VikingMotorsports/Battery-Management-System-Capstone-2026/docs/Final_Project_Report/Section_7.tex

Our test plan consists of a top-down test and the bottom-up subsystem tests. These tests will test Overvoltage, Undervoltage, and Overcurrent and the system will set the signal for the Shutdown Circuit and report each specific fault to the ECU with which specific cell(s) had the fault. The full Test plan is in the Appendices.
