VikingMotorsports/Battery-Management-System-Capstone-2026/docs/Final_Project_Report/glossary.tex

\makeglossaries
\newacronym{vms}{VMS}{Viking Motorsports}
\newacronym{bms}{BMS}{Battery Management System}
\newacronym{ecu}{ECU}{Energy Control Unit}
\newacronym{can}{CAN}{Control Area Network}
\newacronym{can-fd}{CAN-FD}{\gls{can} Fast Data}
\newacronym{bmu}{BMU}{Battery Management Unit}
\newacronym{i2c}{I$^2$C}{Inter-Integrated Circuit}
\newacronym{led}{LED}{Light Emitting Diode}
\newacronym{lv}{LV}{Low Voltage}
\newacronym{hv}{HV}{High Voltage}
\newacronym{usb}{USB}{Universal Serial Bus}
\newacronym{mvp}{MVP}{Minimal Viable Product}
\newacronym{pcb}{PCB}{Printed Circuit Board}
