VikingMotorsports/Battery-Management-System-Capstone-2026/docs/Final_Project_Report/Section_4.tex

\subsection{Objectives}

The main objective of our project is to have a functional prototype or \gls{mvp} and creating extensive documentation featuring design decision with our reasoning, a user's guide, and a developer's manual to assemble the full battery back. While there was some expectation to have our prototype go through one design iteration with \gls{pcb}, our team wasn't able to order the boards early enough and such we had to go with a prototype using the evualtion boards.

\subsection{Deliverables}

While intialy using the Atlassian suite of tools of Jira and Confluence, we moved to google drive and github repository so that we can transfer ownership to \gls{vms} to deliver on the following

\begin{itemize}
	\item Project proposal
	\item Weekly Progress Reports
	\item Final report
	\item ECE Capstone Poster Session poster
	\item Detailed design documentation, explaining what your design does, how your design works, and why you made the decisions you did
	\item Electrical CAD: Schematics and board layouts, including output files (Gerbers, PDFs, etc)
	\item Mechanical CAD: enclosures, mechanisms, including output files (STLs, PDFs, etc)
	\item Bill of materials and pricing
	\item Developer's manual for future teams improveing on the existing design
	\item Short user manuals documenting how to use your creation
	\item A working prototype with a prototype battery pack and functionality with the \gls{ecu} prototype.
\end{itemize}
