VikingMotorsports/Battery-Management-System-Capstone-2026/docs/Final_Project_Report/Section_2.tex

\gls{vms} is our sponsor. They are a medium-sized student group that participates in the Formula SAE Electric event.

Electric vehicles rely entirely on large battery packs as their primary energy source. These battery packs are made up of many individual cells, typically lithium-ion, that must operate within some strict electrical and thermal limits and requirements in order for them to remain safe, efficient, and long-lasting. Due to the fact that lithium-ion battery chemistry is sensitive to properties such as overcharging, over-discharging, overheating/temperature, and cell imbalance, electric vehicles often require a dedicated subsystem called the \gls{bms}, to monitor and protect the battery.

These systems exist because lithium-ion battery packs can be extremely dangerous if not carefully monitored and diagnosed. The individual cells can be damaged due to things such as overcharging, over-discharging, and overheating. So, electric vehicles incorporate a battery management system to act as a protective mechanism using a combination of sensing, diagnostics, and protective circuit logic within the system. The system ensures that the battery operates only within safe electrical and thermal limits, which can in turn improve safety, extend battery life, and optimize performance.

The battery management system continuously measures key parameters such as cell voltages, current flow, pack and cell temperatures, and the estimated state of charge. It then processes the data to compute additional metrics, such as pack health, state of energy, imbalance levels, and thermal stability. In addition to monitoring, the \gls{bms} controls balancing circuitry using techniques such as active or passive cell balancing, to keep individual cells at consistent charge levels. Additionally, the \gls{bms} manages protective actions such as overvoltage, undervoltage, and overcurrent cutoffs. Also, the \gls{bms} communicates diagnostic information, warnings, and operational status to the vehicle’s electronic control unit.

Within the larger electric vehicle system, the \gls{bms} serves as the central system responsible for determining whether the high-voltage battery pack is in a safe condition to deliver power to the vehicle. For instance, the electronic control unit depends on the \gls{bms} for accurate state of charge information, temperature status, and diagnostic reports. The motor, motor controller, charger, and thermal management system all rely on \gls{bms} outputs to function properly. Therefore, the \gls{bms} is not an isolated system but rather a core subsystem and safety component that interfaces with a lot of other components in the vehicle.

In practice, a battery management system is an electronic system that manages a rechargeable battery pack. Its operation follows a continuous loop of measure, protect, balance, and inform. First, it measures the fundamental state of the battery by using a network of sensors and integrated circuits to read the voltage of every individual cell, the total current flowing in or out of the pack, and its temperature at key locations. Second, it uses this data to protect the battery from damage by comparing the readings against safe limits. For instance, if it detects a dangerous condition like overvoltage, undervoltage, overcurrent, or extreme temperatures, it will command a safe shutdown by disconnecting the pack. Third, to maximize the pack’s capacity and longevity, it balances the cells, using techniques such as active or passive cell balancing to bleed off excess charge from higher voltage cells, ensuring all cells reach a uniform state of charge. Finally, it informs the larger system by processing the raw measurements into useful information such as state of charge and health, and it communicates this data, along with any warnings, to other devices.

According to the project description provided by Viking Motorsports, the electrical team has completed early conceptual research for the Formula SAE Electric platform. This foundational work includes preliminary investigation into CAN bus communication for vehicle subsystem networking, initial evaluation of cell monitoring integrated circuits and measurement topologies for per-cell voltage sensing, and high-level planning of the system-level safety architecture required to meet Formula SAE Electric fail-safe shutdown and interlock rules. These efforts established an initial understanding of the technical challenges and constraints associated with a high-voltage accumulator system but did not result in an implemented or tested \gls{bms} design.

At the start of this capstone project, no functional \gls{bms} hardware or firmware prototype exists, and there is no previous generation of a Viking Motorsports \gls{bms} to revise or extend. As a result, this project represents a ground-up design and development effort rather than an incremental revision. Our team is responsible for transforming the sponsor’s early conceptual research into a testable \gls{bms} prototype that performs real-time measurement, protection, balancing, and diagnostic functions that are suitable for future vehicle integration.

If nothing has been done on this project yet, are there comparable products or existing alternatives? Be creative here, what are similar technologies or direct competitors? Include them if they’re relevant or help describe your project.

See commercial off the shelf products and open source projects sections of the project proposal.

\subsection{Research}

\begin{figure}[H]
	
\end{figure}

\subsubsection{Commercial Off-the-Shelf Products}
Here are some options available to us for this project:

\begin{enumerate}
	\item \textbf{Orion \gls{bms} 2:} The Orion \gls{bms} 2 is a widely adopted \textbf{Centralized} solution in the FSAE and EV conversion sectors. While it integrates all measurement and control units into a single enclosure, offering mature reliability and EMI immunity, its architecture requires routing extensive sensing harnesses from all points of the battery pack to a central controller. This results in complex wiring and increased system weight. This serves as a critical counter-reference for our project: while centralized designs offer EMI advantages, their disadvantages in harness management within a high-voltage (300V+) and weight-critical racing environment validate our decision to pursue a Distributed Architecture.
	
	\item \textbf{Stafl Systems \gls{bms}1000M:} Stafl Systems utilizes a \textbf{Master-Slave Distributed Topology}. The system consists of a master controller (\gls{bms}1000M) and multiple satellite monitoring modules (\gls{bms}1101S), utilizing differential signaling (e.g., IsoSPI) for communication. This architecture significantly reduces the length of analog sensing wires, effectively lowering wiring complexity within the high-voltage pack. As a direct industry benchmark, Stafl demonstrates the engineering feasibility of distributed architectures for segmented packs. However, its Closed-Source nature limits secondary development for specific research algorithms, restricting its role to a hardware architecture reference.
	
	\item \textbf{EMUS G1 \gls{bms}:} EMUS G1 demonstrates a highly \textbf{Modular} distributed strategy, supporting the connection of multiple independent battery modules via CAN bus. This product employs robust galvanic isolation strategies and communication protocols ideal for physically separated battery enclosures (e.g., side-pod layouts). Given the potential requirement to split our 400V pack into multiple physical modules, EMUS provides a critical technical reference for High-Voltage Galvanic Isolation and data synchronization in our safety loop design.
\end{enumerate}

\subsubsection{Open Source Projects}
Here are some projects we can borrow from:

\begin{enumerate}
	\item \href{https://docs.fox\gls{bms}.org/}{fox\gls{bms} 2:} fox\gls{bms} 2 is a comprehensive, professionally developed open-source \gls{bms} platform from the Fraunhofer research institute, explicitly designed as a research and development platform for high-performance, high-availability battery systems. Its architecture is a master-slave distributed topology, where a central \gls{bms}-Master (ARM Cortex-R5) communicates via an interface board with daisy-chained Slave boards that handle cell monitoring (voltage/temperature) and passive balancing. The primary benefit is its exceptional depth. For instance, it offers a complete, well-documented hardware and software stack, including a built-in interlock line for safety shutdowns, CAN bus communication for system integration, and a flexible design that supports from a few cells up to several hundred kWh. The permissive licenses allow full use and modification. The notable drawback is its scale and complexity. For instance, as a generic research platform, it is not optimized for the strict space, weight, and FSAE-rule constraints of a race car. Its default use case is stationary storage, requiring significant adaptation for a mobile, high-vibration environment such as a race car. Nonetheless, it still serves as a great resource for robust system architecture, safety implementations such as interlock monitoring, and professional-grade, modular firmware structure.
	
	\item \href{https://libre.solar/\gls{bms}-c1/manual/}{Libre Solar \gls{bms}:} The Libre Solar \gls{bms} is a compact, fully integrated open-source \gls{bms} designed for stationary and small-scale mobile DC energy systems (12V-48V, up to 16 cells). Its architecture is highly centralized, combining the \gls{bms} Analog Front-End (Texas Instruments BQ76952), microcontroller (ESP32-C3), power MOSFETs, and communication interfaces (CAN, UART, I2C, USB, Bluetooth) on a single PCB. The primary benefit is its production-ready, all-in-one design that demonstrates efficient integration of core \gls{bms} functions such as cell monitoring, protection, passive balancing, and contactor control, within a minimal footprint. Its firmware, built on the Zephyr RTOS, provides a professional reference for implementing safety logic, the ThingSet protocol for configuration, and state-of-charge estimation. The notable drawback is its scale. For instance, it is designed for ~60V systems with currents up to 100A, its cell count and power handling are far below the requirements of a 400V+ FSAE powertrain. Its centralized architecture is also less ideal for the long, distributed battery pack typical in a race car frame. Nonetheless, it still serves as an excellent reference for PCB-level integration, component selection, and a clean, modular firmware structure that can inform the design of sub-modules within our larger, distributed system.
	
	\item \href{https://hackaday.io/project/181453-green-\gls{bms}}{Green \gls{bms}:} Green \gls{bms} is a hobbyist-developed, smart \gls{bms} designed for small-scale lithium battery packs such as for electric scooters or solar storage. Its architecture is a modular distributed system, using simple Cell Modules based on ATtiny microcontrollers to measure individual cell voltage/temperature, which report via I2C to a central Control Unit (Arduino Mega). The system includes a separate "Limiter" unit for contactor control and an Android app for monitoring. The primary benefit is its exceptional transparency and simplicity, it demonstrates the absolute core functions of a \gls{bms} (monitoring, protection, balancing) with minimal complexity, using widely understood components (Arduino, ATtiny). This makes it an excellent educational tool for understanding the fundamental data flow and logic of a \gls{bms} before engaging with more complex, integrated circuits. The significant drawbacks are its lack of automotive robustness, missing critical safety features (high-voltage isolation, CAN bus, fail-safe hardware interlocks), and limited scalability (I2C communication is unsuitable for long daisy-chains in a large pack). Nonetheless, it still serves as a valuable conceptual reference for system partitioning and basic 
\end{enumerate}

\subsubsection{Papers}
Here is some extra papers we read during our research:

\begin{enumerate}
	\item \href{https://web.archive.org/web/20200508032842id_/https://eprint.ncl.ac.uk/file_store/production/261931/F4ADEC30-2EDD-4881-A81A-AC0BFDE3D9EB.pdf}{Evaluation and Comparison of Battery Cell Balancing Methods:} This paper provides a structured, quantitative framework for selecting a cell balancing topology, directly addressing a key design decision. It categorizes and compares the three main balancing methods, dissipative (passive), capacitive energy transfer (active), and runtime balancing (active with converters), against critical metrics such as balancing speed, efficiency, complexity, and cost. This comparison is very valuable for our requirement to “support both active and passive cell balancing.” It provides an objective basis to decide whether to implement only passive (simpler, cheaper) or also include an active method (faster, more efficient) in our prototype.
	
	\item \href{https://ieeexplore.ieee.org/stamp/stamp.jsp?arnumber=8834858}{Review of Battery Cell Balancing Methodologies for Optimizing Battery Pack Performance in Electric Vehicles:} This paper provides a critical system-level perspective on cell balancing for batteries in electric vehicles, advocating for hybrid balancing methods that combine passive and active balancing techniques to leverage their respective advantages. This directly aligns with our requirement to “support both active and passive cell balancing,” suggesting an approach where both techniques work together in a complimentary manner (passive for continuous maintenance, active for rapid pre-charge equalization). Additionally, it highlights environmental factors, specifically operating temperature, thermal uniformity, and mechanical vibration, as crucial but under-researched variables that affect long-term balancing performance and cell degradation.
	
	\item \href{https://ieeexplore.ieee.org/stamp/stamp.jsp?arnumber=8320763}{State-of-the-Art and Energy Management System of Lithium-Ion Batteries in Electric Vehicle Applications: Issues and Recommendations:} This paper provides a holistic overview of Li-ion battery technology and the complete scope of a Battery Management System (\gls{bms}). It systematically covers core \gls{bms} functions critical to our project, such as cell condition monitoring, state estimation (SOC/SOH), charge/discharge control, protection circuitry, cell equalization, and thermal management. It is particularly valuable for understanding the interdependencies between different \gls{bms} subsystems and for identifying key challenges, such as managing temperature gradients and diagnosing faults, which are actively relevant to the harsh, high-vibration environment of a Formula SAE vehicle.
\end{enumerate}

%  Add extra research HERE
