VikingMotorsports/Battery-Management-System-Capstone-2026/docs/VB-Devices In Consideration-120626-191535.pdf

Devices In Consideration

What it comes with:

Boards

2x EVAL-ADBMS6830BMSW 16-Channel Battery Cell Monitor (can be purchased separately)

1x EVAL-ADBMS2950-BASIC Battery Pack Monitor (can be purchased separately)

1x EVAL-ADBMS6822 Dual isoSPI Adapter (can be purchased separately)

1x EVAL-SDP-CK1Z (SDP-K1) Controller Board (can be purchased separately)

2x DC2472A Battery Cell Emulator (can be purchased separately)

1x MAX32625PICO Programming Adapter with 10-pin SWD cable (can be purchased separately)

Cables and Other Accessories

2x Cell Connector Block (18-cell connector)

3x DuraClik isoSPI Twisted Pair Cables

3x USB Type A to Micro-B Cable

3x Alligator Clip / Test Lead

What it does:

Accurate voltage and current measurement

Highly scalable and ease of integration

Robust isoSPI capability implementable in daisy chain high count

Inclusive passive balancing with individual pulse-width modulation

Isolated power supply between microcontroller and battery monitoring devices

High voltage and current supply measurement

Fast overcurrent (OC) measurement

Redundancy measurement

Modular BMS Solution

Ready to use Broadmarket BMS GUI for Evaluation

Isolation:

Analog Devices (more common in UART-style isolation)

AD-CELLPACKBM-SL (https://www.analog.com/en/resources/evaluation-hardware-and-software/evaluation-boards-kits/ad-cellpackbm-sl.html)
