VikingMotorsports/Battery-Management-System-Capstone-2026/Hardware/CMU BOM.xlsx

CMU BOM
Ref | Qty | IC / Function | Manufacturer Part Number | DigiKey Part Number | Package | Notes | Links
C1-C18, C20-C28, C30-C37 | 35 | 0.47uF capacitor | CS0805KKX7R9BB474 | 13-CS0805KKX7R9BB474CT-ND | 0805 SMD | 0.47uF, 50V, X7R, ±10%. | https://www.digikey.com/en/products/detail/yageo/CS0805KKX7R9BB474/6097940
C19, C29, C38-C40, C47 | 6 | 100pF capacitor | CC0805KRNPO9BN101 | 311-4295-1-ND | 0805 SMD | 100pF, 50V, C0G/NP0. | https://www.digikey.com/en/products/detail/yageo/CC0805KRNPO9BN101/5884169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
C41, C46, C48 | 3 | 1uF capacitor | C0805C105K5RACTU | 399-C0805C105K5RACTUCT-ND | 0805 SMD | 1uF, 50V, X7R, ±10%. | https://www.digikey.com/en/products/detail/kemet/C0805C105K5RACTU/3317615
C42, C43, C51-C58 | 10 | 0.1uF / 100nF capacitor | C0805X104K050T | 4587-C0805X104K050TCT-ND | 0805 SMD | 0.1uF, 50V, X7R, ±10%. | https://www.digikey.com/en/products/detail/holy-stone-enterprise-co-ltd/C0805X104K050T/16895237
C44 | 1 | 0.22uF capacitor | 885382207008 | 732-13196-1-ND | 0805 SMD | 0.22uF, 50V, X7R, ±10%. | https://www.digikey.com/en/products/detail/w%C3%BCrth-elektronik/885382207008/9816351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
C45 | 1 | 10nF capacitor | C0805C103K5RECAUTO | 399-17885-1-ND | 0805 SMD | 10nF, 50V, X7R, ±10%. | https://www.digikey.com/en/products/detail/kemet/C0805C103K5RECAUTO/8640479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
C49 | 1 | 4.7uF capacitor | C0805X475K025T | 4587-C0805X475K025TCT-ND | 0805 SMD | 4.7uF, 25V, X7R, ±10%. | https://www.digikey.com/en/products/detail/holy-stone-enterprise-co-ltd/C0805X475K025T/16895241
C50 | 1 | 2.2uF capacitor | 885012207079 | 732-7673-1-ND | 0805 SMD | 2.2uF, 25V, X7R, ±10%. | https://www.digikey.com/en/products/detail/w%C3%BCrth-elektronik/885012207079/5453528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
D1 | 1 | Status LED | LTST-C170KGKT | 160-1414-1-ND | 0805 SMD | Green LED. | https://www.digikey.com/en/products/detail/liteon/LTST-C170KGKT/386777?s=N4IgTCBcDaIIwDYAMBaOAWDaUDkAiIAugL5A
J1 | 1 | TEST header | 61300211121 | 732-5315-ND | 1x02, 2.54mm | Vertical 2-pin header. | https://www.digikey.com/en/products/detail/w%C3%BCrth-elektronik/61300211121/4846823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
J2, J5 | 2 | LOW SIDE / HIGH SIDE connector | 705510038 | WM14059-ND | 4-position, 2.54mm, right angle | Molex right-angle header. | https://www.digikey.com/en/products/detail/molex/0705510038/3468768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
J3 | 1 | 12S header | 61300211121 | 732-5315-ND | 1x02, 2.54mm | Vertical 2-pin header. | https://www.digikey.com/en/products/detail/w%C3%BCrth-elektronik/61300211121/4846823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
J4 | 1 | Board connector | 705550056 | 0705550056-ND | 22-position, 2.54mm, right angle | Molex right-angle header. Confirm exact function. | https://www.digikey.com/en/products/detail/molex/0705550056/3302485?s=N4IgTCBcDaIAwHY4FZVxQNgLQDkAiIAugL5A
J6-J13 | 8 | NTC headers | 61300211121 | 732-5315-ND | 1x02, 2.54mm | Vertical 2-pin headers for NTC sensors. | https://www.digikey.com/en/products/detail/w%C3%BCrth-elektronik/61300211121/4846823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
R1-R9, R23-R30 | 17 | 10Ω resistor | RC1210FR-0710RL | 13-RC1210FR-0710RLCT-ND | 1210 SMD | 10Ω, ±1%, 1/2W, thick film resistor. | https://www.digikey.com/en/products/detail/yageo/RC1210FR-0710RL/5919199
R10, R11, R21, R22, R48, R49, R53, R54 | 8 | 0Ω jumper resistor | RC0805JR-070RL | 311-0.0ARCT-ND | 0805 SMD | 0Ω jumper, 1/8W, thick film resistor. | https://www.digikey.com/en/products/detail/yageo/RC0805JR-070RL/728216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
R12-R20, R33-R40 | 17 | 100Ω resistor | RC0805FR-07100RL | 311-100CRCT-ND | 0805 SMD | 100Ω, ±1%, 1/8W, thick film resistor. | https://www.digikey.com/en/products/detail/yageo/RC0805FR-07100RL/727543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
R31, R32, R45, R46 | 4 | 51Ω resistor | RC0805FR-0751RL | 311-51.0CRCT-ND | 0805 SMD | 51Ω, ±1%, 1/8W, thick film resistor. | https://www.digikey.com/en/products/detail/yageo/RC0805FR-0751RL/728012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
R41-R44 | 4 | 499Ω resistor | RC0805FR-07499RL | 311-499CRCT-ND | 0805 SMD | 499Ω, ±1%, 1/8W, thick film resistor. | https://www.digikey.com/en/products/detail/yageo/RC0805FR-07499RL/727986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
R47 | 1 | 30Ω resistor | RMC1/2K30R0FTE | 2315-RMC1/2K30R0FTETR-ND | 2010 SMD | 30Ω, ±1%, high-power resistor. Verify power rating. | https://www.digikey.com/en/products/detail/kamaya-inc/RMC1-2K30R0FTE/17822375
R50 | 1 | 100Ω resistor | RMCF2010FT100R | RMCF2010FT100RCT-ND | 2010 SMD | 100Ω, ±1%, 3/4W, thick film resistor. | https://www.digikey.com/en/products/detail/stackpole-electronics-inc/RMCF2010FT100R/1758424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
R51 | 1 | 200Ω resistor | RMCF2010FT200R | RMCF2010FT200RCT-ND | 2010 SMD | 200Ω, ±1%, 3/4W, thick film resistor. | https://www.digikey.com/en/products/detail/stackpole-electronics-inc/RMCF2010FT200R/1716050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
R52 | 1 | 4.7kΩ resistor | ERJ-S1DF4701U | ERJ-S1DF4701U-ND | 2010 SMD | 4.7kΩ, ±1%, 3/4W, thick film resistor. | https://www.digikey.com/en/products/detail/panasonic-industry/ERJ-S1DF4701U/1019049
R55-R62 | 8 | 10kΩ resistor | RC0805FR-0710KL | 311-10.0KCRCT-ND | 0805 SMD | 10kΩ, ±1%, 1/8W, thick film resistor. | https://www.digikey.com/en/products/detail/yageo/RC0805FR-0710KL/727535
T1, T2 | 2 | Isolation transformer | CEP99102 | Not found on DigiKey | CEP99102 | Sumida BMS pulse transformer. Use Mouser | https://www.mouser.com/ProductDetail/Sumida/CEP99-102
U1, U2 | 2 | ESD protection diode | PESD5V0L2BT,215 | 1727-3834-1-ND | SOT-23 | Signal ESD protection. | https://www.digikey.com/en/products/detail/nexperia-usa-inc/PESD5V0L2BT-215/1157454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
U3 | 1 | NPN transistor / protection device | ZXTN4004KQTC | 31-ZXTN4004KQTCCT-ND | TO-252 / DPAK |  | https://www.digikey.com/en/products/detail/diodes-incorporated/ZXTN4004KQTC/5306217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
U4 | 1 | Battery monitor IC | BQ79616PAPRQ1 | 296-BQ79616PAPRQ1CT-ND | 64-HTQFP | Main CMU battery monitor IC. | https://www.digikey.com/en/products/detail/texas-instruments/BQ79616PAPRQ1/13627120
