VikingMotorsports/Battery-Management-System-Capstone-2026/Hardware/BMU BOM.xlsx

BMU BOM
Item | Reference | Qty | Value / Part Number | Footprint / Package | Description | Manufacturer / MPN | Supplier | Notes | Link
1 | C1, C2 | 2 | 10uF | C_0805_2012Metric | Capacitor, SMD 0805 | TBD | Lab Stock / Digi-Key / Mouser | Common capacitor
2 | C3, C4, C5, C6, C7, C8 | 6 | 100pF | C_0805_2012Metric | Capacitor, SMD 0805 | TBD | Lab Stock / Digi-Key / Mouser | Common capacitor
3 | C9, C12, C13, C15, C16, C17 | 6 | 0.1uF / 100nF | C_0805_2012Metric | Capacitor, SMD 0805 | TBD | Lab Stock / Digi-Key / Mouser | Common decoupling capacitor
4 | C10, C11 | 2 | 0.22uF | C_0805_2012Metric | Capacitor, SMD 0805 | TBD | Lab Stock / Digi-Key / Mouser | Common capacitor
5 | C14 | 1 | 1uF | C_0805_2012Metric | Capacitor, SMD 0805 | TBD | Lab Stock / Digi-Key / Mouser | Common capacitor
6 | CR1 | 1 | MMSZ5245B-7-F | SOD123_DIO | Zener diode | MMSZ5245B-7-F | Digi-Key / Mouser | Protection diode
7 | CR2 | 1 | ESDCAN03-2BWY | SOT323-3L_STM | CAN ESD protection diode | ESDCAN03-2BWY | Digi-Key / Mouser | CAN protection
8 | D1, D2 | 2 | GRN | LED_0805_2012Metric_Pad1.15x1.40mm_HandSolder | Green LED, SMD 0805 | TBD | Digi-Key / Mouser | Status LED
9 | D3 | 1 | LED | LED_0805_2012Metric_Pad1.15x1.40mm_HandSolder | LED, SMD 0805 | TBD | Digi-Key / Mouser | Status LED
10 | F1 | 1 | Fuse | Fuse_1206_3216Metric | Fuse, SMD 1206 | TBD | Digi-Key / Mouser | Input protection fuse
11 | IC1 | 1 | STM32C092RCT6 | QFP50P1200X1200X160-64N | STM32 microcontroller | STM32C092RCT6 | Digi-Key / Mouser | Main MCU
12 | J1, J2 | 2 | 705510038 | 705510038 | High-side / low-side connector | 705510038 | Digi-Key / Mouser | External COM connectors
13 | J3 | 1 | POWER | PinHeader_1x04_P2.54mm_Vertical | Power pin header | TBD | Digi-Key / Mouser | 12V input / GND
14 | J4 | 1 | GPIO | PinHeader_1x05_P2.54mm_Vertical | GPIO pin header | TBD | Digi-Key / Mouser | GPIO spare / shutdown
15 | J5, J7, J8 | 3 | pin header / 5V / 3V3 | PinHeader_1x02_P2.54mm_Vertical | 2-pin header | TBD | Digi-Key / Mouser | Fault LED / 5V / 3V3 headers
16 | J6 | 1 | 69138200003 | 69138200003 | CAN connector | 69138200003 | Digi-Key / Mouser | To ECU CAN interface
17 | J9 | 1 | GND | PinHeader_1x04_P2.54mm_Vertical | GND pin header | TBD | Digi-Key / Mouser | Ground test / access header
18 | J10 | 1 | SHUNT | PinHeader_1x10_P2.54mm_Vertical | Shunt connector header | TBD | Digi-Key / Mouser | 3V3 / I2C / ALERT / GND
19 | J11 | 1 | Conn_ST_STDC14 | PinHeader_2x07_P1.27mm | STDC14 SWD debug connector | TBD | Digi-Key / Mouser | MCU programming/debug
20 | Q1 | 1 | DMP3099L | SOT-23 | P-channel MOSFET | DMP3099L | Digi-Key / Mouser | Power path / protection
21 | R1, R22, R23 | 3 | 100kΩ | R_0805_2012Metric | Resistor, SMD 0805 | TBD | Lab Stock / Digi-Key / Mouser | Common resistor
22 | R2, R3, R27, R28 | 4 | 1kΩ | R_0805_2012Metric | Resistor, SMD 0805 | TBD | Lab Stock / Digi-Key / Mouser | Common resistor
23 | R4, R5, R6, R7, R8, R9, R10, R11 | 8 | 0Ω | R_0805_2012Metric | 0-ohm resistor / jumper | TBD | Lab Stock / Digi-Key / Mouser | Configuration jumper
24 | R12, R13, R14, R15 | 4 | 51Ω | R_0805_2012Metric | Resistor, SMD 0805 | TBD | Lab Stock / Digi-Key / Mouser | Common resistor
25 | R16, R17, R18, R19 | 4 | 499Ω | R_0805_2012Metric | Resistor, SMD 0805 | TBD | Lab Stock / Digi-Key / Mouser | Common resistor
26 | R20 | 1 | 10Ω | R_0805_2012Metric | Resistor, SMD 0805 | TBD | Lab Stock / Digi-Key / Mouser | Common resistor
27 | R21, R24, R25 | 3 | 10kΩ | R_0805_2012Metric | Resistor, SMD 0805 | TBD | Lab Stock / Digi-Key / Mouser | Common resistor
28 | R26 | 1 | 120Ω | R_0805_2012Metric | CAN termination resistor | TBD | Lab Stock / Digi-Key / Mouser | CAN termination
29 | SW1 | 1 | Power Switch | SW_DIP_SPSTx01_Slide_9.78x4.72mm_W7.62mm_P2.54mm | Slide power switch | TBD | Digi-Key / Mouser | Power switch
30 | SW2 | 1 | SW_Push | SW_PUSH_6mm_H4.3mm | Push button switch | TBD | Digi-Key / Mouser | Reset / user button
31 | T1, T2 | 2 | CEP99-102 | CEP99102 | Transformer / isolation component | CEP99-102 | Digi-Key / Mouser | Verify exact function from schematic
32 | U1 | 1 | OKI-78SR-5_1.5-W36-C | Converter_DCDC_Murata_OKI-78SR_Vertical | DC-DC converter module | OKI-78SR-5/1.5-W36-C | Digi-Key / Mouser | 12V to 5V converter
33 | U2 | 1 | TLV75533PDBV | SOT-23-5 | 3.3V linear regulator | TLV75533PDBV | Digi-Key / Mouser | 5V to 3.3V regulator
34 | U3, U4 | 2 | PESD5V0L2BT | SOT23_NEX | ESD protection diode | PESD5V0L2BT | Digi-Key / Mouser | Signal protection
35 | U5 | 1 | BQ79600PWRQ1 | TSSOP16_PW_TEX | Battery communication bridge IC | BQ79600PWRQ1 | Digi-Key / Mouser | BQ communication bridge
36 | U6 | 1 | MCP2562FDT-H_SN | SOIC127P600X175-8N | CAN transceiver | MCP2562FDT-H/SN | Digi-Key / Mouser | CAN interface
