VikingMotorsports/Battery-Management-System-Capstone-2026/Hardware/VMS-BMS libraries/3DModels/100SP1T1B4M2QE.step

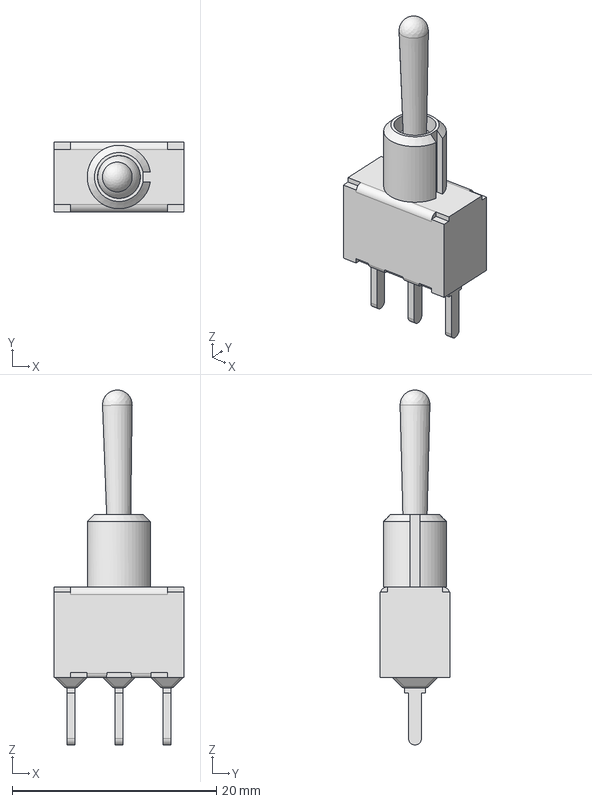
[picture p17: CAD file, 2026-05-30]
Hardware/VMS-BMS libraries/3DModels/100SP1T1B4M2QE.step
12.7 x 6.86 x 34.8 mm
