VikingMotorsports/Battery-Management-System-Capstone-2026/Hardware/VMS-BMS libraries/3DModels/OKI-78SR-5_1.5-W36-C.step

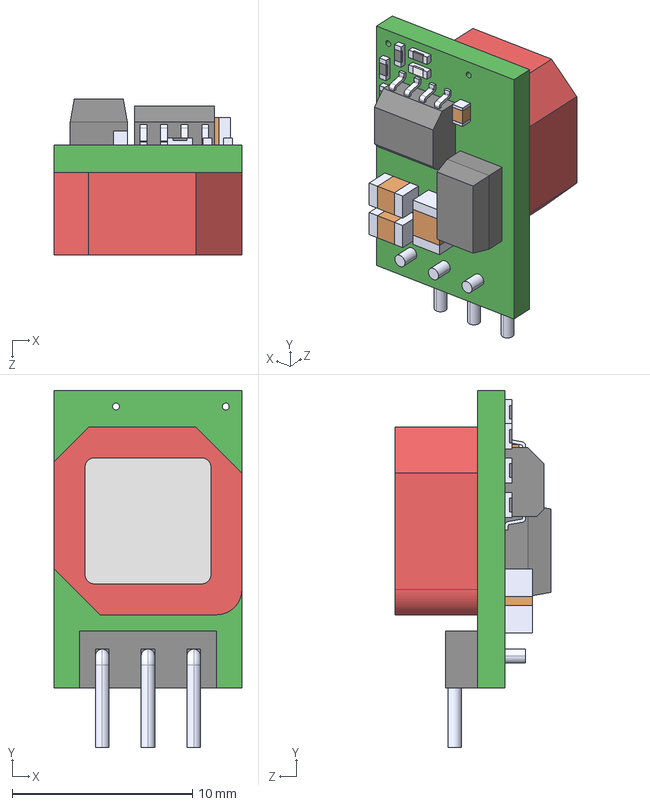
[picture p18: CAD file, 2026-05-09]
Hardware/VMS-BMS libraries/3DModels/OKI-78SR-5_1.5-W36-C.step
10.4 x 19.8 x 8.64 mm
