VikingMotorsports/Battery-Management-System-Capstone-2026/Hardware/VMS-BMS libraries/3DModels/MCP2562FDT-H_SN.step

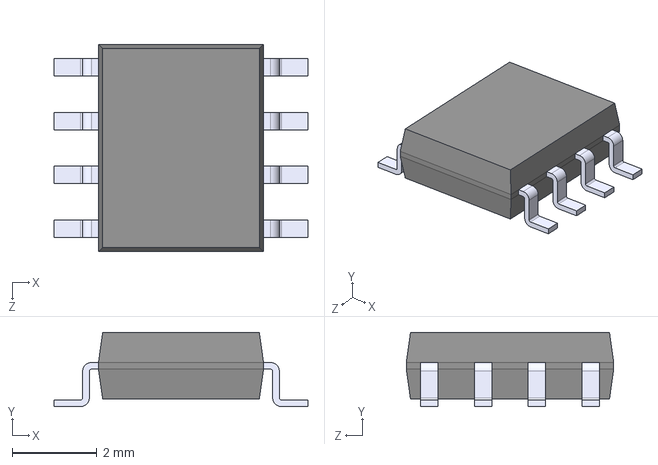
[picture p19: CAD file, 2026-05-09]
Hardware/VMS-BMS libraries/3DModels/MCP2562FDT-H_SN.step
6.00 x 1.75 x 4.90 mm
