VikingMotorsports/Battery-Management-System-Capstone-2026/Hardware/VMS-BMS libraries/3DModels/691382000003.step

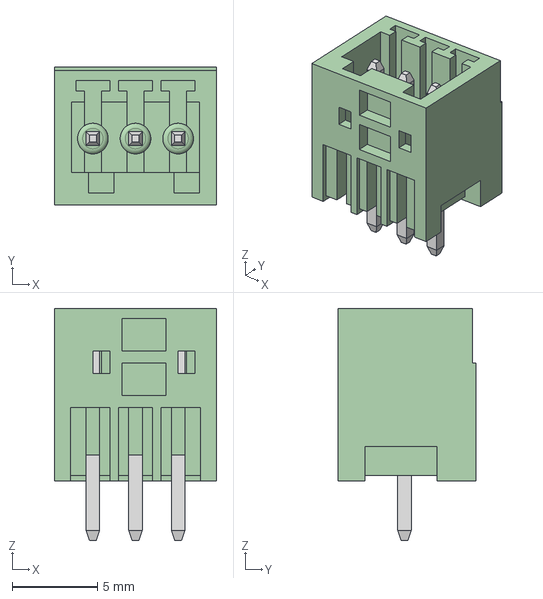
[picture p20: CAD file, 2026-05-09]
Hardware/VMS-BMS libraries/3DModels/691382000003.step
9.50 x 8.10 x 13.6 mm
6913820000xx_PIN x 3
