VikingMotorsports/Battery-Management-System-Capstone-2026/docs/VB-Meeting Notes-120626-190509.pdf

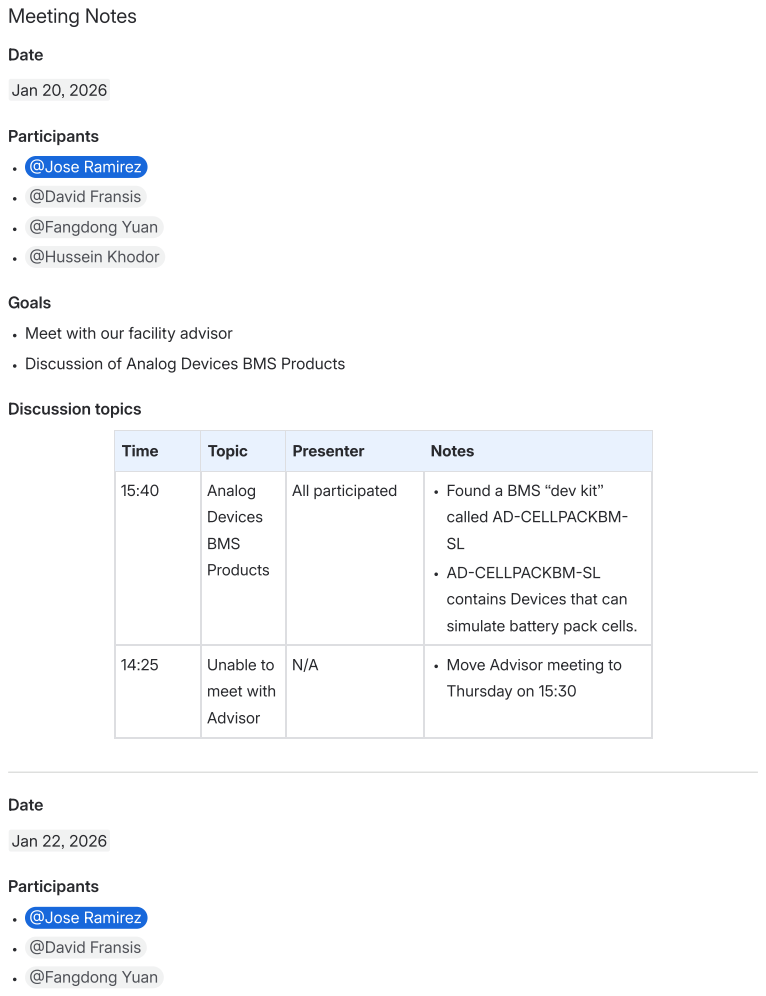
[picture p21: page 1]
Meeting Notes; Date; Jan 20, 2026; Participants; @Jose Ramirez; @David Fransis; @Fangdong Yuan; @Hussein Khodor; Goals; Discussion topics; Jan 22, 2026

Meet with our facility advisor

Discussion of Analog Devices BMS Products

Time | Topic | Presenter | Notes

15:40 | Analog Devices BMS Products | All participated | Found a BMS “dev kit” called AD-CELLPACKBM-SL AD-CELLPACKBM-SL contains Devices that can simulate battery pack cells.

14:25 | Unable to meet with Advisor | N/A | Move Advisor meeting to Thursday on 15:30

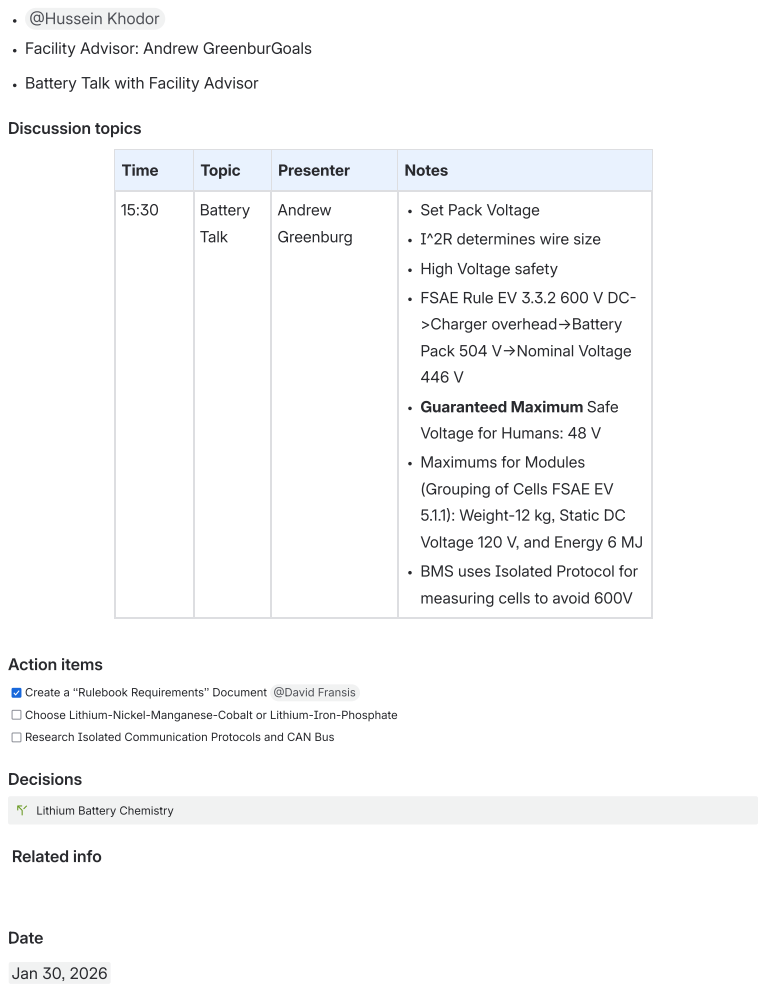
[picture p22: page 2]
@Hussein Khodor; Discussion topics; Action items; Decisions; Related info; Date; Jan 30, 2026; Battery; Talk; Andrew; Greenburg; Time; Topic; Presenter; Notes

Facility Advisor: Andrew GreenburGoals

Battery Talk with Facility Advisor

Set Pack Voltage

I^2R determines wire size

High Voltage safety

FSAE Rule EV 3.3.2 600 V DC-

>Charger overhead->Battery

Pack 504 V->Nominal Voltage

Guaranteed Maximum Safe

Voltage for Humans: 48 V

Maximums for Modules

(Grouping of Cells FSAE EV

5.1.1): Weight-12 kg, Static DC

Voltage 120 V, and Energy 6 MJ

BMS uses Isolated Protocol for

measuring cells to avoid 600V

Create a “Rulebook Requirements” Document @David Fransis

Choose Lithium-Nickel-Manganese-Cobalt or Lithium-Iron-Phosphate

Research Isolated Communication Protocols and CAN Bus

Lithium Battery Chemistry

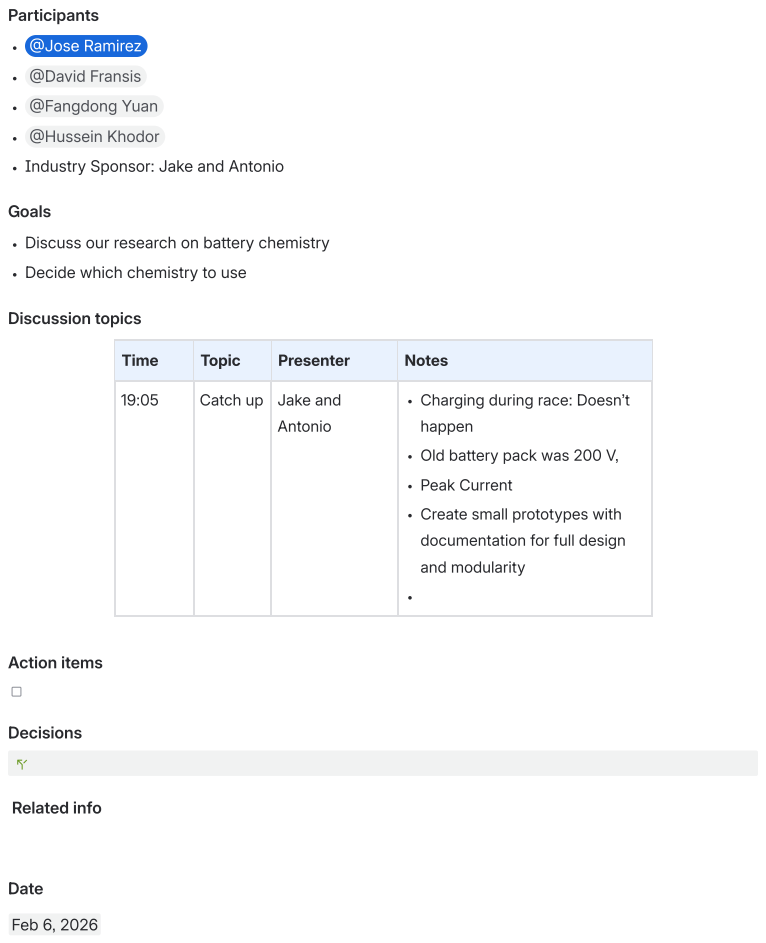
[picture p23: page 3]
Participants; @Jose Ramirez; @David Fransis; @Fangdong Yuan; @Hussein Khodor; Goals; Discussion topics; Action items; Decisions; Related info; Date; Feb 6, 2026

Industry Sponsor: Jake and Antonio

Discuss our research on battery chemistry

Decide which chemistry to use

Time | Topic | Presenter | Notes

19:05 | Catch up | Jake and Antonio | Charging during race: Doesn’t happen Old battery pack was 200 V, Peak Current Create small prototypes with documentation for full design and modularity

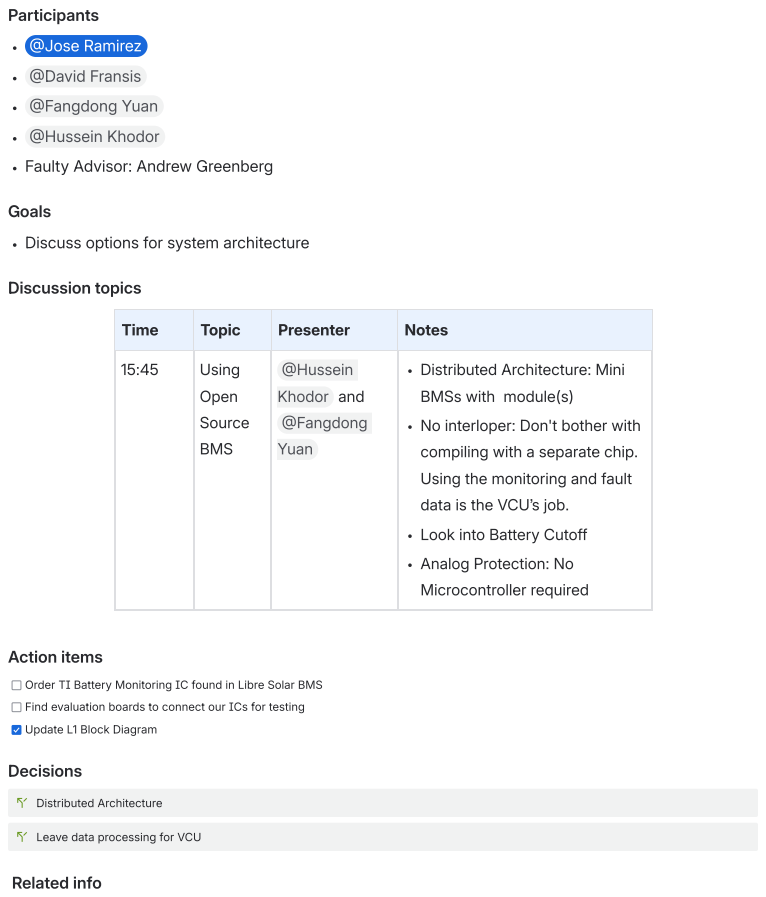
[picture p24: page 4]
Participants; @Jose Ramirez; @David Fransis; @Fangdong Yuan; @Hussein Khodor; Goals; Discussion topics; Action items; Decisions; Related info; Distributed Architecture

Faulty Advisor: Andrew Greenberg

Discuss options for system architecture

Time | Topic | Presenter | Notes

15:45 | Using Open Source BMS | @Hussein Khodor and @Fangdong Yuan | Distributed Architecture: Mini BMSs with module(s) No interloper: Don't bother with compiling with a separate chip. Using the monitoring and fault data is the VCU’s job. Look into Battery Cutoff Analog Protection: No Microcontroller required

Order TI Battery Monitoring IC found in Libre Solar BMS

Find evaluation boards to connect our ICs for testing

Update L1 Block Diagram

Leave data processing for VCU

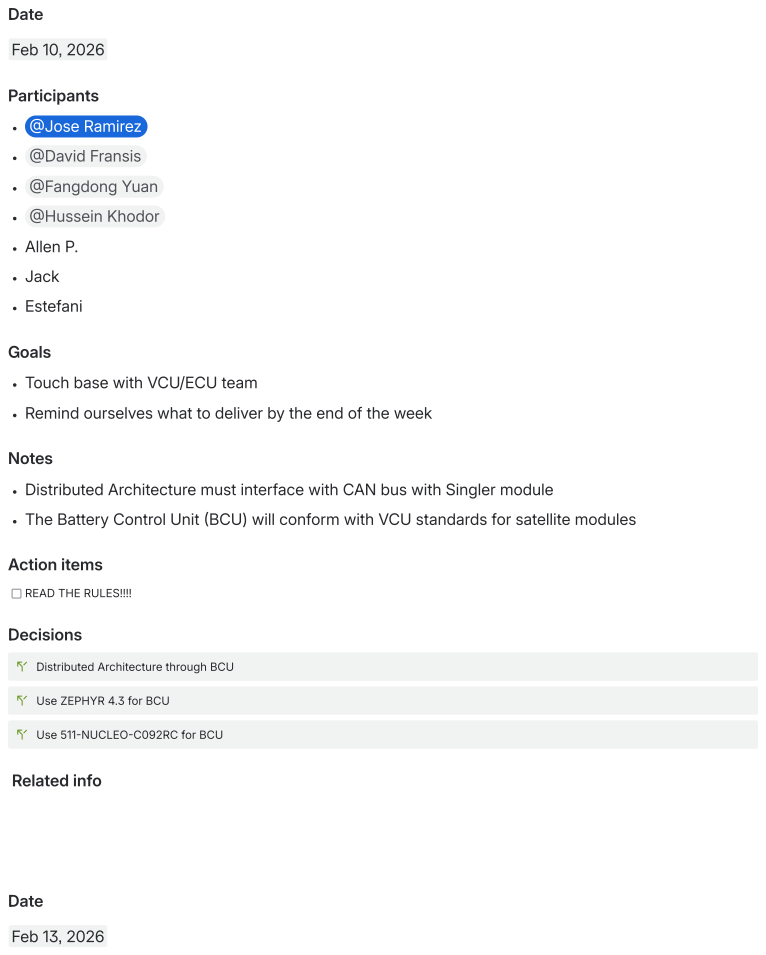
[picture p25: page 5]
Date; Feb 10, 2026; Participants; @Jose Ramirez; @David Fransis; @Fangdong Yuan; @Hussein Khodor; Allen P.; Jack; Estefani; Goals; Notes; Action items; Decisions; Related info; Feb 13, 2026

Touch base with VCU/ECU team

Remind ourselves what to deliver by the end of the week

Distributed Architecture must interface with CAN bus with Singler module

The Battery Control Unit (BCU) will conform with VCU standards for satellite modules

READ THE RULES!!!!

Distributed Architecture through BCU

Use ZEPHYR 4.3 for BCU

Use 511-NUCLEO-C092RC for BCU

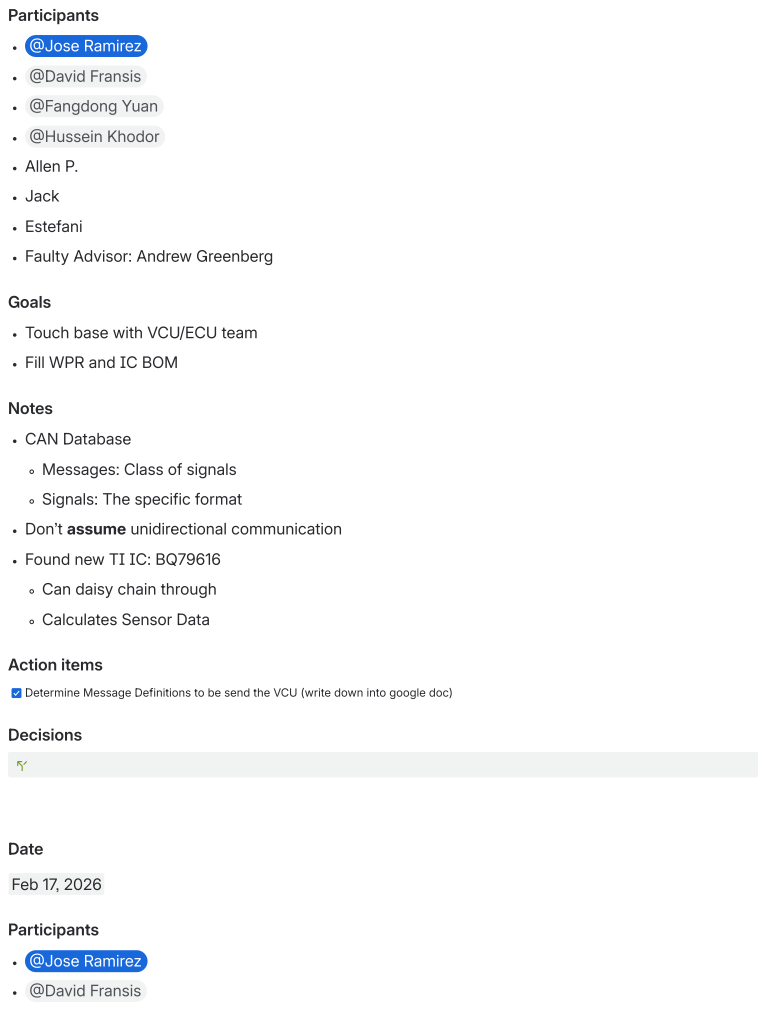
[picture p26: page 6]
Participants; @Jose Ramirez; @David Fransis; @Fangdong Yuan; @Hussein Khodor; Allen P.; Jack; Estefani; Goals; Notes; CAN Database; Action items; Decisions; Date; Feb 17, 2026

Faulty Advisor: Andrew Greenberg

Touch base with VCU/ECU team

Fill WPR and IC BOM

Messages: Class of signals

Signals: The specific format

Don’t assume unidirectional communication

Found new TI IC: BQ79616

Can daisy chain through

Calculates Sensor Data

Determine Message Definitions to be send the VCU (write down into google doc)

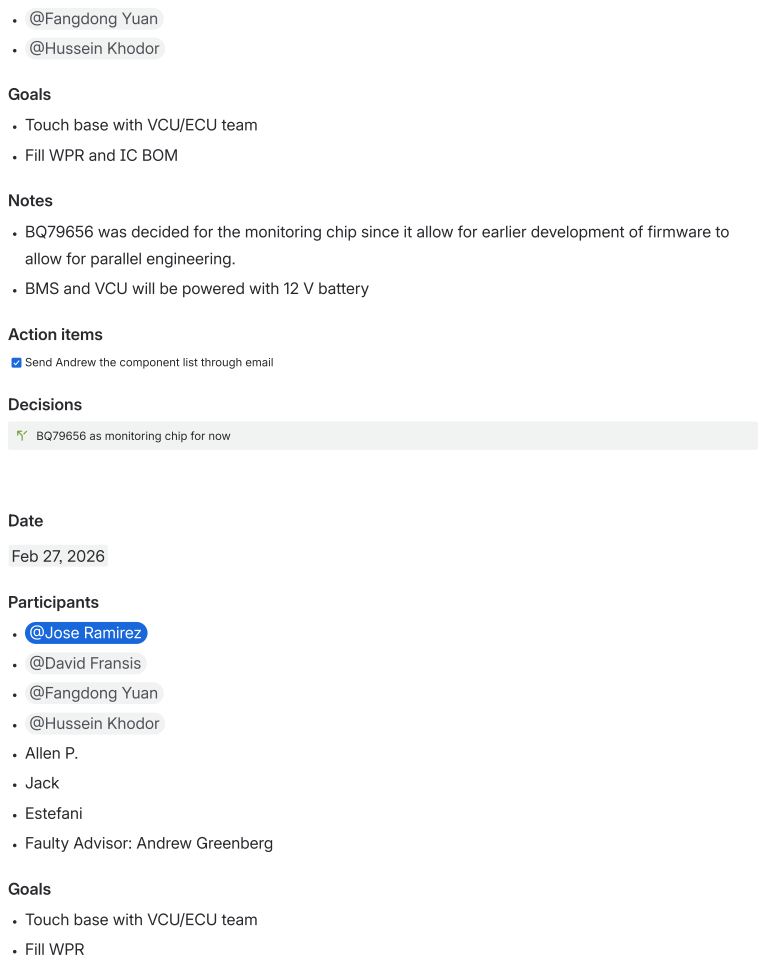
[picture p27: page 7]
@Fangdong Yuan; @Hussein Khodor; Goals; Notes; Action items; Decisions; Date; Feb 27, 2026; Participants; @Jose Ramirez; @David Fransis; Allen P.; Jack; Estefani; Fill WPR

Touch base with VCU/ECU team

Fill WPR and IC BOM

BQ79656 was decided for the monitoring chip since it allow for earlier development of firmware to

allow for parallel engineering.

BMS and VCU will be powered with 12 V battery

Send Andrew the component list through email

BQ79656 as monitoring chip for now

Faulty Advisor: Andrew Greenberg

Notes

Action items

Decisions

Date

Mar 4, 2026

Participants

@Jose Ramirez

@David Fransis

@Fangdong Yuan

@Hussein Khodor

Goals

Plan TED Talk for Friday

Documentation for System Hardware

Notes

We’ll present with google slides

Each bullet point on assignment description will be a slide or half a slide

@Hussein Khodor will start off, @David Fransis will cover what we have delivered, @Fangdong

Yuan will talk about System Architecture overview, @Jose Ramirez Will talk about what' good and

what’s not

Action items

Date

Mar 6, 2026

Determine Message Definitions to be send the VCU (write down into google doc)

Create google slide for the presentation

Use Hierarchical Sheets to KiCAD Schematic

Participants

@Jose Ramirez

@David Fransis

@Fangdong Yuan

@Hussein Khodor

Jack

Louis

Faulty Advisor: Andrew Greenberg

Goals

Touch base with VCU/ECU team

Talk about how the BMS should connect to daisy chain CAN-FD Bus

CAN Protocol

Talk about Component order with Andrew

Ask Andrew about the design

Fill WPR

Notes

When Battery is unstable, BMS sends Fault Message to VCU and activates Shutdown circuit

VCU will provide:

Arbitration Identifier

Transmission specification with App file: contains constants Frequency of CAN Messaging

CAN Development Document

Daisy Chain Harness CAN Bus (CANH, CANL, GND)

Use email to contact Andrew with Important messages

Parts ordered during meeting

Include Isolation Module into prototype by end of term

Action items

Read more of the Zephyr Manuals

@Fangdong Yuan Label all the lines in the block diagram

Date

Mar 10, 2026

Participants

@Jose Ramirez

@David Fransis

@Fangdong Yuan

@Hussein Khodor

Industry Sponsor: VMS - Jake

Faulty Advisor: Andrew Greenberg

Goals

Inform Industry sponsor about components

Ask how exactly we would send them order forms

Add small tweaks to the Block Diagram

Update on the KiCAD Schematic

Notes

Communication isolation module already on Monitoring chip so communication can bypass the Digital

Isolation Unit

David has looking into ISO and AIR ICs

Firmware development can be done through either VS IDE or text & terminal

Faculty Advisor and Industry Sponsor representative didn’t show up

Monitoring IC will have a separate PCB that will connect to the main BMS

Allows for easier scalability

We’re designing system architecture, not the evaluation boards or the ICs

UART Communication can through DMA in Zephyr

Action items

Decisions

@David Fransis List ISO and AIR Components

Below all the listings include lists of criteria for each component type

Date

Mar 20, 2026

Participants

@Jose Ramirez

@David Fransis

@Fangdong Yuan

@Hussein Khodor

Faulty Advisor: Andrew Greenberg

Goals

Format plan for firmware development with VCU team

Check up on System Architecture Development

Inquire about IC components

Notes

Satellite development, not much firmware

Firmware goal: Deliver a CAN message of a voltage reading

Order of ICs confused grant and was lost; Must reorder

Deciding having Current Sensor integrated to chip or as separate board for more modular battery

pack

Kevin Connections - op-amp across high voltage resistor

Action items

Decisions

@Fangdong Yuan Begin Development on Cell Monitoring and Current Sensor Designs

Write up of a current Shunt

What it is

Tradeoffs

Final decision for current sender

Current Sensor Separated from monitoring IC

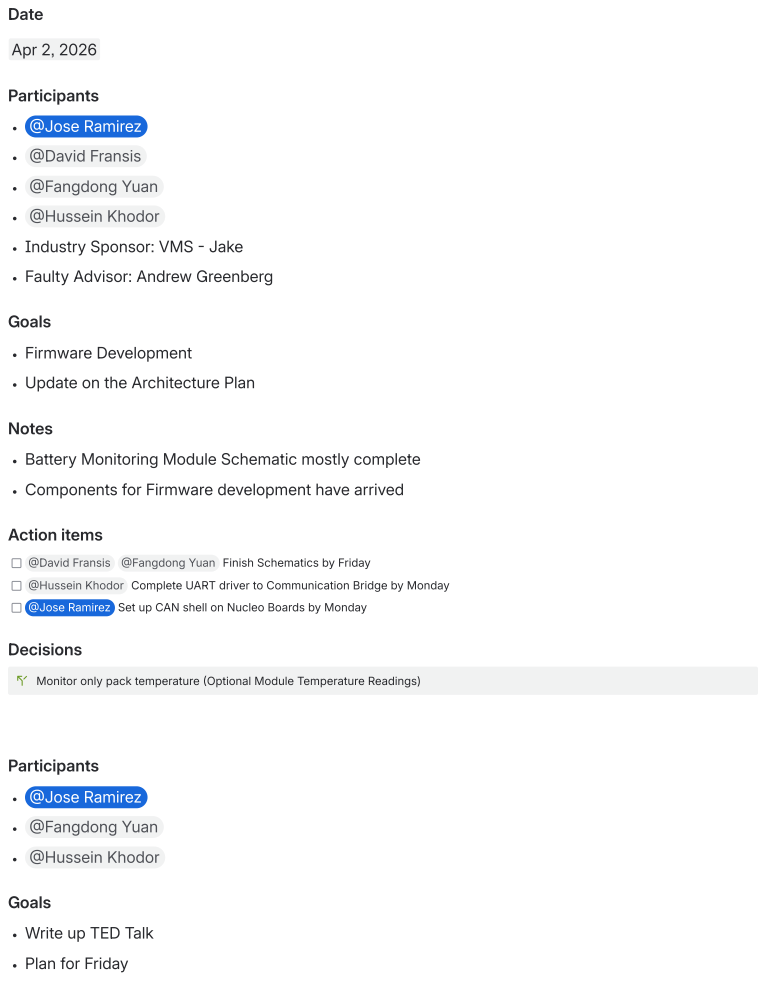
[picture p28: page 12]
Date; Apr 2, 2026; Participants; @Jose Ramirez; @David Fransis; @Fangdong Yuan; @Hussein Khodor; Goals; Firmware Development; Notes; Action items; Decisions

Industry Sponsor: VMS - Jake

Faulty Advisor: Andrew Greenberg

Update on the Architecture Plan

Battery Monitoring Module Schematic mostly complete

Components for Firmware development have arrived

@David Fransis @Fangdong Yuan Finish Schematics by Friday

@Hussein Khodor Complete UART driver to Communication Bridge by Monday

@Jose Ramirez Set up CAN shell on Nucleo Boards by Monday

Monitor only pack temperature (Optional Module Temperature Readings)

Write up TED Talk

Plan for Friday

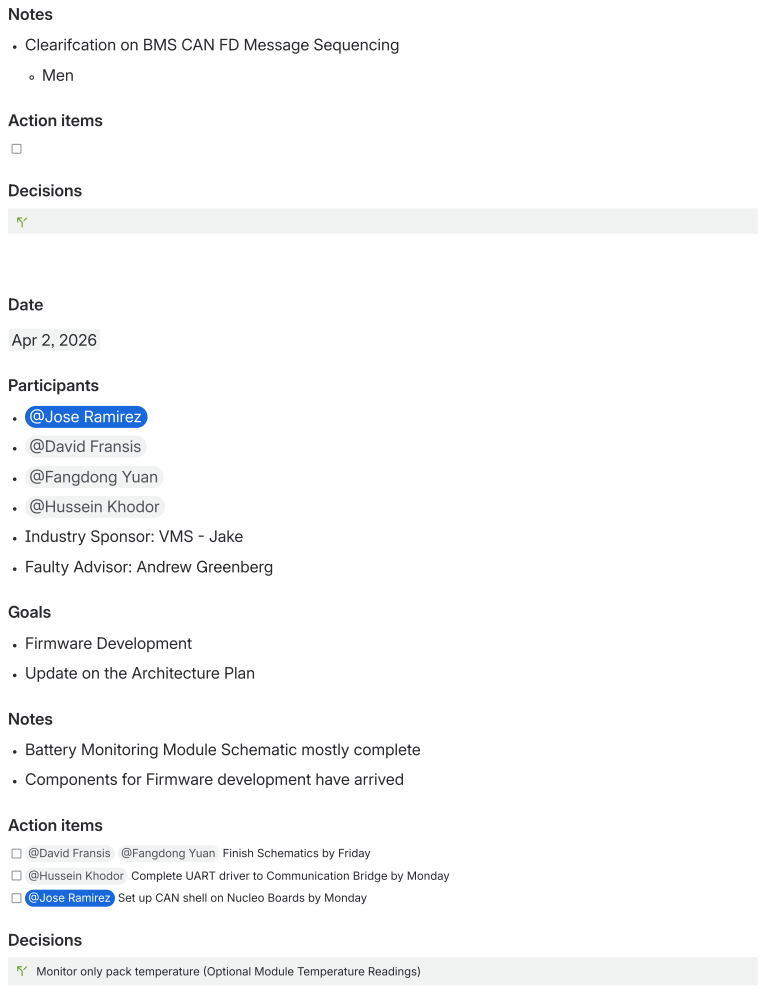
[picture p29: page 13]
Notes; Men; Action items; Decisions; Date; Apr 2, 2026; Participants; @Jose Ramirez; @David Fransis; @Fangdong Yuan; @Hussein Khodor; Goals; Firmware Development

Clearifcation on BMS CAN FD Message Sequencing

Industry Sponsor: VMS - Jake

Faulty Advisor: Andrew Greenberg

Update on the Architecture Plan

Battery Monitoring Module Schematic mostly complete

Components for Firmware development have arrived

@David Fransis @Fangdong Yuan Finish Schematics by Friday

@Hussein Khodor Complete UART driver to Communication Bridge by Monday

@Jose Ramirez Set up CAN shell on Nucleo Boards by Monday

Monitor only pack temperature (Optional Module Temperature Readings)

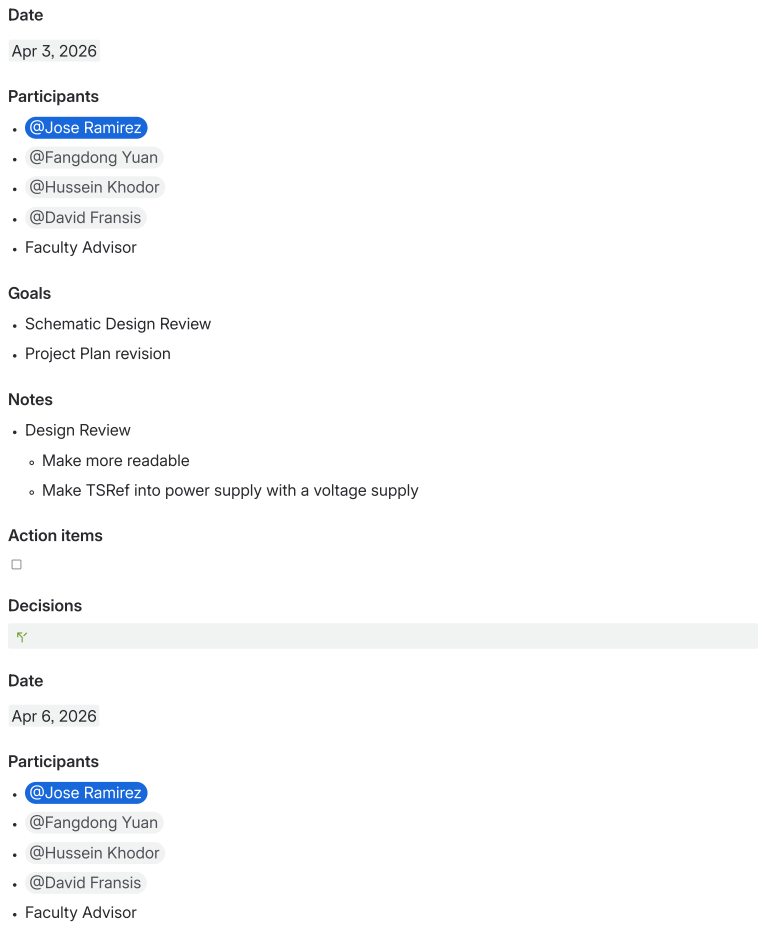
[picture p30: page 14]
Date; Apr 3, 2026; Participants; @Jose Ramirez; @Fangdong Yuan; @Hussein Khodor; @David Fransis; Faculty Advisor; Goals; Notes; Design Review; Action items; Decisions; Apr 6, 2026

Schematic Design Review

Project Plan revision

Make more readable

Make TSRef into power supply with a voltage supply

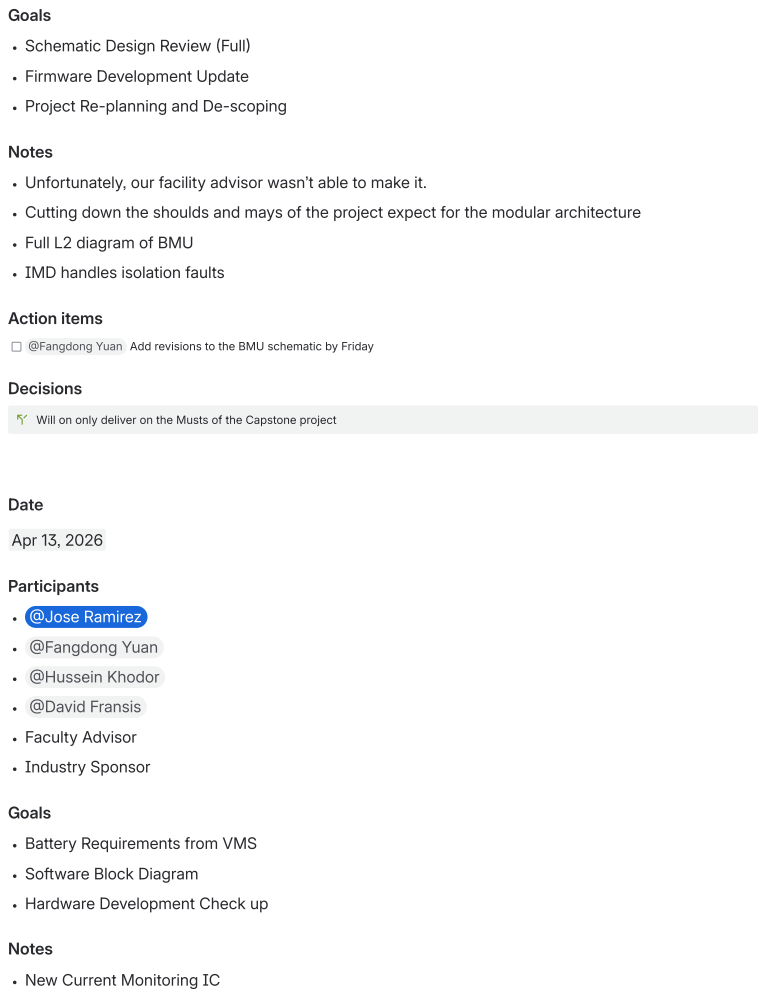
[picture p31: page 15]
Goals; Notes; Action items; Decisions; Date; Apr 13, 2026; Participants; @Jose Ramirez; @Fangdong Yuan; @Hussein Khodor; @David Fransis; Faculty Advisor; Industry Sponsor

Schematic Design Review (Full)

Firmware Development Update

Project Re-planning and De-scoping

Unfortunately, our facility advisor wasn’t able to make it.

Cutting down the shoulds and mays of the project expect for the modular architecture

Full L2 diagram of BMU

IMD handles isolation faults

@Fangdong Yuan Add revisions to the BMU schematic by Friday

Will on only deliver on the Musts of the Capstone project

Battery Requirements from VMS

Software Block Diagram

Hardware Development Check up

New Current Monitoring IC

Can create simple over-current protection

Uses TI I2C FAST_MODE

Battery Requirements

Motor Specs

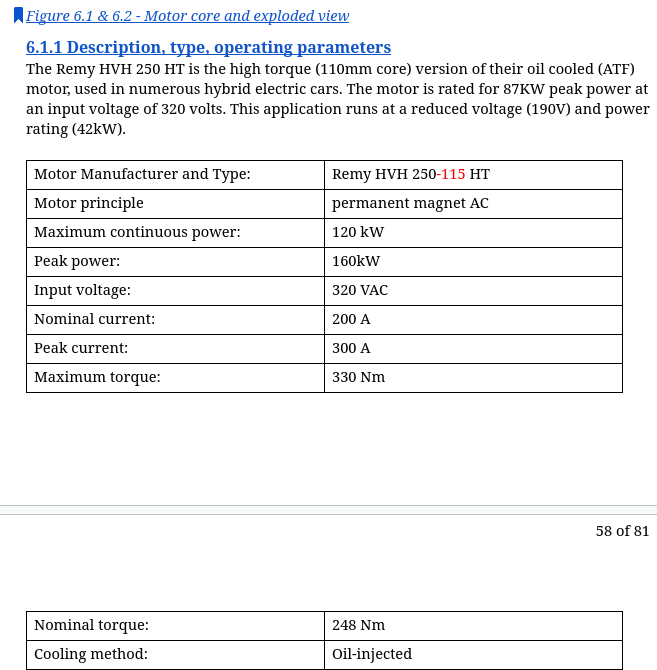
[picture p32: figure]

Old pack: ~300V NMC Li Ion

Motor Controller Specs

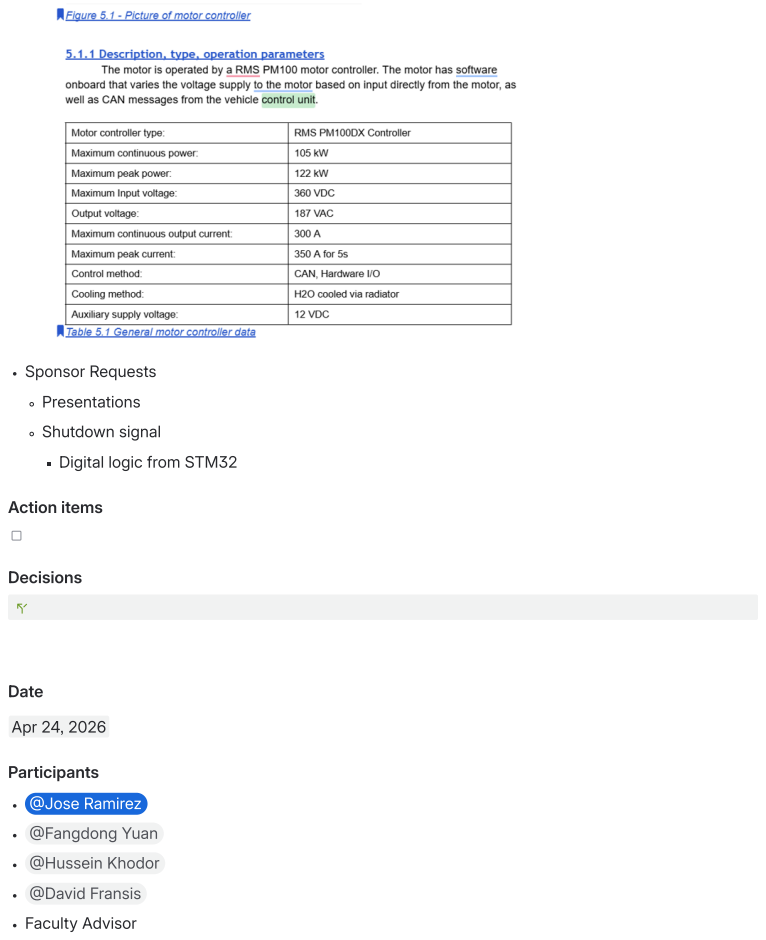
[picture p33: page 17]
Sponsor Requests; Presentations; Shutdown signal; Action items; Decisions; Date; Apr 24, 2026; Participants; @Jose Ramirez; @Fangdong Yuan; @Hussein Khodor; @David Fransis; Faculty Advisor

Digital logic from STM32

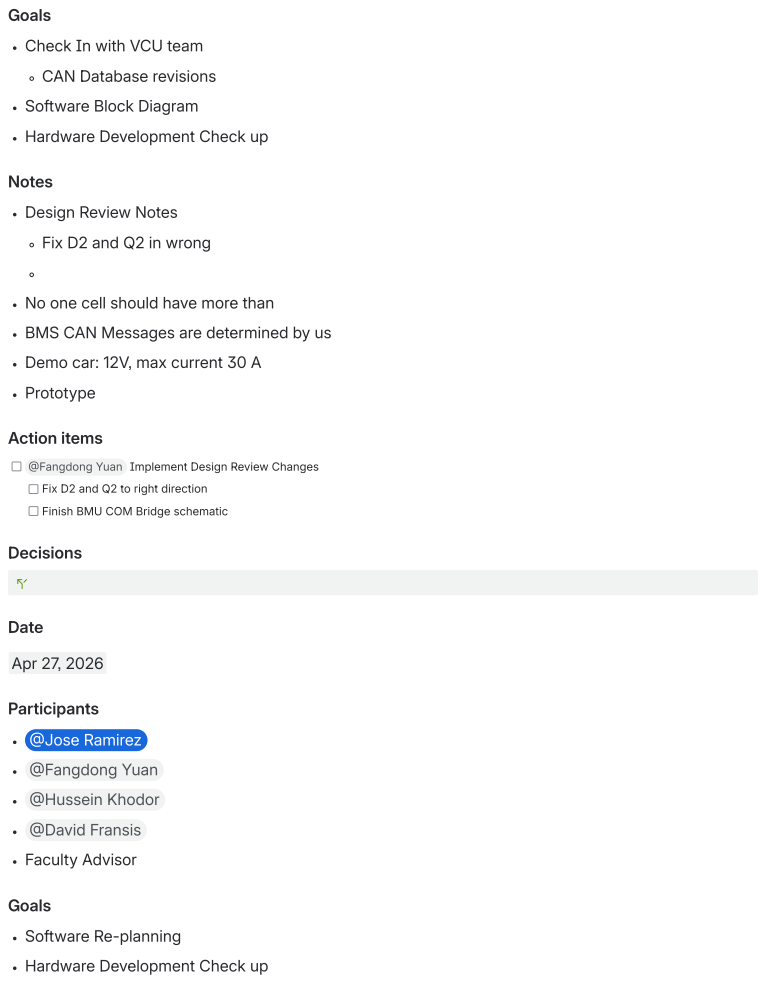
[picture p34: page 18]
Goals; Notes; Prototype; Action items; Decisions; Date; Apr 27, 2026; Participants; @Jose Ramirez; @Fangdong Yuan; @Hussein Khodor; @David Fransis; Faculty Advisor

Check In with VCU team

CAN Database revisions

Software Block Diagram

Hardware Development Check up

Design Review Notes

Fix D2 and Q2 in wrong

No one cell should have more than

BMS CAN Messages are determined by us

Demo car: 12V, max current 30 A

@Fangdong Yuan Implement Design Review Changes

Fix D2 and Q2 to right direction

Finish BMU COM Bridge schematic

Software Re-planning

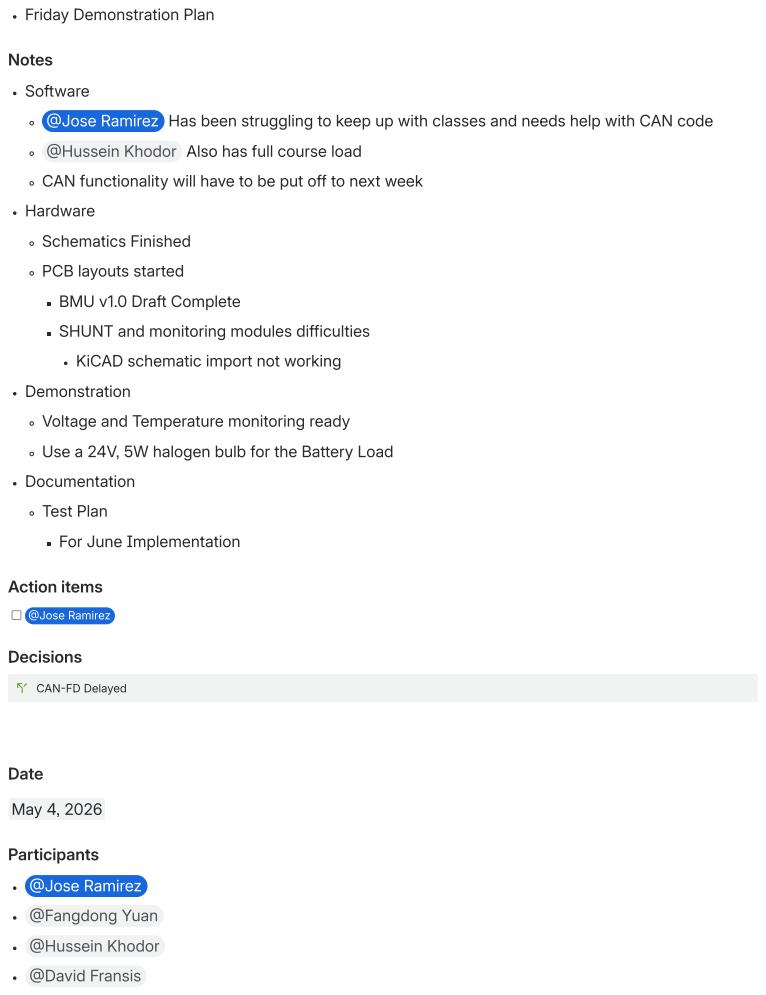
[picture p35: page 19]
Notes; Software; Hardware; Schematics Finished; Demonstration; Documentation; Test Plan; Action items; Decisions; Date; May 4, 2026; Participants; @Jose Ramirez; @Fangdong Yuan; @Hussein Khodor; @David Fransis

Friday Demonstration Plan

@Jose Ramirez Has been struggling to keep up with classes and needs help with CAN code

@Hussein Khodor Also has full course load

CAN functionality will have to be put off to next week

PCB layouts started

BMU v1.0 Draft Complete

SHUNT and monitoring modules difficulties

KiCAD schematic import not working

Voltage and Temperature monitoring ready

Use a 24V, 5W halogen bulb for the Battery Load

For June Implementation

CAN-FD Delayed

Faculty Advisor

Goals

Software Re-planning

Hardware Development Check up

Discuss what should be included in user’s and developer’s manuals

Notes

Software

Fault Configuration and Reading Complete

Cell Balancing and SHUNT module code

CAN test message will be done by Friday

CAN packaging and Transmitting for main project will be done

Hardware

“Voltage sense Overcurrent Protection device(s) blown or tripped” is below the threshold the HV

fuse is blown

Demonstration

Separate Batteries for different voltage system

Documentation

User’s Manual

How to reset the BMS after a fault was detected

Look for which fault

Developer’s Manual

Assembling and scaling the battery pack

Minor adjustments to software constants for pack scaling

Action items

Decisions
