VikingMotorsports/Battery-Management-System-Capstone-2026/Hardware/Battery Management Unit (BMU)/Battery Management Unit (BMU).kicad_pcb

## KiCad design Hardware/Battery Management Unit (BMU)/Battery Management Unit (BMU).kicad_pcb (2026-06-02)

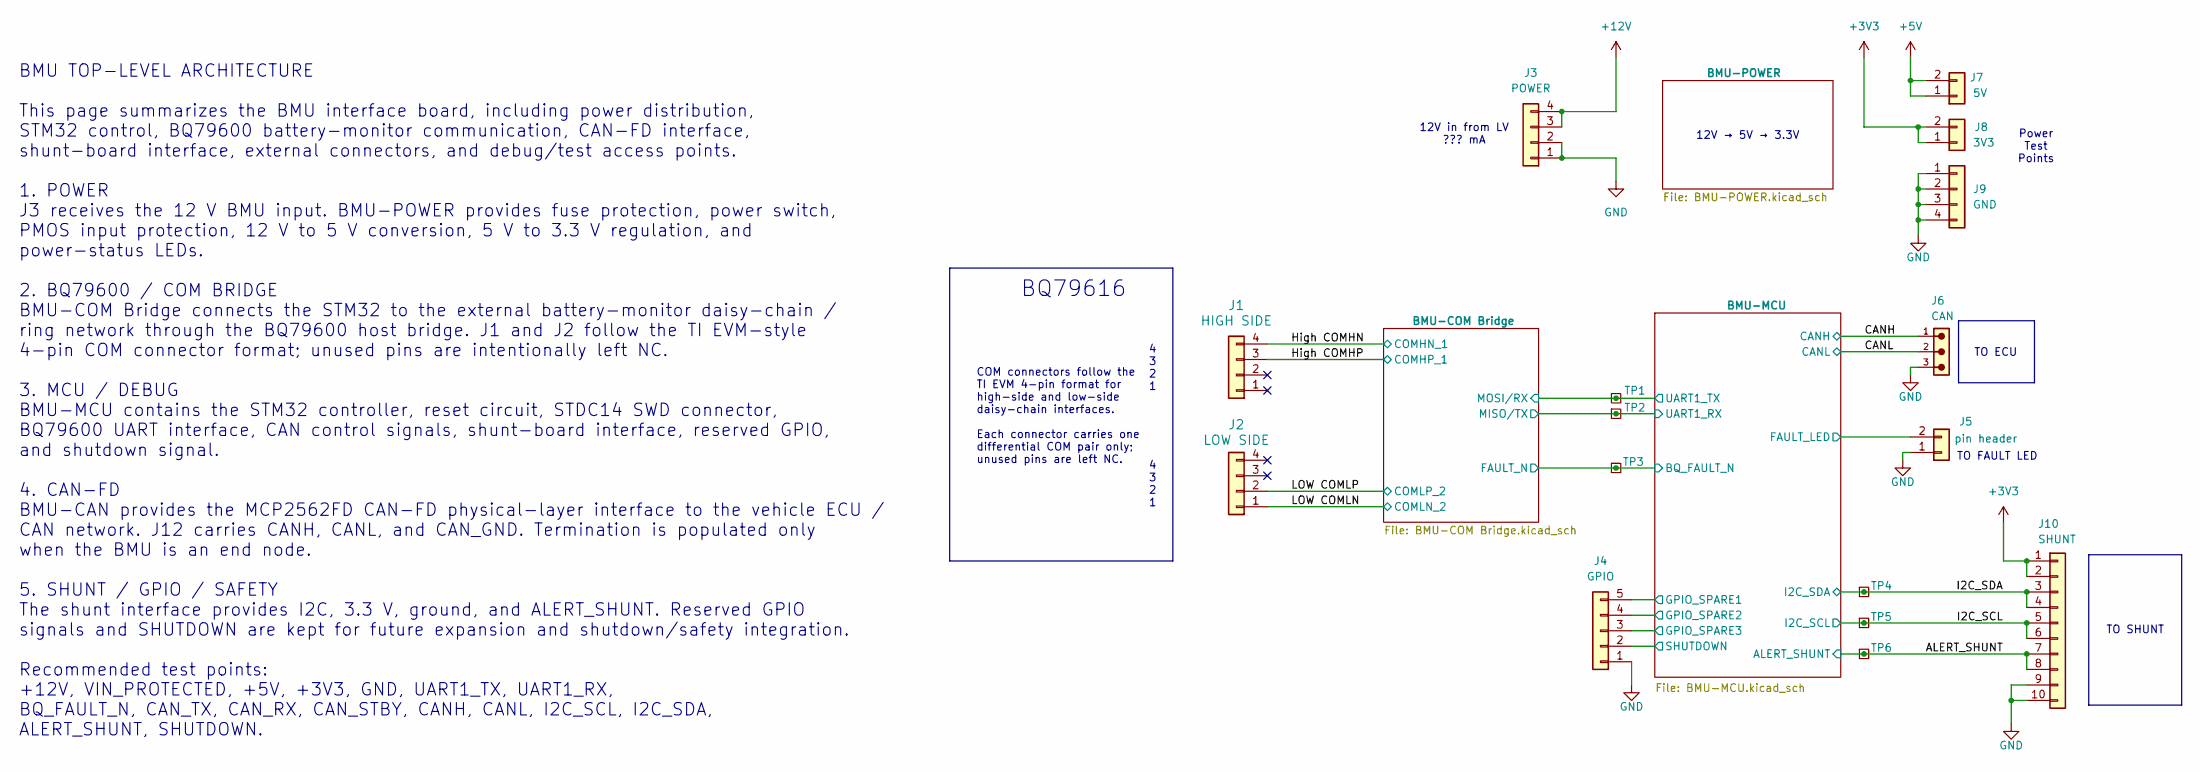
[picture p36: schematic Battery Management Unit (BMU).kicad_sch]

Parts:
J1: HIGH SIDE; 705510038; MPN 705510038
J2: LOW SIDE; 705510038; MPN 705510038
J3: POWER; PinHeader_1x04_P2.54mm_Vertical; MPN PRPC004SAAN-RC
J4: GPIO; PinHeader_1x05_P2.54mm_Vertical; MPN PRPC005SAAN-RC
J5: pin header; PinHeader_1x02_P2.54mm_Vertical; MPN PRPC002SAAN-RC
J6: CAN; 691382000003; MPN 691382000003
J7: 5V; PinHeader_1x02_P2.54mm_Vertical; MPN PRPC002SAAN-RC
J8: 3V3; PinHeader_1x02_P2.54mm_Vertical; MPN PRPC002SAAN-RC
J9: GND; PinHeader_1x04_P2.54mm_Vertical; MPN PRPC004SAAN-RC
J10: SHUNT; PinHeader_1x10_P2.54mm_Vertical; MPN PRPC010SAAN-RC
TP1, TP2, TP3, TP4, TP5, TP6: TestPoint_Small; TestPoint_THTPad_D1.5mm_Drill0.7mm

Connections:
+3V3: J8.1, J8.2, J10.1, J10.2; also elsewhere on the board
+5V: J7.1, J7.2; also elsewhere on the board
+12V: J3.3, J3.4; also elsewhere on the board
/ALERT_SHUNT: J10.7, J10.8, TP6.1 (1_1); also elsewhere on the board
/BMU-COM Bridge/FAULT_N: TP3.1 (1_1); also elsewhere on the board
/BMU-COM Bridge/MISO/TX: TP2.1 (1_1); also elsewhere on the board
/BMU-COM Bridge/MOSI/RX: TP1.1 (1_1); also elsewhere on the board
/BMU-MCU/FAULT_LED: J5.2; also elsewhere on the board
/BMU-MCU/GPIO_SPARE1: J4.5; also elsewhere on the board
/BMU-MCU/GPIO_SPARE2: J4.4; also elsewhere on the board
/BMU-MCU/GPIO_SPARE3: J4.3; also elsewhere on the board
/BMU-MCU/SHUTDOWN: J4.2; also elsewhere on the board
/CANH: J6.1; also elsewhere on the board
/CANL: J6.2; also elsewhere on the board
/High COMHN: J1.4; also elsewhere on the board
/High COMHP: J1.3; also elsewhere on the board
/I2C_SCL: J10.5, J10.6, TP5.1 (1_1); also elsewhere on the board
/I2C_SDA: J10.3, J10.4, TP4.1 (1_1); also elsewhere on the board
/LOW COMLN: J2.1; also elsewhere on the board
/LOW COMLP: J2.2; also elsewhere on the board
GND: J3.1, J3.2, J4.1, J5.1, J6.3, J9.1, J9.2, J9.3, J9.4, J10.9, J10.10; also elsewhere on the board

Notes on the sheet:
4 3 2 1
12V in from LV ??? mA
TO FAULT LED
COM connectors follow the TI EVM 4-pin format for high-side and low-side daisy-chain interfaces. Each connector carries one differential COM pair only; unused pins are left NC.
Power Test Points
TO ECU
BMU TOP-LEVEL ARCHITECTURE This page summarizes the BMU interface board, including power distribution, STM32 control, BQ79600 battery-monitor communication, CAN-FD interface, shunt-board interface, external connectors, and debug/test access points. 1. POWER J3 receives the 12 V BMU input. BMU-POWER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
TO SHUNT
12V → 5V → 3.3V
BQ79616

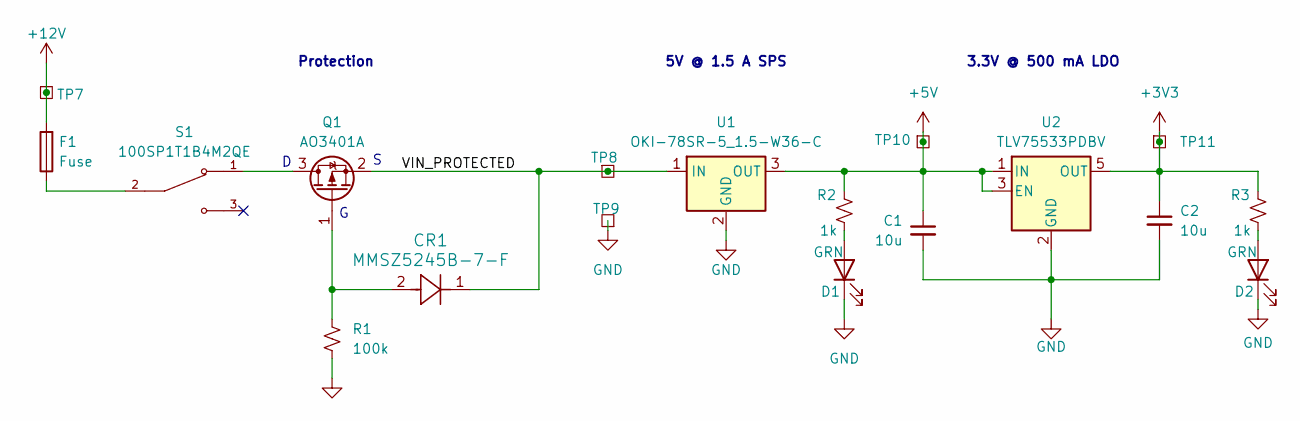
[picture p37: schematic BMU-POWER.kicad_sch, BATTERY MANAGEMENT UNIT (BMU)]

Parts:
C1, C2: 10u; C_0805_2012Metric; MPN CC0805KKX5R8BB106
CR1: MMSZ5245B-7-F; SOD123_DIO; MPN MMSZ5245B-7-F
D1, D2: GRN; LED_0805_2012Metric_Pad1.15x1.40mm_HandSolder; MPN LTST-C170GKT
F1: Fuse; Fuse_1206_3216Metric; MPN 0466001.NR
Q1: AO3401A; SOT-23; MPN AO3401A
R1: 100k; R_0805_2012Metric; MPN RC0805FR-07100KL
R2, R3: 1k; R_0805_2012Metric; MPN RC0805FR-071KL
S1: 100SP1T1B4M2QE; SW_100SP1T1B4M2QE; PARTREV E
TP7, TP8, TP9, TP10, TP11: TestPoint_Small; TestPoint_THTPad_D1.5mm_Drill0.7mm
U1: OKI-78SR-5_1.5-W36-C; Converter_DCDC_Murata_OKI-78SR_Vertical; MPN OKI-78SR-5/1.5-W36-C
U2: TLV75533PDBV; SOT-23-5; MPN TLV75533PDBVR

Connections:
+3V3: C2.1, R3.2, TP11.1 (1_1), U2.5 (OUT); also elsewhere on the board
+5V: C1.1, R2.2, TP10.1 (1_1), U1.3 (OUT), U2.1 (IN), U2.3 (EN); also elsewhere on the board
+12V: F1.2, TP7.1 (1_1); also elsewhere on the board
/BMU-POWER/VIN_PROTECTED: CR1.1, Q1.2 (S), TP8.1 (1_1), U1.1 (IN)
GND: C1.2, C2.2, D1.1 (K), D2.1 (K), R1.2, TP9.1 (1_1), U1.2 (GND), U2.2 (GND); also elsewhere on the board
unnamed: D1.2 (A), R2.1
unnamed: D2.2 (A), R3.1
unnamed: F1.1, S1.2
unnamed: Q1.3 (D), S1.1
unnamed: CR1.2, Q1.1 (G), R1.1

Notes on the sheet:
3.3V @ 500 mA LDO
5V @ 1.5 A SPS
Protection

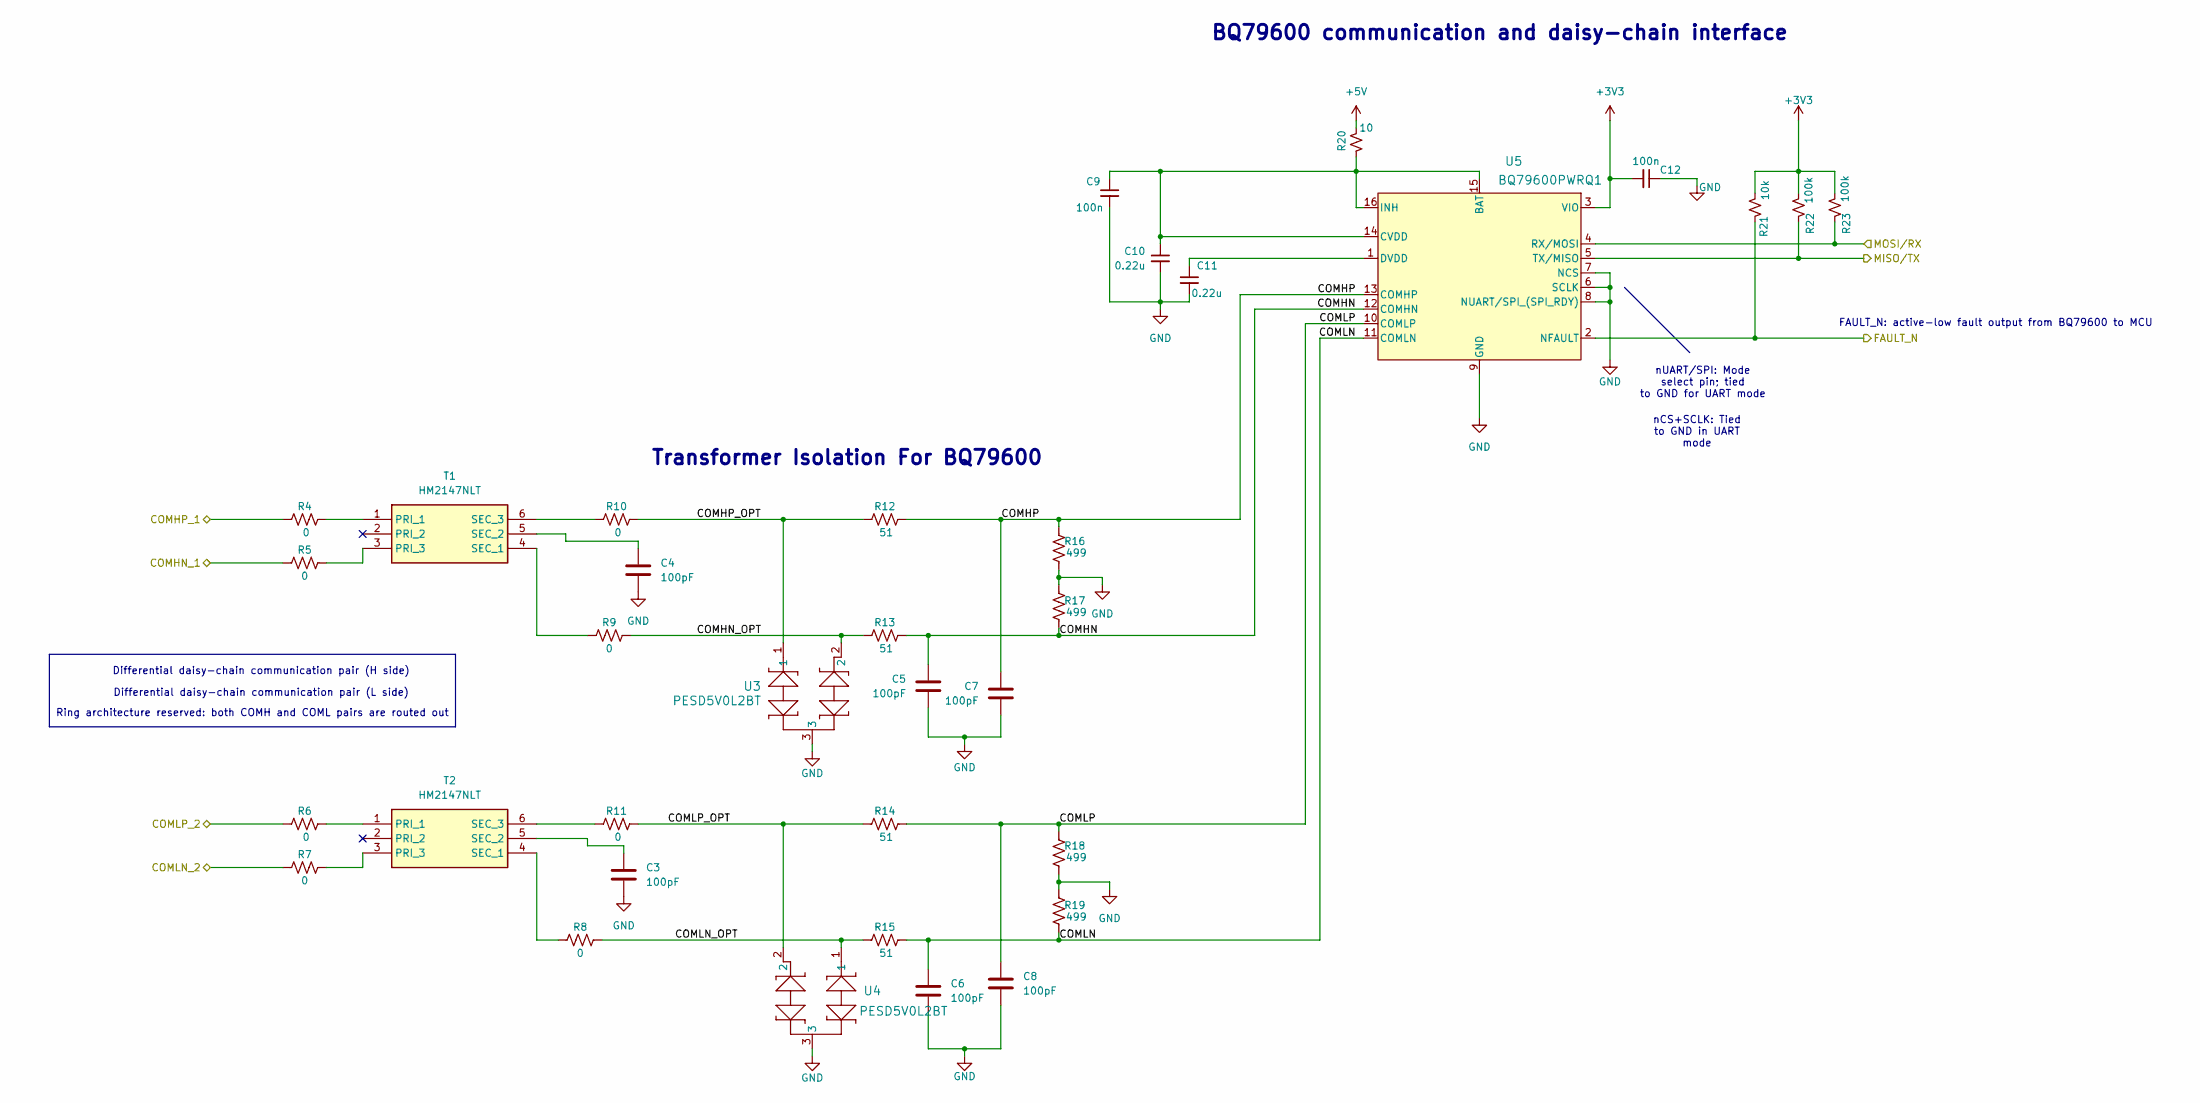
[picture p38: schematic BMU-COM Bridge.kicad_sch, BATTERY MANAGEMENT UNIT (BMU)]

Parts:
C3, C4, C5, C6, C7, C8: 100pF; C_0805_2012Metric; MPN CC0805KRNPO9BN101
C9, C12: 100n; C_0805_2012Metric; MPN CC0805KRX7R9BB104
C10, C11: 0.22u; C_0805_2012Metric; MPN CC0805KKX7R9BB224
R4, R5, R6, R7, R8, R9, R10, R11: 0; R_0805_2012Metric; MPN RC0805JR-070RL
R12, R13, R14, R15: 51; R_0805_2012Metric; MPN RC0805FR-0751RL
R16, R17, R18, R19: 499; R_0805_2012Metric; MPN RC0805FR-07499RL
R20: 10; R_0805_2012Metric; MPN RC0805FR-0710RL
R21: 10k; R_0805_2012Metric; MPN RC0805FR-0710KL
R22, R23: 100k; R_0805_2012Metric; MPN RC0805FR-07100KL
T1, T2: HM2147NLT; Manufacturer_Part_Number HM2147NLT; Mouser Part Number 673-HM2147NLT
U3, U4: PESD5V0L2BT; SOT23_NEX; MPN PESD5V0L2BT,215
U5: BQ79600PWRQ1; TSSOP16_PW_TEX; MPN BQ79600PWRQ1

Connections:
+3V3: C12.2, R21.1, R22.1, R23.1, U5.3 (VIO); also elsewhere on the board
+5V: R20.1; also elsewhere on the board
/BMU-COM Bridge/COMHN: C5.1, R13.2, R17.2, U5.12 (COMHN)
/BMU-COM Bridge/COMHN_OPT: R9.2, R13.1, U3.2
/BMU-COM Bridge/COMHP: C7.1, R12.2, R16.1, U5.13 (COMHP)
/BMU-COM Bridge/COMHP_OPT: R10.2, R12.1, U3.1
/BMU-COM Bridge/COMLN: C6.1, R15.2, R19.2, U5.11 (COMLN)
/BMU-COM Bridge/COMLN_OPT: R8.2, R15.1, U4.1
/BMU-COM Bridge/COMLP: C8.1, R14.2, R18.1, U5.10 (COMLP)
/BMU-COM Bridge/COMLP_OPT: R11.2, R14.1, U4.2
/BMU-COM Bridge/FAULT_N: R21.2, U5.2 (NFAULT); also elsewhere on the board
/BMU-COM Bridge/MISO/TX: R22.2, U5.5 (TX/MISO); also elsewhere on the board
/BMU-COM Bridge/MOSI/RX: R23.2, U5.4 (RX/MOSI); also elsewhere on the board
/High COMHN: R5.1; also elsewhere on the board
/High COMHP: R4.1; also elsewhere on the board
/LOW COMLN: R7.1; also elsewhere on the board
/LOW COMLP: R6.1; also elsewhere on the board
GND: C3.2, C4.2, C5.2, C6.2, C7.2, C8.2, C9.2, C10.2, C11.2, C12.1, R16.2, R17.1, R18.2, R19.1, U3.3, U4.3, U5.6 (SCLK), U5.7 (NCS), U5.8 (NUART/SPI_(SPI_RDY)), U5.9 (GND); also elsewhere on the board
unnamed: R4.2, T1.1 (PRI_1)
unnamed: R5.2, T1.3 (PRI_3)
unnamed: R9.1, T1.4 (SEC_1)
unnamed: C4.1, T1.5 (SEC_2)
unnamed: R10.1, T1.6 (SEC_3)
unnamed: R6.2, T2.1 (PRI_1)
unnamed: R7.2, T2.3 (PRI_3)
unnamed: R8.1, T2.4 (SEC_1)
unnamed: C3.1, T2.5 (SEC_2)
unnamed: R11.1, T2.6 (SEC_3)
unnamed: C9.1, C10.1, R20.2, U5.14 (CVDD), U5.15 (BAT), U5.16 (INH)
unnamed: C11.1, U5.1 (DVDD)

Notes on the sheet:
Differential daisy-chain communication pair (H side)
Transformer Isolation For BQ79600
Differential daisy-chain communication pair (L side)
BQ79600 communication and daisy-chain interface
Ring architecture reserved: both COMH and COML pairs are routed out
nUART/SPI: Mode select pin; tied to GND for UART mode
FAULT_N: active-low fault output from BQ79600 to MCU
nCS+SCLK: Tied to GND in UART mode

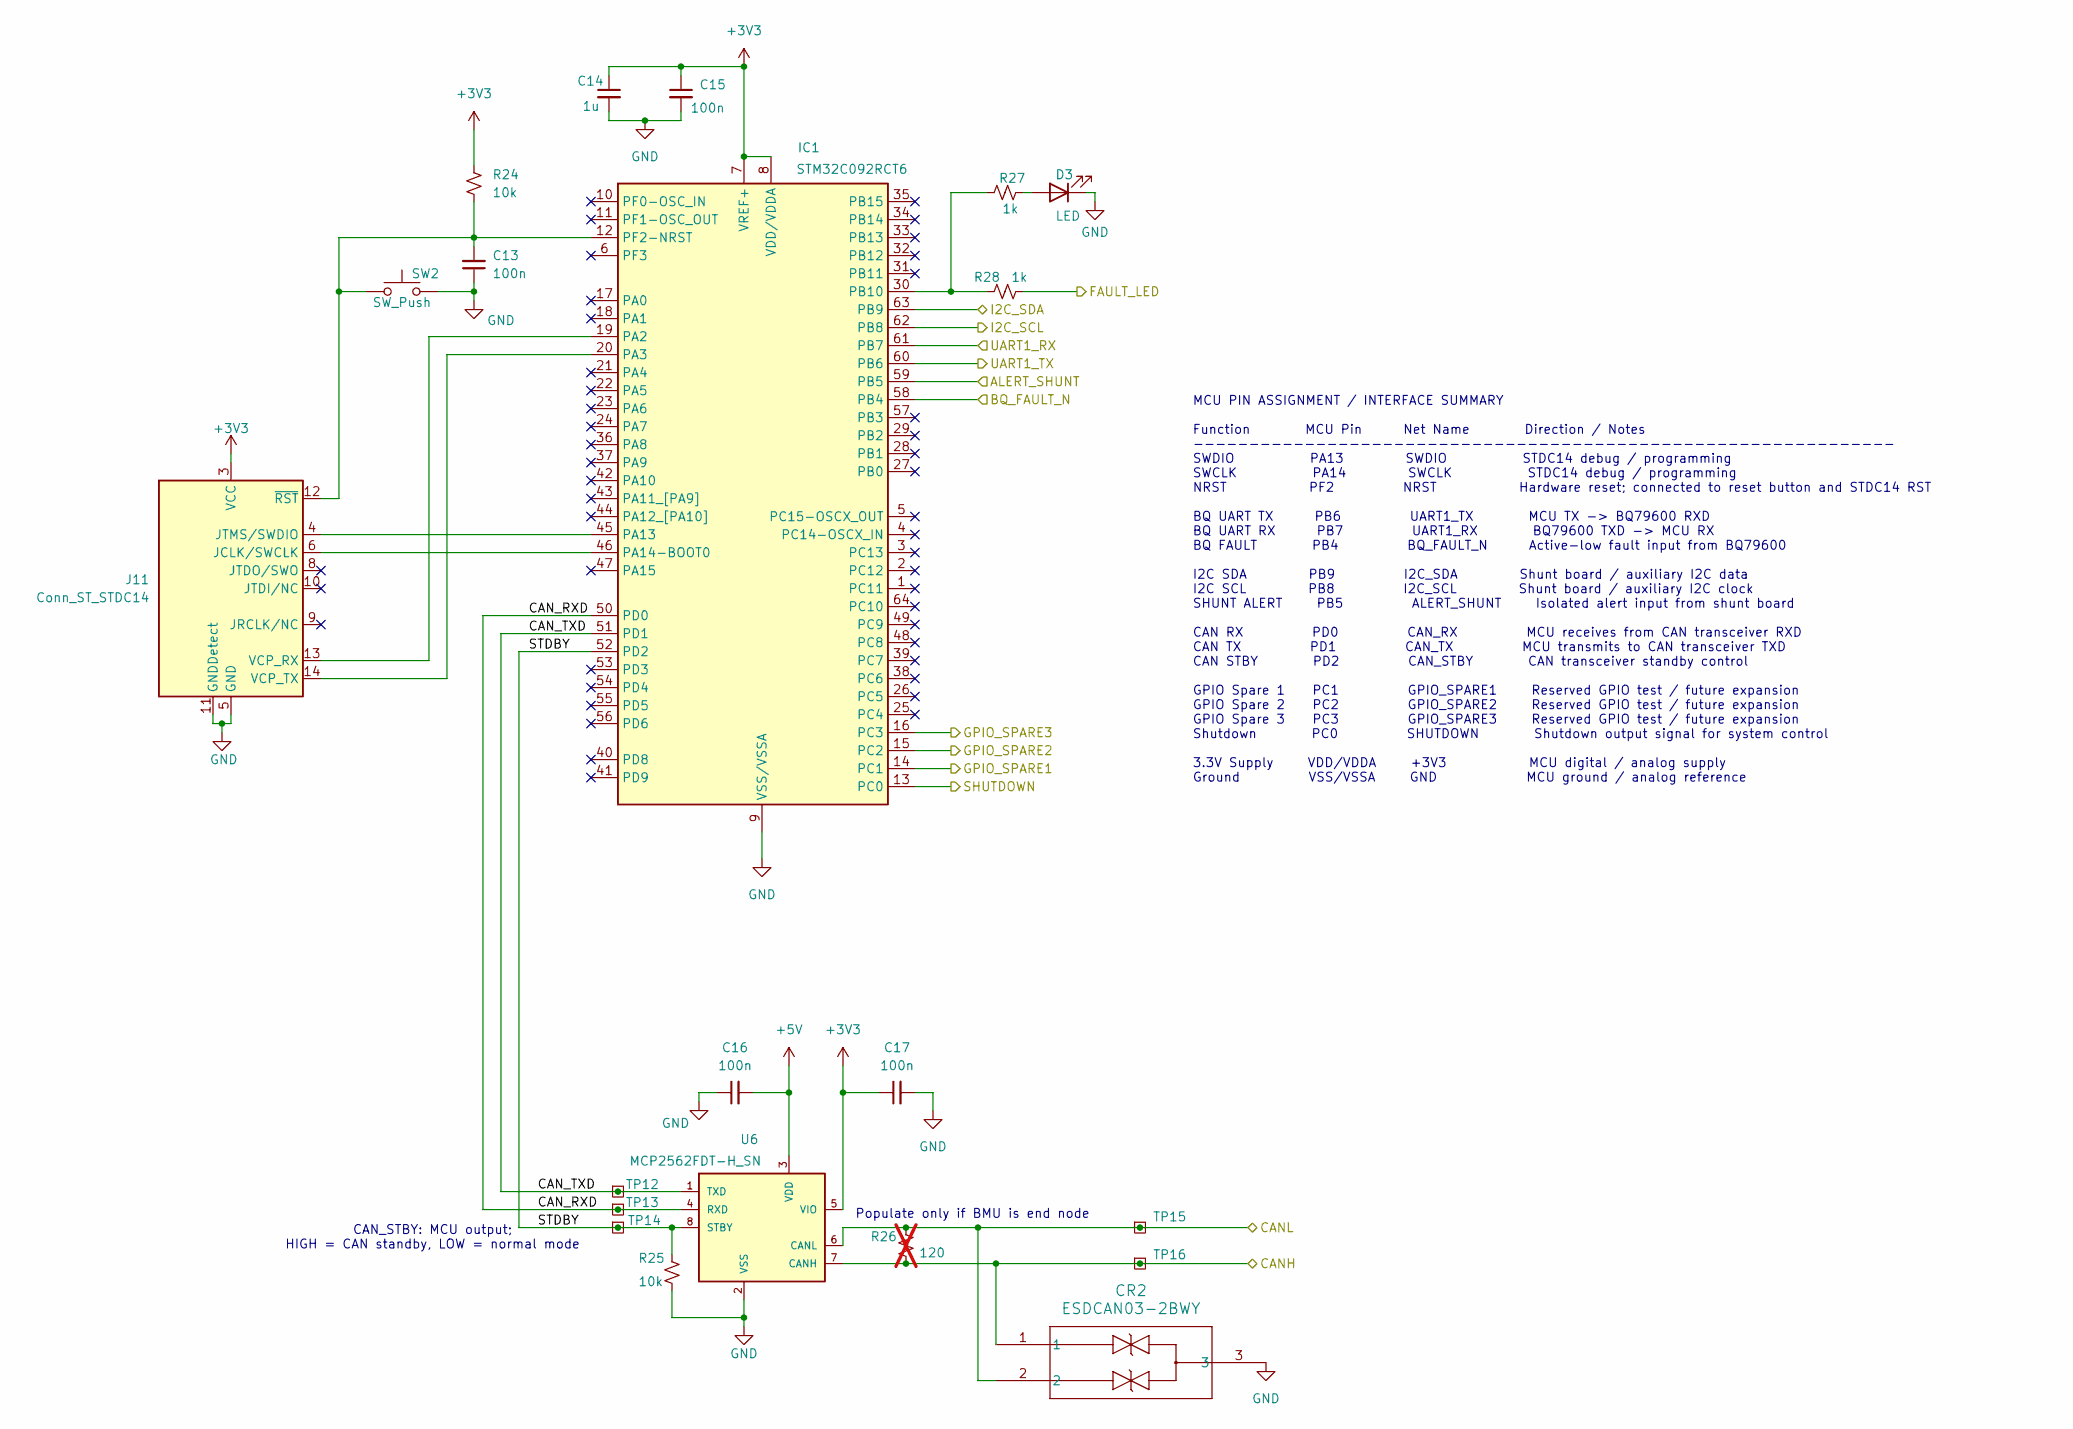
[picture p39: schematic BMU-MCU.kicad_sch, BATTERY MANAGEMENT UNIT (BMU)]

Parts:
C13, C15, C16, C17: 100n; C_0805_2012Metric; MPN CC0805KRX7R9BB104
C14: 1u; C_0805_2012Metric; MPN CC0805KKX7R7BB105
CR2: ESDCAN03-2BWY; SOT323-3L_STM; MPN ESDCAN03-2BWY
D3: LED; LED_0805_2012Metric_Pad1.15x1.40mm_HandSolder; MPN LTST-C170KRKT
IC1: STM32C092RCT6; QFP50P1200X1200X160-64N; Manufacturer_Part_Number STM32C092RCT6; Mouser Part Number 511-STM32C092RCT6
J11: Conn_ST_STDC14; PinHeader_2x07_P1.27mm_Vertical; MPN FTSH-107-01-F-DV-K
R24, R25: 10k; R_0805_2012Metric; MPN RC0805FR-0710KL
R26: 120; R_0805_2012Metric; MPN RC0805FR-07120RL; not fitted
R27, R28: 1k; R_0805_2012Metric; MPN RC0805FR-071KL
SW2: SW_Push; SW_PUSH_6mm_H4.3mm; MPN B3F-1000
TP12, TP13, TP14, TP15, TP16: TestPoint_Small; TestPoint_THTPad_D1.5mm_Drill0.7mm
U6: MCP2562FDT-H_SN; SOIC127P600X175-8N; MPN MCP2562FDT-H/SN

Connections:
+3V3: C14.1, C15.1, C17.1, IC1.7 (VREF+), IC1.8 (VDD/VDDA), J11.3 (VCC), R24.1, U6.5 (VIO); also elsewhere on the board
+5V: C16.2, U6.3 (VDD); also elsewhere on the board
/ALERT_SHUNT: IC1.59 (PB5); also elsewhere on the board
/BMU-COM Bridge/FAULT_N: IC1.58 (PB4); also elsewhere on the board
/BMU-COM Bridge/MISO/TX: IC1.61 (PB7); also elsewhere on the board
/BMU-COM Bridge/MOSI/RX: IC1.60 (PB6); also elsewhere on the board
/BMU-MCU/CAN_RXD: IC1.50 (PD0), TP13.1 (1_1), U6.4 (RXD)
/BMU-MCU/CAN_TXD: IC1.51 (PD1), TP12.1 (1_1), U6.1 (TXD)
/BMU-MCU/FAULT_LED: R28.2; also elsewhere on the board
/BMU-MCU/GPIO_SPARE1: IC1.14 (PC1); also elsewhere on the board
/BMU-MCU/GPIO_SPARE2: IC1.15 (PC2); also elsewhere on the board
/BMU-MCU/GPIO_SPARE3: IC1.16 (PC3); also elsewhere on the board
/BMU-MCU/SHUTDOWN: IC1.13 (PC0); also elsewhere on the board
/BMU-MCU/STDBY: IC1.52 (PD2), R25.1, TP14.1 (1_1), U6.8 (STBY)
/CANH: CR2.1, R26.2, TP16.1 (1_1), U6.7 (CANH); also elsewhere on the board
/CANL: CR2.2, R26.1, TP15.1 (1_1), U6.6 (CANL); also elsewhere on the board
/I2C_SCL: IC1.62 (PB8); also elsewhere on the board
/I2C_SDA: IC1.63 (PB9); also elsewhere on the board
GND: C13.1, C14.2, C15.2, C16.1, C17.2, CR2.3, D3.1 (K), IC1.9 (VSS/VSSA), J11.5 (GND), J11.7 (GND), J11.11 (GNDDetect), R25.2, SW2.2, U6.2 (VSS); also elsewhere on the board
unnamed: D3.2 (A), R27.2
unnamed: IC1.19 (PA2), J11.13 (VCP_RX)
unnamed: IC1.20 (PA3), J11.14 (VCP_TX)
unnamed: IC1.45 (PA13), J11.4 (JTMS/SWDIO)
unnamed: IC1.46 (PA14-BOOT0), J11.6 (JCLK/SWCLK)
unnamed: IC1.30 (PB10), R27.1, R28.1
unnamed: C13.2, IC1.12 (PF2-NRST), J11.12 (~RST), R24.2, SW2.1

Notes on the sheet:
MCU PIN ASSIGNMENT / INTERFACE SUMMARY Function MCU Pin Net Name Direction / Notes --------------------------------------------------------------- SWDIO PA13 SWDIO STDC14 debug / programming SWCLK PA14 SWCLK STDC14 debug / programming NRST PF2 NRST Hardware reset; connected to reset button and STDC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
CAN_STBY: MCU output; HIGH = CAN standby, LOW = normal mode
Populate only if BMU is end node

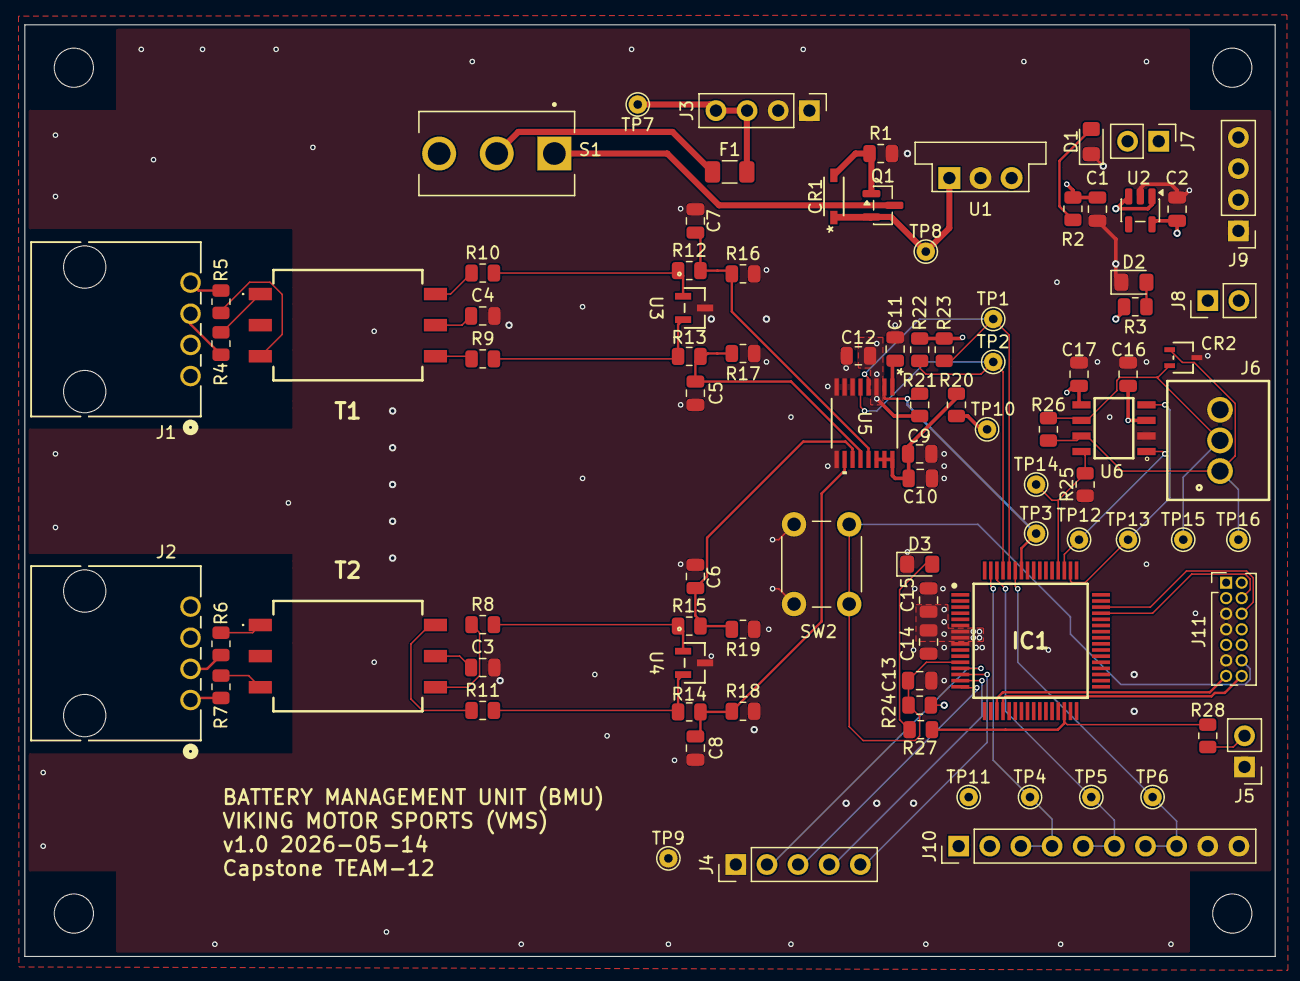
[picture p40: board Battery Management Unit (BMU).kicad_pcb from above]

Board: 4 copper layers, 102.0 x 76.0 mm, 90 parts (0 on the bottom side), 57 nets.
