VikingMotorsports/Battery-Management-System-Capstone-2026/Hardware/Cell Monitoring Unit (CMU)/Cell Monitoring Unit (CMU).kicad_pcb

## KiCad design Hardware/Cell Monitoring Unit (CMU)/Cell Monitoring Unit (CMU).kicad_pcb (2026-06-02)

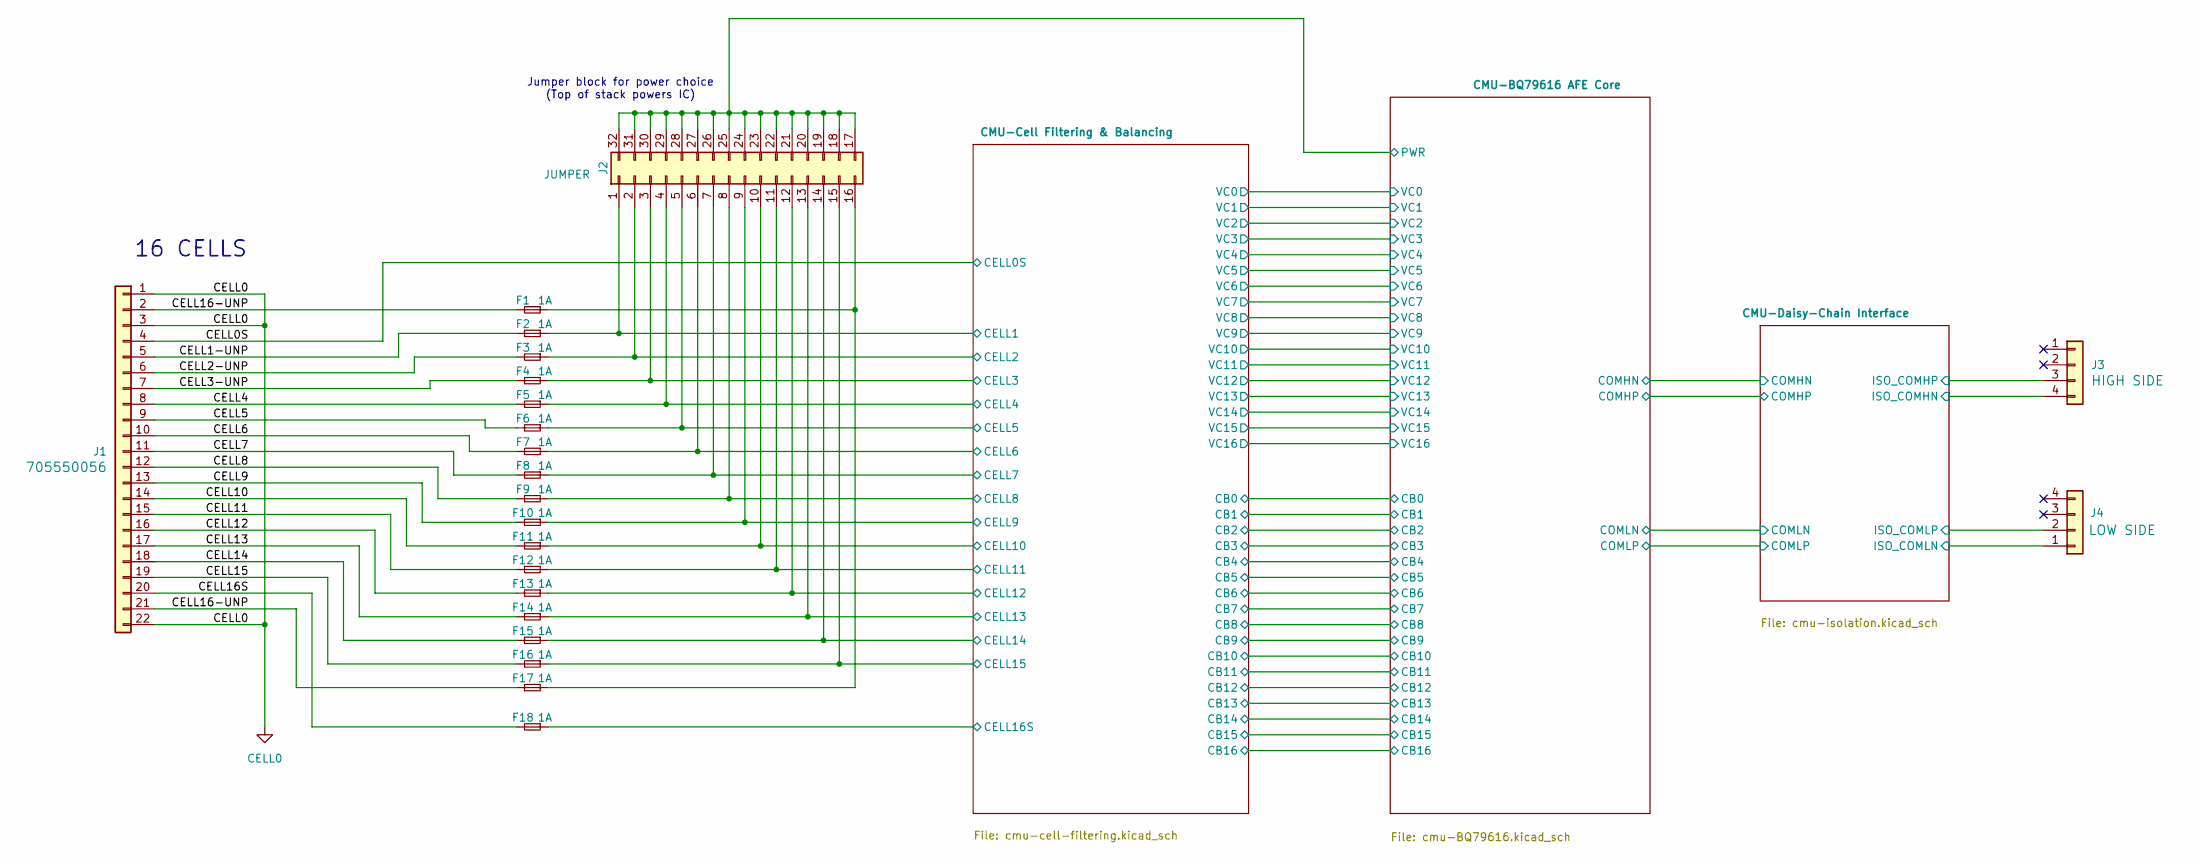
[picture p41: schematic Cell Monitoring Unit (CMU).kicad_sch, Cell Monitoring Unit（CMU）]

Parts:
F1, F2, F3, F4, F5, F6, F7, F8, F9, F10, F11, F12, F13, F14, F15, F16, F17, F18: 1A; Fuse_0805_2012Metric; MPN F0805B1R00FSTR
J1: 705550056; MPN 70555-0056
J2: JUMPER; PinHeader_2x16_P2.54mm_Vertical; MPN TSW-116-07-G-D
J3: HIGH SIDE; 705510038; MPN 705510038
J4: LOW SIDE; 705510038; MPN 705510038

Connections:
/CELL0S: J1.4; also elsewhere on the board
/CELL1-UNP: F2.2, J1.5
/CELL2-UNP: F3.2, J1.6
/CELL3-UNP: F4.2, J1.7
/CELL4: F5.2, J1.8
/CELL5: F6.2, J1.9
/CELL6: F7.2, J1.10
/CELL7: F8.2, J1.11
/CELL8: F9.2, J1.12
/CELL9: F10.2, J1.13
/CELL10: F11.2, J1.14
/CELL11: F12.2, J1.15
/CELL12: F13.2, J1.16
/CELL13: F14.2, J1.17
/CELL14: F15.2, J1.18
/CELL15: F16.2, J1.19
/CELL16-UNP: F1.2, F17.2, J1.2, J1.21
/CELL16S: F18.2, J1.20
/CMU-BQ79616 AFE Core/PWR: J2.17, J2.18, J2.19, J2.20, J2.21, J2.22, J2.23, J2.24, J2.25, J2.26, J2.27, J2.28, J2.29, J2.30, J2.31, J2.32; also elsewhere on the board
/CMU-Cell Filtering & Balancing/CELL1: F2.1, J2.1; also elsewhere on the board
/CMU-Cell Filtering & Balancing/CELL2: F3.1, J2.2; also elsewhere on the board
/CMU-Cell Filtering & Balancing/CELL3: F4.1, J2.3; also elsewhere on the board
/CMU-Cell Filtering & Balancing/CELL4: F5.1, J2.4; also elsewhere on the board
/CMU-Cell Filtering & Balancing/CELL5: F6.1, J2.5; also elsewhere on the board
/CMU-Cell Filtering & Balancing/CELL6: F7.1, J2.6; also elsewhere on the board
/CMU-Cell Filtering & Balancing/CELL7: F8.1, J2.7; also elsewhere on the board
/CMU-Cell Filtering & Balancing/CELL8: F9.1, J2.8; also elsewhere on the board
/CMU-Cell Filtering & Balancing/CELL9: F10.1, J2.9; also elsewhere on the board
/CMU-Cell Filtering & Balancing/CELL10: F11.1, J2.10; also elsewhere on the board
/CMU-Cell Filtering & Balancing/CELL11: F12.1, J2.11; also elsewhere on the board
/CMU-Cell Filtering & Balancing/CELL12: F13.1, J2.12; also elsewhere on the board
/CMU-Cell Filtering & Balancing/CELL13: F14.1, J2.13; also elsewhere on the board
/CMU-Cell Filtering & Balancing/CELL14: F15.1, J2.14; also elsewhere on the board
/CMU-Cell Filtering & Balancing/CELL15: F16.1, J2.15; also elsewhere on the board
/CMU-Cell Filtering & Balancing/CELL16S: F18.1; also elsewhere on the board
/CMU-Daisy-Chain Interface/ISO_COMHN: J3.4; also elsewhere on the board
/CMU-Daisy-Chain Interface/ISO_COMHP: J3.3; also elsewhere on the board
/CMU-Daisy-Chain Interface/ISO_COMLN: J4.1; also elsewhere on the board
/CMU-Daisy-Chain Interface/ISO_COMLP: J4.2; also elsewhere on the board
CELL0: J1.1, J1.3, J1.22; also elsewhere on the board
unnamed: F1.1, F17.1, J2.16

Notes on the sheet:
Jumper block for power choice (Top of stack powers IC)
16 CELLS
