VikingMotorsports/Battery-Management-System-Capstone-2026/Hardware/Cell Monitoring Unit (CMU)/Cell Monitoring Unit (CMU).kicad_pcb

## KiCad design Hardware/Cell Monitoring Unit (CMU)/Cell Monitoring Unit (CMU).kicad_pcb (continued)

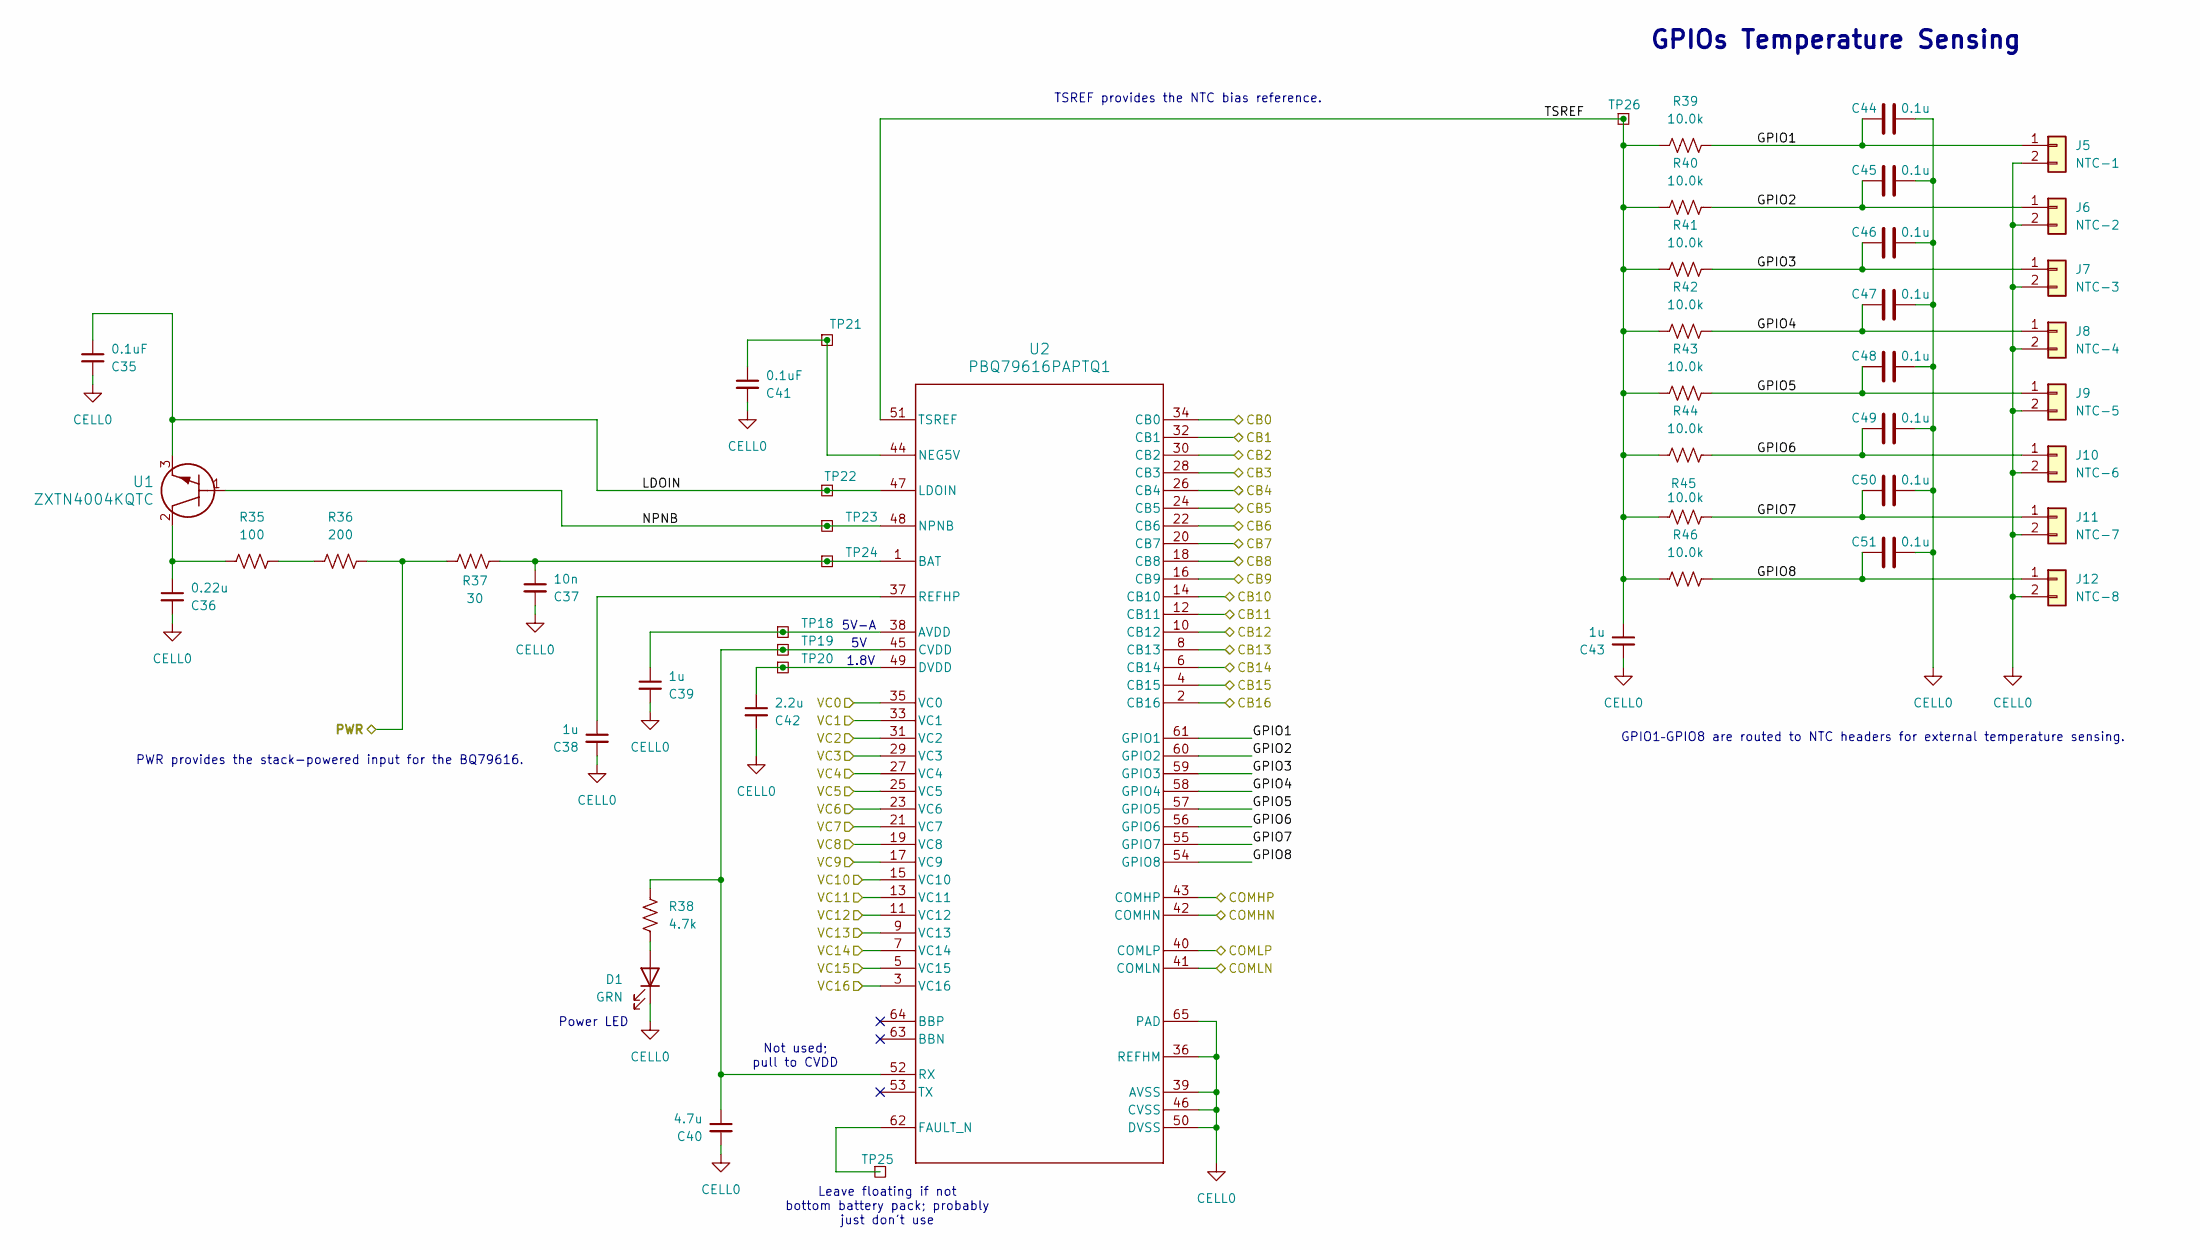
[picture p42: schematic cmu-BQ79616.kicad_sch, Cell Monitoring Unit（CMU）]

Parts:
C35, C41: 0.1uF; C_0805_2012Metric; MPN C0805X104K050T
C36: 0.22u; C_0805_2012Metric; MPN 885382207008
C37: 10n; C_0805_2012Metric; MPN C0805C103K5RECAUTO
C38, C39, C43: 1u; C_0805_2012Metric; MPN C0805C105K5RACTU
C40: 4.7u; C_0805_2012Metric; MPN C0805X475K025T
C42: 2.2u; C_0805_2012Metric; MPN 885012207079
C44, C45, C46, C47, C48, C49, C50, C51: 0.1u; C_0805_2012Metric; MPN C0805X104K050T
D1: GRN; LED_0805_2012Metric; MPN LTST-C170KGKT
J5: NTC-1; PinHeader_1x02_P2.54mm_Vertical; MPN 61300211121
J6: NTC-2; PinHeader_1x02_P2.54mm_Vertical; MPN 61300211121
J7: NTC-3; PinHeader_1x02_P2.54mm_Vertical; MPN 61300211121
J8: NTC-4; PinHeader_1x02_P2.54mm_Vertical; MPN 61300211121
J9: NTC-5; PinHeader_1x02_P2.54mm_Vertical; MPN 61300211121
J10: NTC-6; PinHeader_1x02_P2.54mm_Vertical; MPN 61300211121
J11: NTC-7; PinHeader_1x02_P2.54mm_Vertical; MPN 61300211121
J12: NTC-8; PinHeader_1x02_P2.54mm_Vertical; MPN 61300211121
R35: 100; R_2010_5025Metric; MPN RMCF2010FT100R
R36: 200; R_2010_5025Metric; MPN RMCF2010FT200R
R37: 30; R_2010_5025Metric; MPN RC2010FK-0730RL
R38: 4.7k; R_2010_5025Metric; MPN RC2010FK-074K7L
R39, R40, R41, R42, R43, R44, R45, R46: 10.0k; R_0805_2012Metric; MPN RC0805FR-0710KL
TP18, TP19, TP20, TP21, TP22, TP23, TP24, TP25, TP26: TestPoint_Square; TestPoint_THTPad_D1.5mm_Drill0.7mm
U1: ZXTN4004KQTC; DPAK_04KQTC_DIO; MPN ZXTN4004KQTC
U2: PBQ79616PAPTQ1; PAP0064F-IPC_A; MPN BQ79616PAPRQ1

Connections:
/CMU-BQ79616 AFE Core/CB0: U2.34 (CB0); also elsewhere on the board
/CMU-BQ79616 AFE Core/CB1: U2.32 (CB1); also elsewhere on the board
/CMU-BQ79616 AFE Core/CB2: U2.30 (CB2); also elsewhere on the board
/CMU-BQ79616 AFE Core/CB3: U2.28 (CB3); also elsewhere on the board
/CMU-BQ79616 AFE Core/CB4: U2.26 (CB4); also elsewhere on the board
/CMU-BQ79616 AFE Core/CB5: U2.24 (CB5); also elsewhere on the board
/CMU-BQ79616 AFE Core/CB6: U2.22 (CB6); also elsewhere on the board
/CMU-BQ79616 AFE Core/CB7: U2.20 (CB7); also elsewhere on the board
/CMU-BQ79616 AFE Core/CB8: U2.18 (CB8); also elsewhere on the board
/CMU-BQ79616 AFE Core/CB9: U2.16 (CB9); also elsewhere on the board
/CMU-BQ79616 AFE Core/CB10: U2.14 (CB10); also elsewhere on the board
/CMU-BQ79616 AFE Core/CB11: U2.12 (CB11); also elsewhere on the board
/CMU-BQ79616 AFE Core/CB12: U2.10 (CB12); also elsewhere on the board
/CMU-BQ79616 AFE Core/CB13: U2.8 (CB13); also elsewhere on the board
/CMU-BQ79616 AFE Core/CB14: U2.6 (CB14); also elsewhere on the board
/CMU-BQ79616 AFE Core/CB15: U2.4 (CB15); also elsewhere on the board
/CMU-BQ79616 AFE Core/CB16: U2.2 (CB16); also elsewhere on the board
/CMU-BQ79616 AFE Core/COMHN: U2.42 (COMHN); also elsewhere on the board
/CMU-BQ79616 AFE Core/COMHP: U2.43 (COMHP); also elsewhere on the board
/CMU-BQ79616 AFE Core/COMLN: U2.41 (COMLN); also elsewhere on the board
/CMU-BQ79616 AFE Core/COMLP: U2.40 (COMLP); also elsewhere on the board
/CMU-BQ79616 AFE Core/GPIO1: C44.1, J5.1, R39.2, U2.61 (GPIO1)
/CMU-BQ79616 AFE Core/GPIO2: C45.1, J6.1, R40.2, U2.60 (GPIO2)
/CMU-BQ79616 AFE Core/GPIO3: C46.1, J7.1, R41.2, U2.59 (GPIO3)
/CMU-BQ79616 AFE Core/GPIO4: C47.1, J8.1, R42.2, U2.58 (GPIO4)
/CMU-BQ79616 AFE Core/GPIO5: C48.1, J9.1, R43.2, U2.57 (GPIO5)
/CMU-BQ79616 AFE Core/GPIO6: C49.1, J10.1, R44.2, U2.56 (GPIO6)
/CMU-BQ79616 AFE Core/GPIO7: C50.1, J11.1, R45.2, U2.55 (GPIO7)
/CMU-BQ79616 AFE Core/GPIO8: C51.1, J12.1, R46.2, U2.54 (GPIO8)
/CMU-BQ79616 AFE Core/LDOIN: C35.1, TP22.1 (1_1), U1.3, U2.47 (LDOIN)
/CMU-BQ79616 AFE Core/NPNB: TP23.1 (1_1), U1.1, U2.48 (NPNB)
/CMU-BQ79616 AFE Core/PWR: R36.1, R37.1; also elsewhere on the board
/CMU-BQ79616 AFE Core/TSREF: C43.1, R39.1, R40.1, R41.1, R42.1, R43.1, R44.1, R45.1, R46.1, TP26.1 (1_1), U2.51 (TSREF)
/CMU-BQ79616 AFE Core/VC0: U2.35 (VC0); also elsewhere on the board
/CMU-BQ79616 AFE Core/VC1: U2.33 (VC1); also elsewhere on the board
/CMU-BQ79616 AFE Core/VC2: U2.31 (VC2); also elsewhere on the board
/CMU-BQ79616 AFE Core/VC3: U2.29 (VC3); also elsewhere on the board
/CMU-BQ79616 AFE Core/VC4: U2.27 (VC4); also elsewhere on the board
/CMU-BQ79616 AFE Core/VC5: U2.25 (VC5); also elsewhere on the board
/CMU-BQ79616 AFE Core/VC6: U2.23 (VC6); also elsewhere on the board
/CMU-BQ79616 AFE Core/VC7: U2.21 (VC7); also elsewhere on the board
/CMU-BQ79616 AFE Core/VC8: U2.19 (VC8); also elsewhere on the board
/CMU-BQ79616 AFE Core/VC9: U2.17 (VC9); also elsewhere on the board
/CMU-BQ79616 AFE Core/VC10: U2.15 (VC10); also elsewhere on the board
/CMU-BQ79616 AFE Core/VC11: U2.13 (VC11); also elsewhere on the board
/CMU-BQ79616 AFE Core/VC12: U2.11 (VC12); also elsewhere on the board
/CMU-BQ79616 AFE Core/VC13: U2.9 (VC13); also elsewhere on the board
/CMU-BQ79616 AFE Core/VC14: U2.7 (VC14); also elsewhere on the board
/CMU-BQ79616 AFE Core/VC15: U2.5 (VC15); also elsewhere on the board
/CMU-BQ79616 AFE Core/VC16: U2.3 (VC16); also elsewhere on the board
CELL0: C35.2, C36.2, C37.2, C38.2, C39.2, C40.2, C41.2, C42.2, C43.2, C44.2, C45.2, C46.2, C47.2, C48.2, C49.2, C50.2, C51.2, D1.1 (K), J5.2, J6.2, J7.2, J8.2, J9.2, J10.2, J11.2, J12.2, U2.36 (REFHM), U2.39 (AVSS), U2.46 (CVSS), U2.50 (DVSS), U2.65 (PAD); also elsewhere on the board
unnamed: C36.1, R35.2, U1.2
unnamed: D1.2 (A), R38.2
unnamed: R35.1, R36.2
unnamed: C39.1, TP18.1 (1_1), U2.38 (AVDD)
unnamed: C37.1, R37.2, TP24.1 (1_1), U2.1 (BAT)
unnamed: C40.1, R38.1, TP19.1 (1_1), U2.45 (CVDD), U2.52 (RX)
unnamed: C42.1, TP20.1 (1_1), U2.49 (DVDD)
unnamed: TP25.1 (1_1), U2.62 (FAULT_N)
unnamed: C41.1, TP21.1 (1_1), U2.44 (NEG5V)
unnamed: C38.1, U2.37 (REFHP)

Notes on the sheet:
1.8V
5V-A
Power LED
Leave floating if not bottom battery pack; probably just don't use
GPIOs Temperature Sensing
PWR provides the stack-powered input for the BQ79616.
Not used; pull to CVDD
GPIO1–GPIO8 are routed to NTC headers for external temperature sensing.
TSREF provides the NTC bias reference.

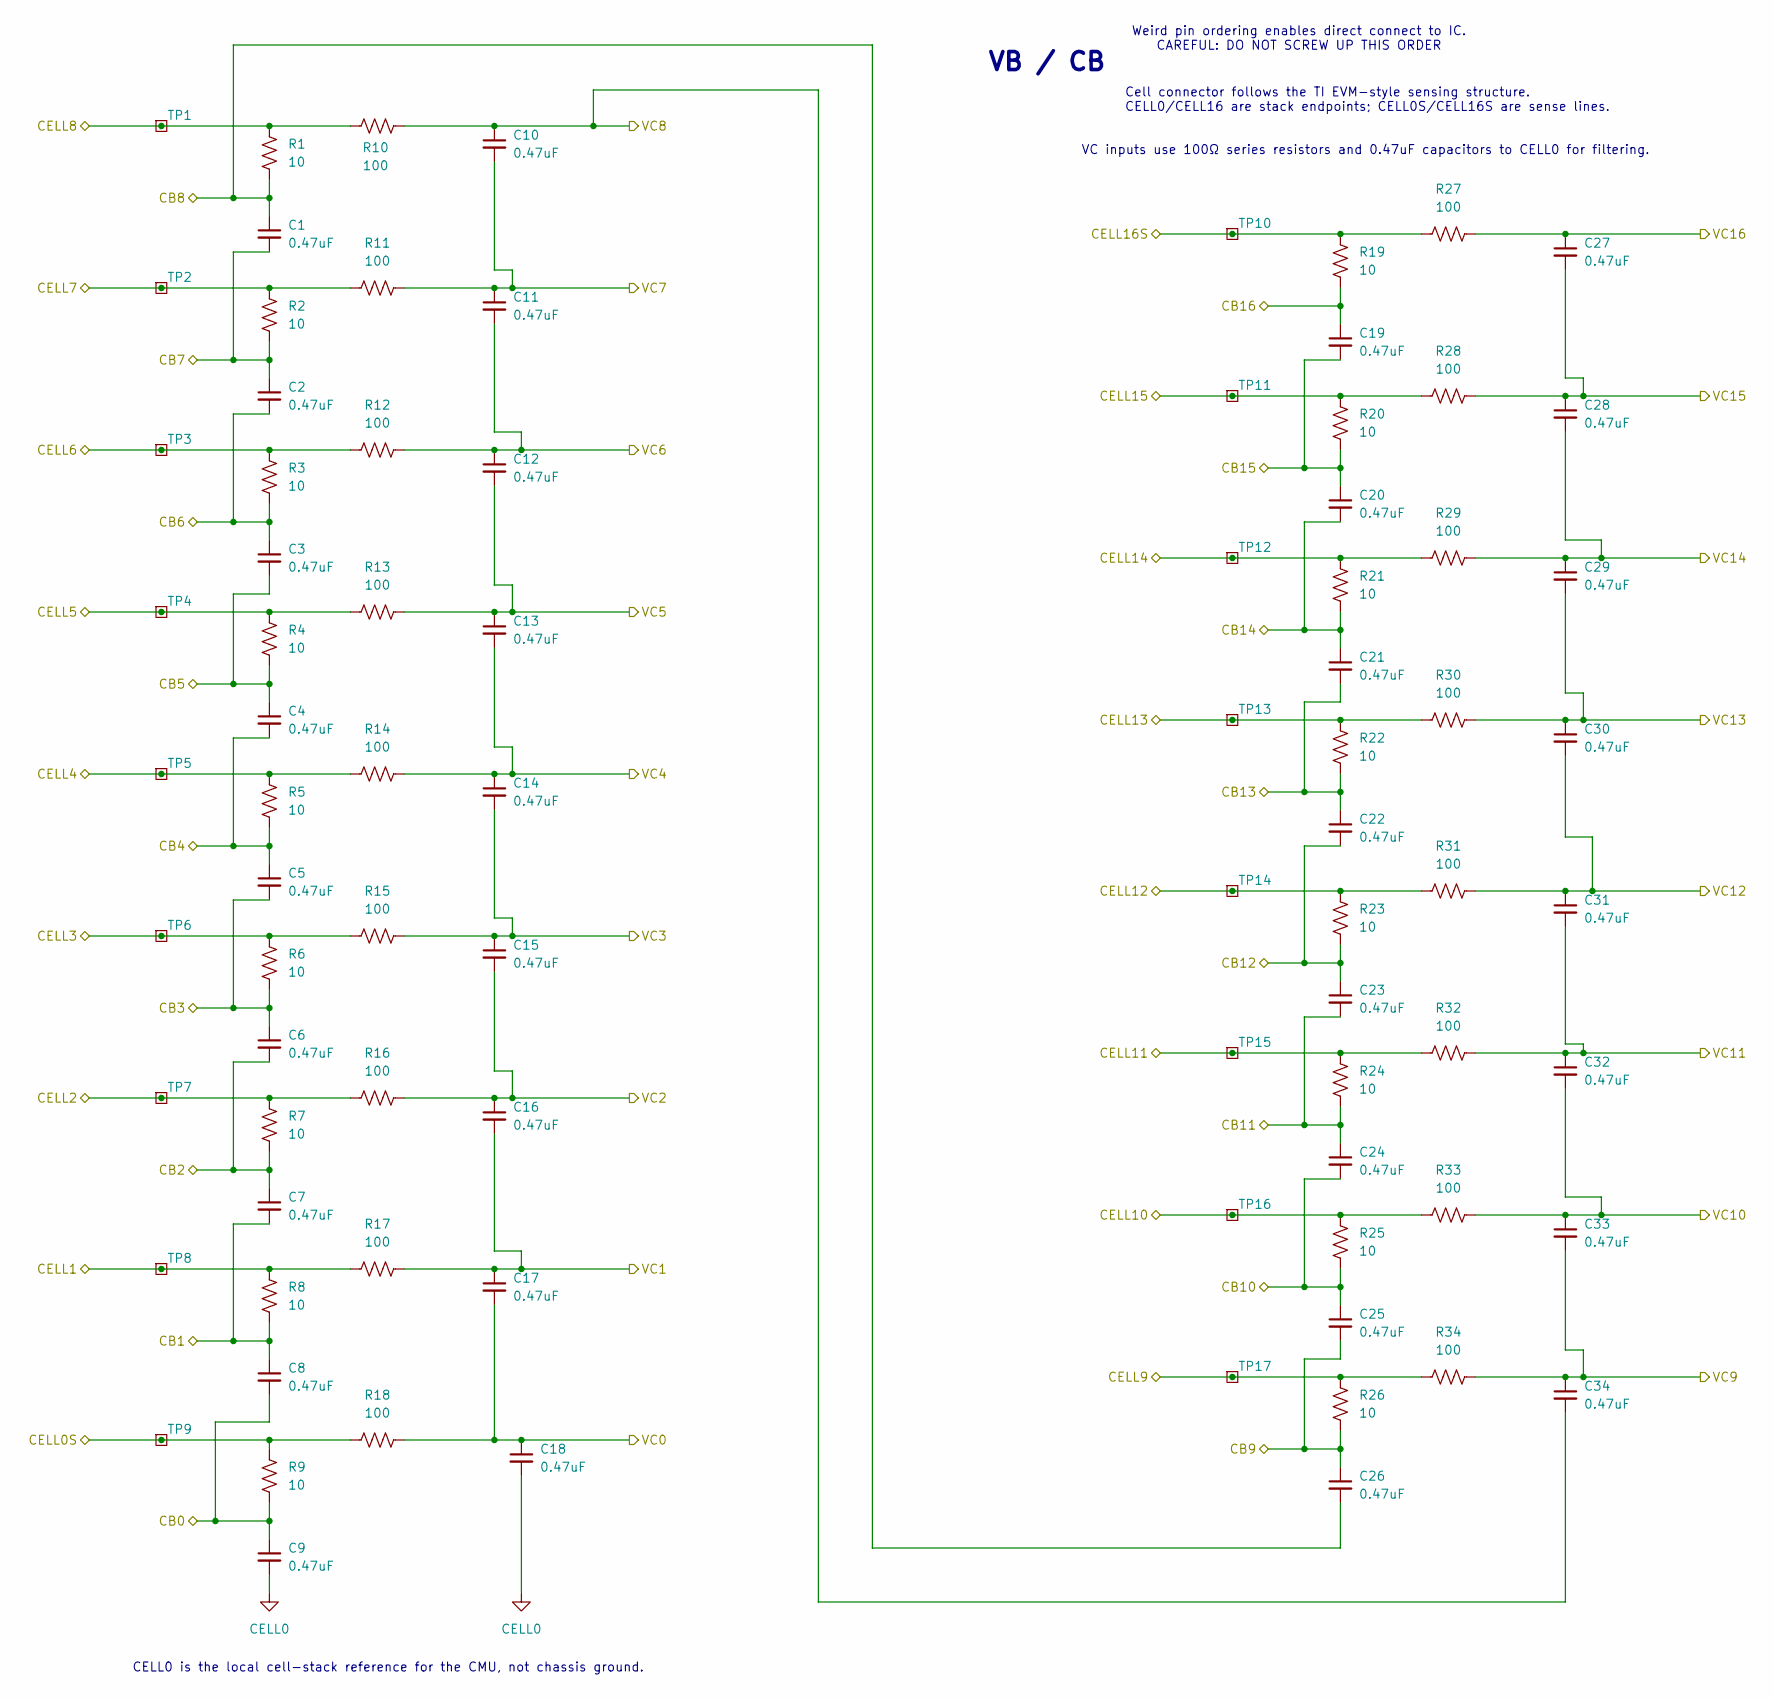
[picture p43: schematic cmu-cell-filtering.kicad_sch, Cell Monitoring Unit（CMU）]

Parts:
C1, C2, C3, C4, C5, C6, C7, C8, C9, C10, C11, C12, C13, C14, C15, C16, C17, C18, C19, C20, C21, C22, C23, C24, C25, C26, C27, C28, C29, C30, C31, C32, C33, C34: 0.47uF; C_0805_2012Metric; MPN CS0805KKX7R9BB474
R1, R2, R3, R4, R5, R6, R7, R8, R9, R19, R20, R21, R22, R23, R24, R25, R26: 10; R_1210_3225Metric; MPN RC1210FR-0710RL
R10, R11, R12, R13, R14, R15, R16, R17, R18, R27, R28, R29, R30, R31, R32, R33, R34: 100; R_0805_2012Metric; MPN RC0805FR-07100RL
TP1, TP2, TP3, TP4, TP5, TP6, TP7, TP8, TP9, TP10, TP11, TP12, TP13, TP14, TP15, TP16, TP17: TestPoint_Square; TestPoint_THTPad_D1.5mm_Drill0.7mm

Connections:
/CELL0S: R9.1, R18.1, TP9.1 (1_1); also elsewhere on the board
/CMU-BQ79616 AFE Core/CB0: C8.2, C9.1, R9.2; also elsewhere on the board
/CMU-BQ79616 AFE Core/CB1: C7.2, C8.1, R8.2; also elsewhere on the board
/CMU-BQ79616 AFE Core/CB2: C6.2, C7.1, R7.2; also elsewhere on the board
/CMU-BQ79616 AFE Core/CB3: C5.2, C6.1, R6.2; also elsewhere on the board
/CMU-BQ79616 AFE Core/CB4: C4.2, C5.1, R5.2; also elsewhere on the board
/CMU-BQ79616 AFE Core/CB5: C3.2, C4.1, R4.2; also elsewhere on the board
/CMU-BQ79616 AFE Core/CB6: C2.2, C3.1, R3.2; also elsewhere on the board
/CMU-BQ79616 AFE Core/CB7: C1.2, C2.1, R2.2; also elsewhere on the board
/CMU-BQ79616 AFE Core/CB8: C1.1, C26.2, R1.2; also elsewhere on the board
/CMU-BQ79616 AFE Core/CB9: C25.2, C26.1, R26.2; also elsewhere on the board
/CMU-BQ79616 AFE Core/CB10: C24.2, C25.1, R25.2; also elsewhere on the board
/CMU-BQ79616 AFE Core/CB11: C23.2, C24.1, R24.2; also elsewhere on the board
/CMU-BQ79616 AFE Core/CB12: C22.2, C23.1, R23.2; also elsewhere on the board
/CMU-BQ79616 AFE Core/CB13: C21.2, C22.1, R22.2; also elsewhere on the board
/CMU-BQ79616 AFE Core/CB14: C20.2, C21.1, R21.2; also elsewhere on the board
/CMU-BQ79616 AFE Core/CB15: C19.2, C20.1, R20.2; also elsewhere on the board
/CMU-BQ79616 AFE Core/CB16: C19.1, R19.2; also elsewhere on the board
/CMU-BQ79616 AFE Core/VC0: C17.2, C18.1, R18.2; also elsewhere on the board
/CMU-BQ79616 AFE Core/VC1: C16.2, C17.1, R17.2; also elsewhere on the board
/CMU-BQ79616 AFE Core/VC2: C15.2, C16.1, R16.2; also elsewhere on the board
/CMU-BQ79616 AFE Core/VC3: C14.2, C15.1, R15.2; also elsewhere on the board
/CMU-BQ79616 AFE Core/VC4: C13.2, C14.1, R14.2; also elsewhere on the board
/CMU-BQ79616 AFE Core/VC5: C12.2, C13.1, R13.2; also elsewhere on the board
/CMU-BQ79616 AFE Core/VC6: C11.2, C12.1, R12.2; also elsewhere on the board
/CMU-BQ79616 AFE Core/VC7: C10.2, C11.1, R11.2; also elsewhere on the board
/CMU-BQ79616 AFE Core/VC8: C10.1, C34.2, R10.2; also elsewhere on the board
/CMU-BQ79616 AFE Core/VC9: C33.2, C34.1, R34.2; also elsewhere on the board
/CMU-BQ79616 AFE Core/VC10: C32.2, C33.1, R33.2; also elsewhere on the board
/CMU-BQ79616 AFE Core/VC11: C31.2, C32.1, R32.2; also elsewhere on the board
/CMU-BQ79616 AFE Core/VC12: C30.2, C31.1, R31.2; also elsewhere on the board
/CMU-BQ79616 AFE Core/VC13: C29.2, C30.1, R30.2; also elsewhere on the board
/CMU-BQ79616 AFE Core/VC14: C28.2, C29.1, R29.2; also elsewhere on the board
/CMU-BQ79616 AFE Core/VC15: C27.2, C28.1, R28.2; also elsewhere on the board
/CMU-BQ79616 AFE Core/VC16: C27.1, R27.2; also elsewhere on the board
/CMU-Cell Filtering & Balancing/CELL1: R8.1, R17.1, TP8.1 (1_1); also elsewhere on the board
/CMU-Cell Filtering & Balancing/CELL2: R7.1, R16.1, TP7.1 (1_1); also elsewhere on the board
/CMU-Cell Filtering & Balancing/CELL3: R6.1, R15.1, TP6.1 (1_1); also elsewhere on the board
/CMU-Cell Filtering & Balancing/CELL4: R5.1, R14.1, TP5.1 (1_1); also elsewhere on the board
/CMU-Cell Filtering & Balancing/CELL5: R4.1, R13.1, TP4.1 (1_1); also elsewhere on the board
/CMU-Cell Filtering & Balancing/CELL6: R3.1, R12.1, TP3.1 (1_1); also elsewhere on the board
/CMU-Cell Filtering & Balancing/CELL7: R2.1, R11.1, TP2.1 (1_1); also elsewhere on the board
/CMU-Cell Filtering & Balancing/CELL8: R1.1, R10.1, TP1.1 (1_1); also elsewhere on the board
/CMU-Cell Filtering & Balancing/CELL9: R26.1, R34.1, TP17.1 (1_1); also elsewhere on the board
/CMU-Cell Filtering & Balancing/CELL10: R25.1, R33.1, TP16.1 (1_1); also elsewhere on the board
/CMU-Cell Filtering & Balancing/CELL11: R24.1, R32.1, TP15.1 (1_1); also elsewhere on the board
/CMU-Cell Filtering & Balancing/CELL12: R23.1, R31.1, TP14.1 (1_1); also elsewhere on the board
/CMU-Cell Filtering & Balancing/CELL13: R22.1, R30.1, TP13.1 (1_1); also elsewhere on the board
/CMU-Cell Filtering & Balancing/CELL14: R21.1, R29.1, TP12.1 (1_1); also elsewhere on the board
/CMU-Cell Filtering & Balancing/CELL15: R20.1, R28.1, TP11.1 (1_1); also elsewhere on the board
/CMU-Cell Filtering & Balancing/CELL16S: R19.1, R27.1, TP10.1 (1_1); also elsewhere on the board
CELL0: C9.2, C18.2; also elsewhere on the board

Notes on the sheet:
CELL0 is the local cell-stack reference for the CMU, not chassis ground.
VC inputs use 100Ω series resistors and 0.47uF capacitors to CELL0 for filtering.
Cell connector follows the TI EVM-style sensing structure. CELL0/CELL16 are stack endpoints; CELL0S/CELL16S are sense lines.
Weird pin ordering enables direct connect to IC. CAREFUL: DO NOT SCREW UP THIS ORDER
VB / CB

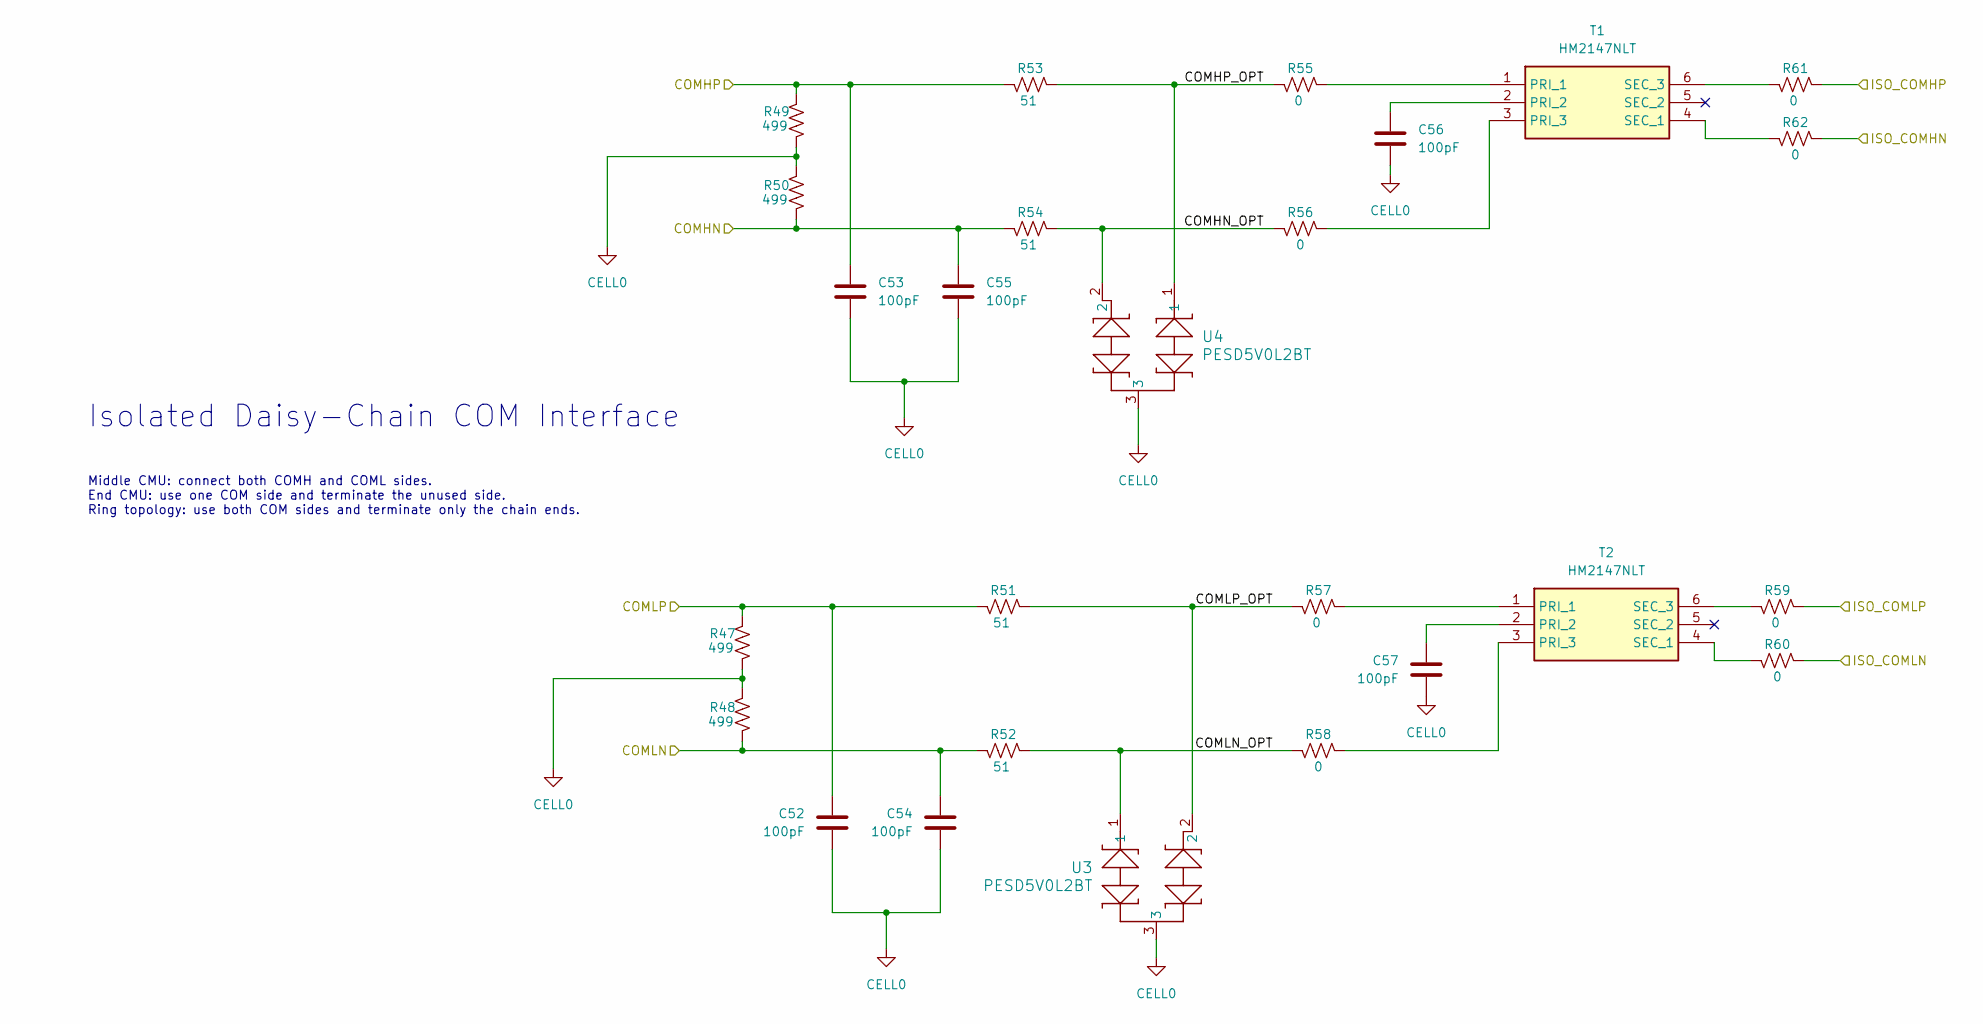
[picture p44: schematic cmu-isolation.kicad_sch, Cell Monitoring Unit（CMU）]

Parts:
C52, C53, C54, C55, C56, C57: 100pF; C_0805_2012Metric; MPN CC0805KRNPO9BN101
R47, R48, R49, R50: 499; R_0805_2012Metric; MPN RC0805FR-07499RL
R51, R52, R53, R54: 51; R_0805_2012Metric; MPN RC0805FR-0751RL
R55, R56, R57, R58, R59, R60, R61, R62: 0; R_0805_2012Metric; MPN RC0805JR-070RL
T1, T2: HM2147NLT; Manufacturer_Part_Number HM2147NLT; Mouser Part Number 673-HM2147NLT
U3, U4: PESD5V0L2BT; SOT23_NEX; MPN PESD5V0L2BT,215

Connections:
/CMU-BQ79616 AFE Core/COMHN: C55.1, R50.2, R54.2; also elsewhere on the board
/CMU-BQ79616 AFE Core/COMHP: C53.1, R49.1, R53.2; also elsewhere on the board
/CMU-BQ79616 AFE Core/COMLN: C54.1, R48.2, R52.2; also elsewhere on the board
/CMU-BQ79616 AFE Core/COMLP: C52.1, R47.1, R51.2; also elsewhere on the board
/CMU-Daisy-Chain Interface/COMHN_OPT: R54.1, R56.2, U4.2
/CMU-Daisy-Chain Interface/COMHP_OPT: R53.1, R55.2, U4.1
/CMU-Daisy-Chain Interface/COMLN_OPT: R52.1, R58.2, U3.1
/CMU-Daisy-Chain Interface/COMLP_OPT: R51.1, R57.2, U3.2
/CMU-Daisy-Chain Interface/ISO_COMHN: R62.1; also elsewhere on the board
/CMU-Daisy-Chain Interface/ISO_COMHP: R61.1; also elsewhere on the board
/CMU-Daisy-Chain Interface/ISO_COMLN: R60.1; also elsewhere on the board
/CMU-Daisy-Chain Interface/ISO_COMLP: R59.1; also elsewhere on the board
CELL0: C52.2, C53.2, C54.2, C55.2, C56.2, C57.2, R47.2, R48.1, R49.2, R50.1, U3.3, U4.3; also elsewhere on the board
unnamed: R55.1, T1.1 (PRI_1)
unnamed: C56.1, T1.2 (PRI_2)
unnamed: R56.1, T1.3 (PRI_3)
unnamed: R62.2, T1.4 (SEC_1)
unnamed: R61.2, T1.6 (SEC_3)
unnamed: R57.1, T2.1 (PRI_1)
unnamed: C57.1, T2.2 (PRI_2)
unnamed: R58.1, T2.3 (PRI_3)
unnamed: R60.2, T2.4 (SEC_1)
unnamed: R59.2, T2.6 (SEC_3)

Notes on the sheet:
Isolated Daisy-Chain COM Interface
Middle CMU: connect both COMH and COML sides. End CMU: use one COM side and terminate the unused side. Ring topology: use both COM sides and terminate only the chain ends.

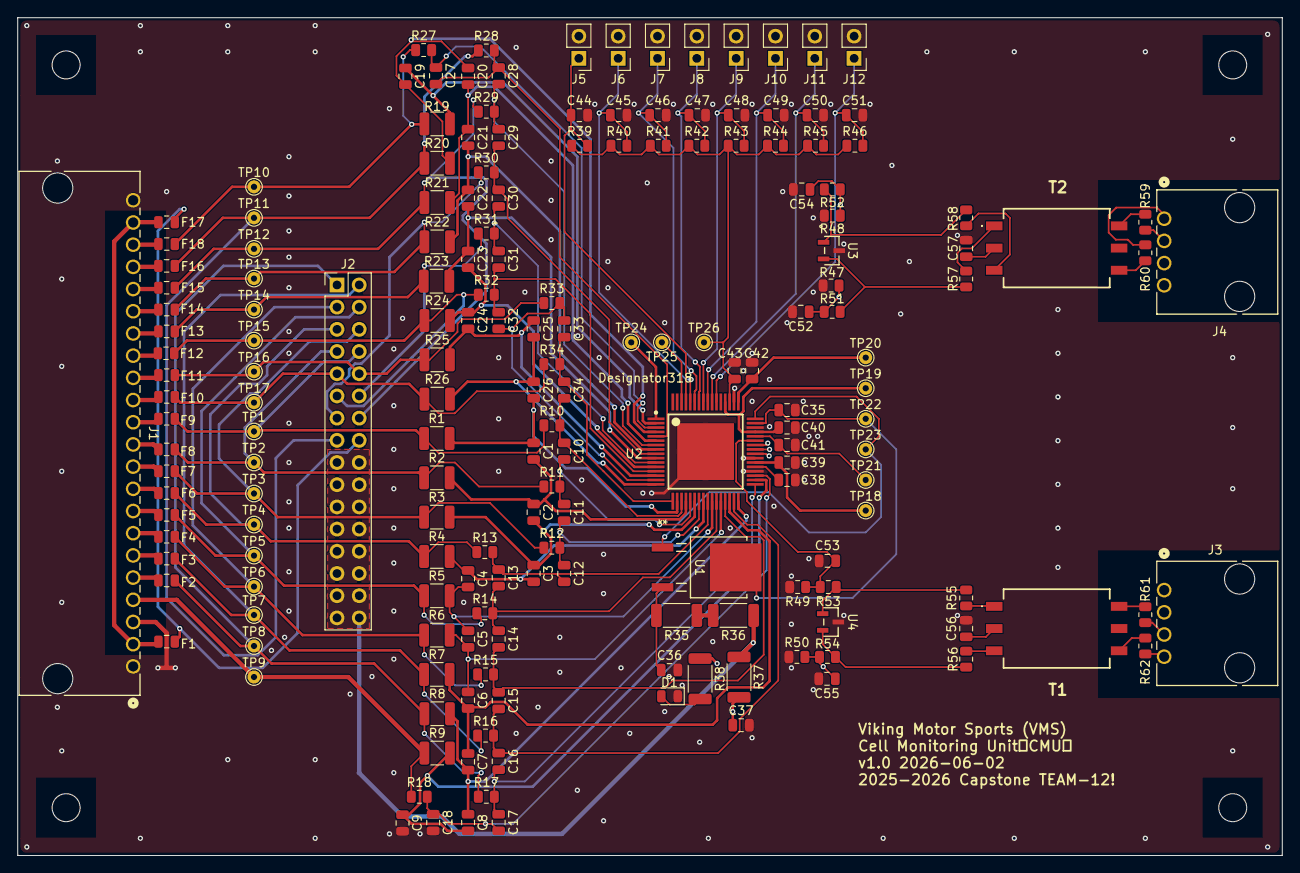
[picture p45: board Cell Monitoring Unit (CMU).kicad_pcb from above]

Board: 4 copper layers, 144.7 x 95.9 mm, 182 parts (0 on the bottom side), 114 nets.
