VikingMotorsports/Battery-Management-System-Capstone-2026/Hardware/Shunt_circuit/Shunt circuit.kicad_pcb

## KiCad design Hardware/Shunt_circuit/Shunt circuit.kicad_pcb (2026-06-02)

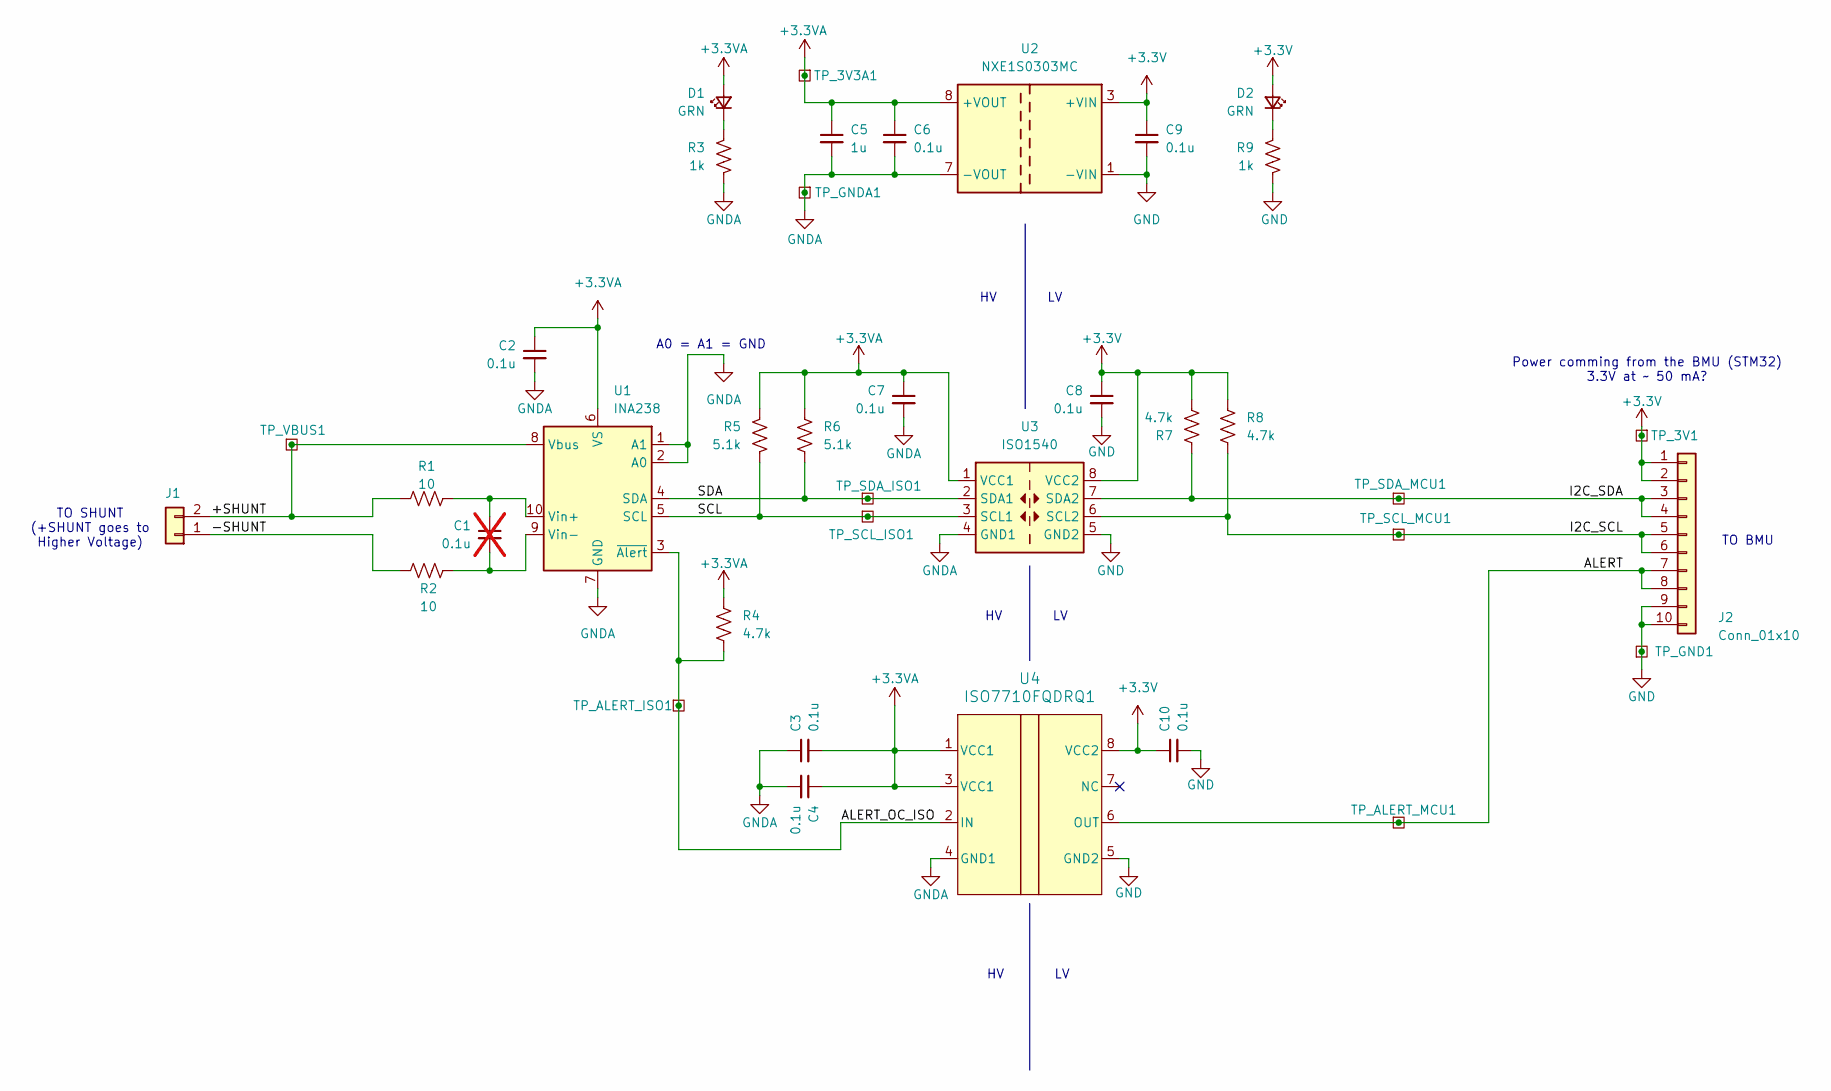
[picture p46: schematic Shunt circuit.kicad_sch, Current Sense Board]

Parts:
C1: 0.1u; C_0805_2012Metric; not fitted
C2, C3, C4, C6, C7, C8, C9, C10: 0.1u; C_0805_2012Metric; MPN CC0805KRX7R9BB104
C5: 1u; C_0805_2012Metric; MPN CC0805KKX7R7BB105
D1: GRN; LED_0805_2012Metric; MPN LTST-C170KRKT
D2: GRN; LED_0805_2012Metric; MPN LTST-C170GKT
J1: Shunt Voltage Measuring Points; TerminalBlock_Phoenix_MKDS-1,5-2-5.08_1x02_P5.08mm_Horizont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; MPN 1715721
J2: Conn_01x10; PinHeader_1x10_P2.54mm_Vertical; MPN PRPC010SAAN-RC
R1, R2: 10; R_0805_2012Metric; MPN RC0805FR-0710RL
R3, R9: 1k; R_0805_2012Metric; MPN RC0805FR-071KL
R4, R7, R8: 4.7k; R_0805_2012Metric; MPN RC0805FR-074K7L
R5, R6: 5.1k; R_0805_2012Metric; MPN RC0805FR-075K1L
TP_3V1, TP_3V3A1: TestPoint_Square; TestPoint_Pad_1.0x1.0mm
TP_ALERT_ISO1: TestPoint_Square; TestPoint_Pad_1.0x1.0mm
TP_ALERT_MCU1: TestPoint_Square; TestPoint_Pad_1.0x1.0mm
TP_GND1: TestPoint_Square; TestPoint_Pad_1.0x1.0mm
TP_GNDA1: TestPoint_Square; TestPoint_Pad_1.0x1.0mm
TP_SCL_ISO1: TestPoint_Square; TestPoint_Pad_1.0x1.0mm
TP_SCL_MCU1: TestPoint_Square; TestPoint_Pad_1.0x1.0mm
TP_SDA_ISO1: TestPoint_Square; TestPoint_Pad_1.0x1.0mm
TP_SDA_MCU1: TestPoint_Square; TestPoint_Pad_1.0x1.0mm
TP_VBUS1: TestPoint_Square; TestPoint_Pad_1.0x1.0mm
U1: INA238; TSSOP-10_3x3mm_P0.5mm; MPN INA238AQDGSRQ1
U2: NXE1S0303MC; Converter_DCDC_Murata_NXExSxxxxMC_SMD; MPN NXF1S0303MC-R7
U3: ISO1540; SOIC-8_3.9x4.9mm_P1.27mm; MPN ISO1540QDRQ1
U4: ISO7710FQDRQ1; D0008B_N; MPN ISO7710FQDRQ1

Connections:
+3.3V: C8.1, C9.1, C10.1, D2.2 (A), J2.1, J2.2, R7.2, R8.1, TP_3V1.1 (1_1), U2.3 (+VIN), U3.8 (VCC2), U4.8 (VCC2)
+3.3VA: C2.1, C3.2, C4.1, C5.1, C6.1, C7.1, D1.2 (A), R4.2, R5.1, R6.1, TP_3V3A1.1 (1_1), U1.6 (VS), U2.8 (+VOUT), U3.1 (VCC1), U4.1 (VCC1), U4.3 (VCC1)
/+SHUNT: J1.2, R1.1, TP_VBUS1.1 (1_1), U1.8 (Vbus)
/-SHUNT: J1.1, R2.1
/ALERT: J2.7, J2.8, TP_ALERT_MCU1.1 (1_1), U4.6 (OUT)
/ALERT_OC_ISO: R4.1, TP_ALERT_ISO1.1 (1_1), U1.3 (~Alert), U4.2 (IN)
/I2C_SCL: J2.5, J2.6, R8.2, TP_SCL_MCU1.1 (1_1), U3.6 (SCL2)
/I2C_SDA: J2.3, J2.4, R7.1, TP_SDA_MCU1.1 (1_1), U3.7 (SDA2)
/SCL: R5.2, TP_SCL_ISO1.1 (1_1), U1.5 (SCL), U3.3 (SCL1)
/SDA: R6.2, TP_SDA_ISO1.1 (1_1), U1.4 (SDA), U3.2 (SDA1)
GND: C8.2, C9.2, C10.2, J2.9, J2.10, R9.2, TP_GND1.1 (1_1), U2.1 (-VIN), U3.5 (GND2), U4.5 (GND2)
GNDA: C2.2, C3.1, C4.2, C5.2, C6.2, C7.2, R3.2, TP_GNDA1.1 (1_1), U1.1 (A1), U1.2 (A0), U1.7 (GND), U2.7 (-VOUT), U3.4 (GND1), U4.4 (GND1)
unnamed: D1.1 (K), R3.1
unnamed: D2.1 (K), R9.1
unnamed: C1.1, R1.2, U1.10 (Vin+)
unnamed: C1.2, R2.2, U1.9 (Vin-)

Notes on the sheet:
Power comming from the BMU (STM32) 3.3V at ~ 50 mA?
TO SHUNT (+SHUNT goes to Higher Voltage)
TO BMU
A0 = A1 = GND

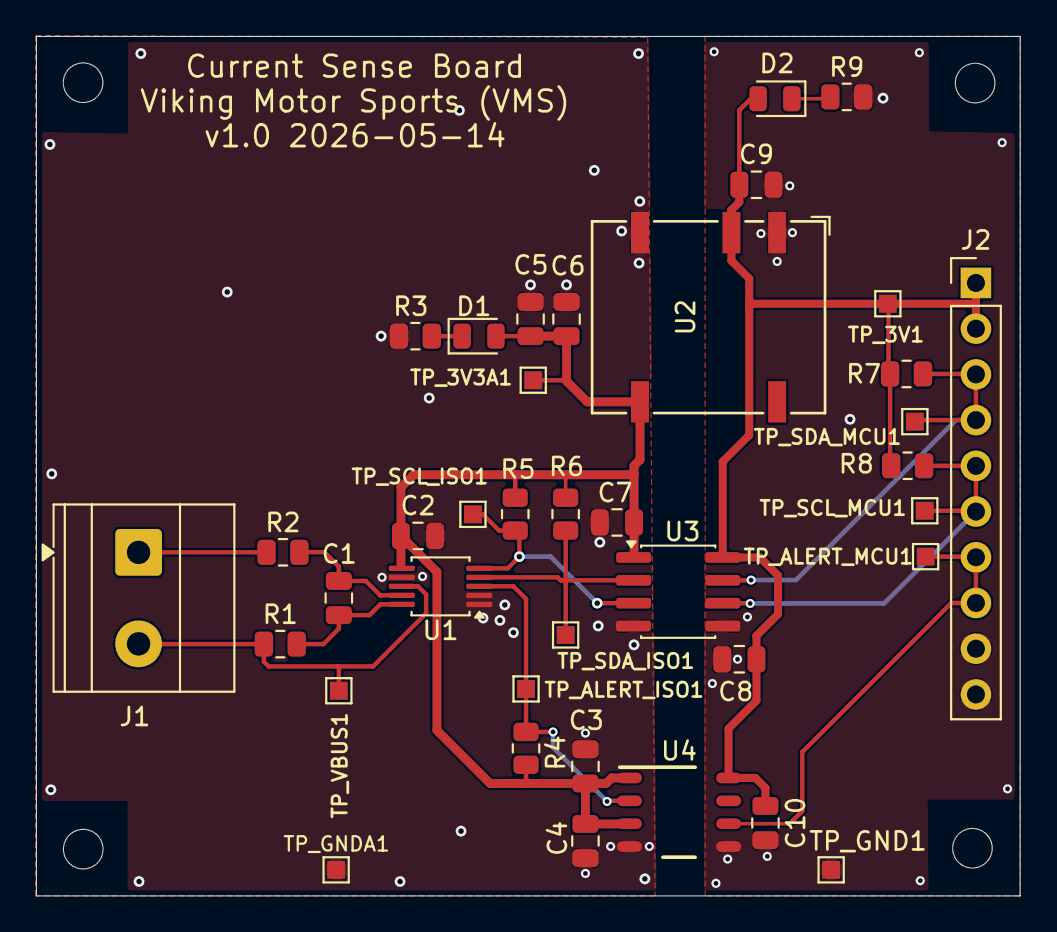
[picture p47: board Shunt circuit.kicad_pcb from above]

Board: 2 copper layers, 54.7 x 47.8 mm, 38 parts (0 on the bottom side), 16 nets.
