VikingMotorsports/Battery-Management-System-Capstone-2026/Hardware/BMU/BMU.kicad_pcb

## KiCad design Hardware/BMU/BMU.kicad_pcb (2026-05-03)

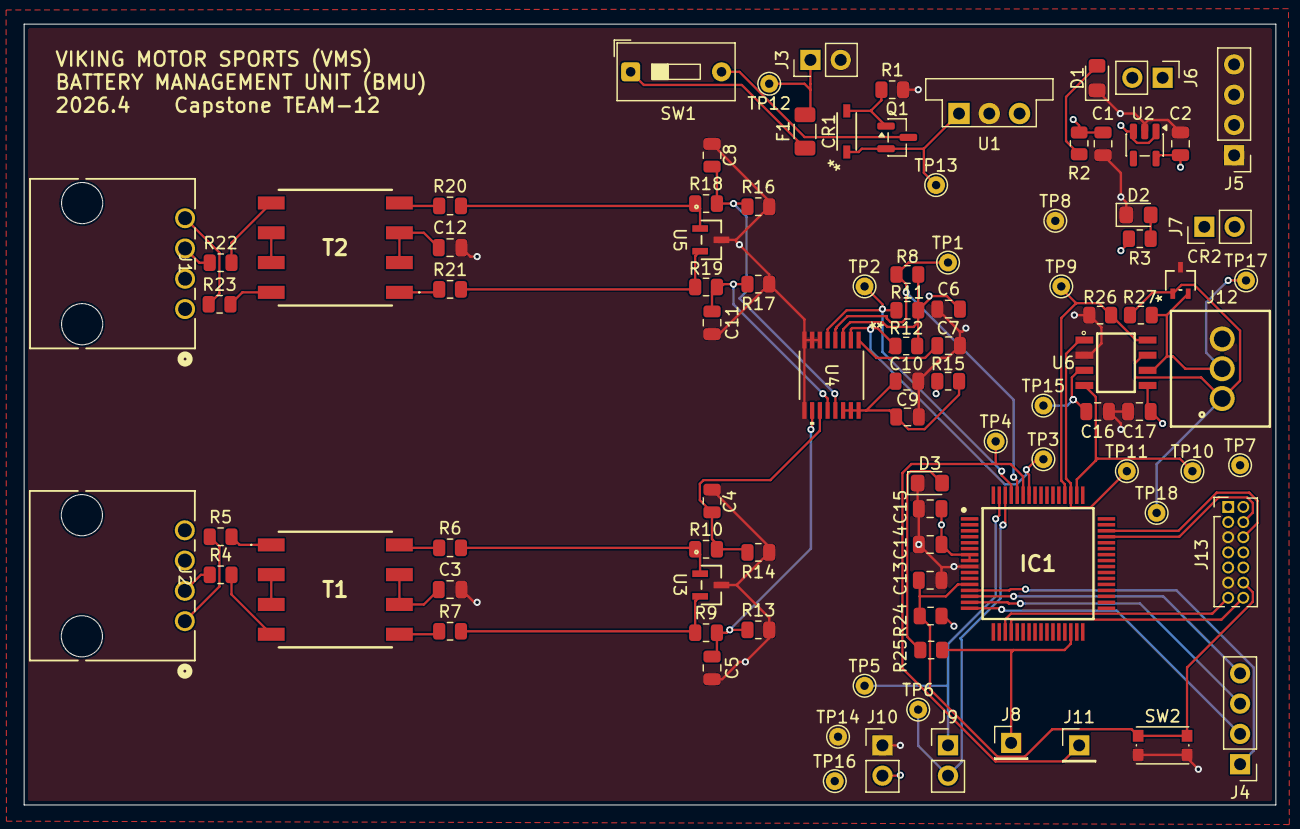
[picture p48: board BMU.kicad_pcb from above]

Board: 4 copper layers, 105.0 x 65.5 mm, 93 parts (0 on the bottom side), 58 nets.

Parts:
C1, C2, C14: 1u; C_0805_2012Metric
C3, C4, C5, C8, C11, C12: 100pF; C_0805_2012Metric
C6, C10: 0.1u; C_0805_2012Metric
C7, C9: 0.22u; C_0805_2012Metric
C13, C15, C16, C17: 100n; C_0805_2012Metric
CR1: MMSZ5245B-7-F; SOD123_DIO
CR2: ESDCAN03-2BWY; SOT323-3L_STM
D1, D2, D3: LED; LED_0805_2012Metric_Pad1.15x1.40mm_HandSolder
F1: Fuse; Fuse_1206_3216Metric
IC1: STM32C092RCT6; QFP50P1200X1200X160-64N
J1: HIGH SIDE; CONN_70551-xxxx_04_MOL
J2: LOW SIDE; CONN_70551-xxxx_04_MOL
J3: POWER; PinHeader_1x02_P2.54mm_Vertical
J4: GPIO; PinHeader_1x04_P2.54mm_Vertical
J5: GND; PinHeader_1x04_P2.54mm_Vertical
J6: 5V; PinHeader_1x02_P2.54mm_Vertical
J7: 3V3; PinHeader_1x02_P2.54mm_Vertical
J8: FAULT; PinHeader_1x01_P2.54mm_Vertical
J9: I2C; PinHeader_1x02_P2.54mm_Vertical
J10: SHUNT; PinHeader_1x02_P2.54mm_Vertical
J11: ALERT; PinHeader_1x01_P2.54mm_Vertical
J12: CAN; 691382000003
J13: Conn_ST_STDC14; PinHeader_2x07_P1.27mm_Vertical
Q1: DMP3099L; SOT-23
R1, R8, R11: 100k; R_0805_2012Metric
R2, R3, R25: 1k; R_0805_2012Metric
R4, R5, R6, R7, R20, R21, R22, R23: 0; R_0805_2012Metric
R9, R10, R18, R19: 51; R_0805_2012Metric
R12, R24, R26: 10k; R_0805_2012Metric
R13, R14, R16, R17: 499; R_0805_2012Metric
R15: 10; R_0805_2012Metric
R27: 120; R_0805_2012Metric
SW1: Power Switch; SW_DIP_SPSTx01_Slide_9.78x4.72mm_W7.62mm_P2.54mm
SW2: RESET Switch; SW_Push_1P1T_NO_CK_KMR2
T1, T2: CEP99-102; CEP99102
TP1, TP2, TP3, TP4, TP5, TP6, TP7, TP8, TP9, TP10, TP11, TP12, TP13, TP14, TP15, TP16, TP17, TP18: TestPoint_Small; TestPoint_THTPad_D1.5mm_Drill0.7mm
U1: OKI-78SR-5_1.5-W36-C; Converter_DCDC_Murata_OKI-78SR_Vertical
U2: TLV75533PDBV; SOT-23-5
U3, U5: PESD5V0L2BT; SOT23_NEX
U4: BQ79600PWRQ1; TSSOP16_PW_TEX
U6: MCP2562FDT-H_SN; SOIC127P600X175-8N

Connections:
+3V3: C2.1, C6.2, C14.1, C15.1, C17.1, IC1.7 (VREF+), IC1.8 (VDD/VDDA), J7.1, J7.2, J10.2, J13.3 (VCC), R3.2, R8.1, R11.1, R12.1, R24.1, TP7.1 (1_1), TP16.1 (1_1), U2.5 (OUT), U4.3 (VIO), U6.5 (VIO)
+5V: C1.1, C16.2, J6.1, J6.2, R2.2, R15.1, TP15.1 (1_1), U1.3 (OUT), U2.1 (IN), U2.3 (EN), U6.3 (VDD)
+12V: F1.2, J3.1, TP12.1 (1_1)
/BMU-CAN/CAN_RX: IC1.50 (PD0), TP10.1 (1_1), U6.4 (RXD)
/BMU-CAN/CAN_STBY: IC1.52 (PD2), R26.1, TP9.1 (1_1), U6.8 (STBY)
/BMU-CAN/CAN_TX: IC1.51 (PD1), TP11.1 (1_1), U6.1 (TXD)
/BMU-COM Bridge/COMHN_OPT: R19.1, R21.2, U5.2
/BMU-COM Bridge/COMHP_OPT: R18.1, R20.2, U5.1
/BMU-COM Bridge/COMLN_OPT: R6.2, R10.1, U3.1
/BMU-COM Bridge/COMLP_OPT: R7.2, R9.1, U3.2
/BMU-COM Bridge/FAULT_N: IC1.58 (PB4), R12.2, TP3.1 (1_1), U4.2 (NFAULT)
/BMU-COM Bridge/MISO/TX: IC1.61 (PB7), R11.2, TP2.1 (1_1), U4.5 (TX/MISO)
/BMU-COM Bridge/MOSI/RX: IC1.60 (PB6), R8.2, TP1.1 (1_1), U4.4 (RX/MOSI)
/BMU-MCU/ALERT_SHUNT: IC1.59 (PB5), J11.1 (Pin_1_1), TP4.1 (1_1)
/BMU-MCU/FAULT_LED: IC1.30 (PB10), J8.1 (Pin_1_1), R25.1
/BMU-MCU/GPIO_SPARE1: IC1.14 (PC1), J4.4
/BMU-MCU/GPIO_SPARE2: IC1.15 (PC2), J4.3
/BMU-MCU/GPIO_SPARE3: IC1.16 (PC3), J4.2
/BMU-MCU/SHUTDOWN: IC1.13 (PC0), J4.1
/BMU-POWER/VIN_PROTECTED: CR1.1, Q1.2 (S), TP13.1 (1_1), U1.1 (IN)
/High COMHN: J1.4, R23.1
/High COMHP: J1.3, R22.1
/J4_CANH: CR2.1, J12.1, R27.2, TP18.1 (1_1), U6.7 (CANH)
/J4_CANL: CR2.2, J12.2, R27.1, TP17.1 (1_1), U6.6 (CANL)
/LOW COMLN: J2.1, R5.1
/LOW COMLP: J2.2, R4.1
/SCL_STM32: IC1.62 (PB8), J9.2, TP6.1 (1_1)
/SDA_STM32: IC1.63 (PB9), J9.1, TP5.1 (1_1)
COMHN: C11.1, R17.2, R19.2, U4.12 (COMHN)
COMHP: C8.1, R16.1, R18.2, U4.13 (COMHP)
COMLN: C4.1, R10.2, R14.2, U4.11 (COMLN)
COMLP: C5.1, R9.2, R13.1, U4.10 (COMLP)
GND: C1.2, C2.2, C3.2, C4.2, C5.2, C6.1, C7.2, C8.2, C9.2, C10.2, C11.2, C12.2, C13.1, C14.2, C15.2, C16.1, C17.2, CR2.3, D1.1 (K), D2.1 (K), D3.1 (K), IC1.9 (VSS/VSSA), J3.2, J5.1, J5.2, J5.3, J5.4, J10.1, J12.3, J13.5 (GND), J13.11 (GNDDetect), R1.2, R13.2, R14.1, R16.2, R17.1, R26.2, SW2.2 (B), TP8.1 (1_1), TP14.1 (1_1), U1.2 (GND), U2.2 (GND), U3.3, U4.6 (SCLK), U4.7 (NCS), U4.8 (NUART/SPI_(SPI_RDY)), U4.9 (GND), U5.3, U6.2 (VSS)
unnamed: C3.1, T1.6, T1.7
unnamed: C12.1, T2.2, T2.3
unnamed: D1.2 (A), R2.1
unnamed: D2.2 (A), R3.1
unnamed: D3.2 (A), R25.2
unnamed: IC1.19 (PA2), J13.13 (VCP_RX)
unnamed: IC1.20 (PA3), J13.14 (VCP_TX)
unnamed: IC1.45 (PA13), J13.4 (JTMS/SWDIO)
unnamed: IC1.46 (PA14-BOOT0), J13.6 (JCLK/SWCLK)
unnamed: C13.2, IC1.12 (PF2-NRST), J13.12 (~RST), R24.2, SW2.1 (A)
unnamed: Q1.3 (D), SW1.2 (B)
unnamed: CR1.2, Q1.1 (G), R1.1
unnamed: R4.2, T1.4
unnamed: R5.2, T1.1
unnamed: R6.1, T1.8
unnamed: R7.1, T1.5
unnamed: R20.1, T2.4
unnamed: R21.1, T2.1
unnamed: R22.2, T2.5
unnamed: R23.2, T2.8
unnamed: F1.1, SW1.1 (A)
unnamed: T1.2, T1.3
unnamed: T2.6, T2.7
unnamed: C9.1, C10.1, R15.2, U4.14 (CVDD), U4.15 (BAT), U4.16 (INH)
unnamed: C7.1, U4.1 (DVDD)
