VikingMotorsports/Battery-Management-System-Capstone-2026/Software/BMS_CAN_Message_Test (Decrepated)/src/main.c

/*
 * Copyright (c) 2018 Alexander Wachter
 *
 * SPDX-License-Identifier: Apache-2.0
 */

#include <stdio.h>

#include <zephyr/kernel.h>
#include <zephyr/sys/printk.h>
#include <zephyr/device.h>
#include <zephyr/drivers/can.h>
#include <zephyr/drivers/gpio.h>
#include <zephyr/sys/byteorder.h>

#define RX_THREAD_STACK_SIZE 512
#define RX_THREAD_PRIORITY 2
#define STATE_POLL_THREAD_STACK_SIZE 512
#define STATE_POLL_THREAD_PRIORITY 2
#define LED_MSG_ID 0x10
#define MSG_ID 0x12345
#define SET_LED 1
#define RESET_LED 0
#define SLEEP_TIME K_MSEC(250)

K_THREAD_STACK_DEFINE(rx_thread_stack, RX_THREAD_STACK_SIZE);
K_THREAD_STACK_DEFINE(poll_state_stack, STATE_POLL_THREAD_STACK_SIZE);

const struct device *const can_dev = DEVICE_DT_GET(DT_CHOSEN(zephyr_canbus));
struct gpio_dt_spec led = GPIO_DT_SPEC_GET_OR(DT_ALIAS(led0), gpios, {0});

struct k_thread rx_thread_data;
struct k_thread poll_state_thread_data;
struct k_work_poll change_led_work;
struct k_work state_change_work;
enum can_state current_state;
struct can_bus_err_cnt current_err_cnt;

void tx_irq_callback(const struct device *dev, int error, void *arg)
{
	char *sender = (char *)arg;

	ARG_UNUSED(dev);

	if (error != 0) {
		printf("Callback! error-code: %d\nSender: %s\n",
		       error, sender);
	}
}

char *state_to_str(enum can_state state)
{
	switch (state) {
	case CAN_STATE_ERROR_ACTIVE:
		return "error-active";
	case CAN_STATE_ERROR_WARNING:
		return "error-warning";
	case CAN_STATE_ERROR_PASSIVE:
		return "error-passive";
	case CAN_STATE_BUS_OFF:
		return "bus-off";
	case CAN_STATE_STOPPED:
		return "stopped";
	default:
		return "unknown";
	}
}

void poll_state_thread(void *unused1, void *unused2, void *unused3)
{
	struct can_bus_err_cnt err_cnt = {0, 0};
	struct can_bus_err_cnt err_cnt_prev = {0, 0};
	enum can_state state_prev = CAN_STATE_ERROR_ACTIVE;
	enum can_state state;
	int err;

	while (1) {
		err = can_get_state(can_dev, &state, &err_cnt);
		if (err != 0) {
			printf("Failed to get CAN controller state: %d", err);
			k_sleep(K_MSEC(100));
			continue;
		}

		if (err_cnt.tx_err_cnt != err_cnt_prev.tx_err_cnt ||
		    err_cnt.rx_err_cnt != err_cnt_prev.rx_err_cnt ||
		    state_prev != state) {

			err_cnt_prev.tx_err_cnt = err_cnt.tx_err_cnt;
			err_cnt_prev.rx_err_cnt = err_cnt.rx_err_cnt;
			state_prev = state;
			printf("state: %s\n"
			       "rx error count: %d\n"
			       "tx error count: %d\n",
			       state_to_str(state),
			       err_cnt.rx_err_cnt, err_cnt.tx_err_cnt);
		} else {
			k_sleep(K_MSEC(100));
		}
	}
}

void state_change_work_handler(struct k_work *work)
{
	printf("State Change ISR\nstate: %s\n"
	       "rx error count: %d\n"
	       "tx error count: %d\n",
		state_to_str(current_state),
		current_err_cnt.rx_err_cnt, current_err_cnt.tx_err_cnt);
}

void state_change_callback(const struct device *dev, enum can_state state,
			   struct can_bus_err_cnt err_cnt, void *user_data)
{
	struct k_work *work = (struct k_work *)user_data;

	ARG_UNUSED(dev);

	current_state = state;
	current_err_cnt = err_cnt;
	k_work_submit(work);
}

int main(void)
{
	struct can_frame counter_frame = {
		.flags = CAN_FRAME_IDE,
		.id = MSG_ID,
		.dlc = 2
	};
	uint8_t toggle = 1;
	uint16_t counter = 0;
	k_tid_t rx_tid, get_state_tid;
	int ret;

	if (!device_is_ready(can_dev)) {
		printf("CAN: Device %s not ready.\n", can_dev->name);
		return 0;
	}

	ret = can_start(can_dev);
	if (ret != 0) {
		printf("Error starting CAN controller [%d]", ret);
		return 0;
	}

	k_work_init(&state_change_work, state_change_work_handler);

	get_state_tid = k_thread_create(&poll_state_thread_data,
					poll_state_stack,
					K_THREAD_STACK_SIZEOF(poll_state_stack),
					poll_state_thread, NULL, NULL, NULL,
					STATE_POLL_THREAD_PRIORITY, 0,
					K_NO_WAIT);
	if (!get_state_tid) {
		printf("ERROR spawning poll_state_thread\n");
	}

	can_set_state_change_callback(can_dev, state_change_callback, &state_change_work);

	printf("Finished init.\n");

	while (1) {
		UNALIGNED_PUT(sys_cpu_to_be16(counter),
			      (uint16_t *)&counter_frame.data[0]);
		counter++;
		/* This sending call is blocking until the message is sent. */
		can_send(can_dev, &counter_frame, K_MSEC(100), NULL, NULL);
		k_sleep(SLEEP_TIME);
	}
}
