VikingMotorsports/Battery-Management-System-Capstone-2026/(commit log)

2026-05-02 update power part
    [BMU-CAN.kicad_sch, BMU-COM Bridge.kicad_sch, BMU-MCU.kicad_sch, BMU-POWER.kicad_sch, BMU.kicad_pcb, BMU.kicad_sch]
2026-05-03 finish BMU, add test point + comment
    [BMU-CAN.kicad_sch, BMU-COM Bridge.kicad_sch, BMU-MCU.kicad_sch, BMU-POWER.kicad_sch, BMU.kicad_pcb, BMU.kicad_sch]
2026-05-03 Update shunt circuit KiCad files
    [Shunt circuit.kicad_pcb, Shunt circuit.kicad_sch]
2026-05-04 Update monitor hardware files
    [Montior.kicad_pcb, Montior.kicad_sch]
2026-05-07 Both boards are now fully completed: the BMU and CMU.
    [BMU-CAN.kicad_sch, BMU-COM Bridge.kicad_sch, BMU-MCU.kicad_sch, BMU-POWER.kicad_sch, Battery Management Unit (BMU).kicad_pcb, Battery Management Unit (BMU).kicad_sch, Cell Monitoring Unit (CMU).kicad_pcb, Cell Monitoring Unit (CMU).kicad_sch]
2026-05-07 add mounting holes
    [Cell Monitoring Unit (CMU).kicad_pcb]
2026-05-08 update layout
    [Battery Management Unit (BMU).kicad_pcb, Cell Monitoring Unit (CMU).kicad_pcb]
2026-05-09 Schematic polish -- fixed to best standards, cleaned up for ERCs, etc
    [BMU-CAN.kicad_sch, BMU-COM Bridge.kicad_sch, BMU-MCU.kicad_sch, BMU-POWER.kicad_sch, Battery Management Unit (BMU).kicad_sch]
2026-05-09 add libraries for BMU+CMU
    [691382000003.step, CEP99-102.SchLib, CEP99-102.stp, CEP99102.PcbLib, EDI2CAP.CFG, MCP2562FDT-H_SN.step, OKI-78SR-5_1.5-W36-C.step, QFP50P1200X1200X160-64N.PcbLib]
2026-05-09 Update shunt circuit hardware files
    [Shunt circuit.kicad_pcb, Shunt circuit.kicad_sch]
2026-05-09 Add shunt circuit custom libraries
    [ISO7710FQDRQ1.step]
2026-05-09 A bit of layout polish and bring in the correct stackup and DRUs from OSH Park
    [Battery Management Unit (BMU).kicad_pcb]
2026-05-09 Replace shunt circuit libraries and update KiCad files
    [ISO7710FQDRQ1.step, Shunt circuit.kicad_pcb, Shunt circuit.kicad_sch]
2026-05-10 update libraries+bmu
    [691382000003.step, BMU-COM Bridge.kicad_sch, BMU-MCU.kicad_sch, BMU-POWER.kicad_sch, Battery Management Unit (BMU).kicad_pcb, Battery Management Unit (BMU).kicad_sch, MCP2562FDT-H_SN.step, OKI-78SR-5_1.5-W36-C.step]
2026-05-10 update CMU
    [Cell Monitoring Unit (CMU).kicad_pcb, Cell Monitoring Unit (CMU).kicad_sch]
2026-05-11 edit footprint library
    [691382000003.step, CEP99-102.SchLib, CEP99-102.stp, CEP99102.PcbLib, EDI2CAP.CFG, MCP2562FDT-H_SN.step, OKI-78SR-5_1.5-W36-C.step, QFP50P1200X1200X160-64N.PcbLib]
2026-05-12 Added a debug module to more cleanly print debug outputs to serial monitor
2026-05-12 add via for bmu
    [Battery Management Unit (BMU).kicad_pcb]
2026-05-14 Fixed shunt board, fixed .gitignore.
    [Shunt circuit.kicad_pcb, Shunt circuit.kicad_sch]
2026-05-14 Rounded board outline
    [Shunt circuit.kicad_pcb]
2026-05-14 Schematic cleanup; lots of missing library files
    [BMU-COM Bridge.kicad_sch, BMU-MCU.kicad_sch, BMU-POWER.kicad_sch, Battery Management Unit (BMU).kicad_pcb, Battery Management Unit (BMU).kicad_sch]
2026-05-14 fix library paths
    [Battery Management Unit (BMU).kicad_pcb]
2026-05-15 Fixed all missing symbol and footprint libraries
    [BMU-POWER.kicad_sch, Battery Management Unit (BMU).kicad_sch, Cell Monitoring Unit (CMU).kicad_sch]
2026-05-18 Added I2C communication and INA238 protocol support
2026-05-18 Added current monitoring functionality and current debug printing
2026-05-19 doubled up pin for bmu
    [BMU-COM Bridge.kicad_sch, BMU-MCU.kicad_sch, Battery Management Unit (BMU).kicad_pcb, Battery Management Unit (BMU).kicad_sch, Shunt circuit.kicad_pcb, Shunt circuit.kicad_sch]
2026-05-19 add bom
    [BMU BOM.xlsx, CMU BOM.xlsx, Cell Monitoring Unit (CMU).kicad_pcb]
2026-05-20 Added ability to toggle battery monitoring functionalities
2026-05-20 Fixed conditional debug fault printing
2026-05-27 updated cmu BOM
    [BMU BOM.xlsx, CMU BOM.xlsx]
2026-05-27 Added CAN-FD BMS telemetry transmission
2026-05-27 Big schematic cleanup - made into hierarchical schematic, lots of checking on power, more text notes.
    [Cell Monitoring Unit (CMU).kicad_pcb, Cell Monitoring Unit (CMU).kicad_sch, cmu-BQ79616.kicad_sch, cmu-cell-filtering.kicad_sch, cmu-isolation.kicad_sch]
2026-05-27 A bit more schematic polishing
    [cmu-BQ79616.kicad_sch, cmu-isolation.kicad_sch]
2026-05-27 Add keepout rules for high voltage areas
    [Cell Monitoring Unit (CMU).kicad_pcb]
2026-05-27 fix BOM
    [CMU BOM.xlsx]
2026-05-28 Update shunt circuit files and add BOM
    [Shunt circuit.kicad_sch]
2026-05-28 Remove shunt BOM CSV from repo
    [Shunt circuit.csv]
2026-05-28 updated cmu layout
    [Cell Monitoring Unit (CMU).kicad_pcb, Cell Monitoring Unit (CMU).kicad_sch, cmu-BQ79616.kicad_sch, cmu-cell-filtering.kicad_sch, cmu-isolation.kicad_sch]
2026-05-28 change iso+update cmu BOM
    [Cell Monitoring Unit (CMU).kicad_pcb, Cell Monitoring Unit (CMU).kicad_sch, cmu-BQ79616.kicad_sch, cmu-cell-filtering.kicad_sch, cmu-isolation.kicad_sch]
2026-05-28 finish! update bmu layout+BOM
    [BMU-COM Bridge.kicad_sch, BMU-MCU.kicad_sch, BMU-POWER.kicad_sch, Battery Management Unit (BMU).kicad_pcb, Battery Management Unit (BMU).kicad_sch, Cell Monitoring Unit (CMU).kicad_pcb, cmu-BQ79616.kicad_sch]
2026-05-30 add jumper+ change SW for bmu
    [100SP1T1B4M2QE.step, BMU-POWER.kicad_sch, Battery Management Unit (BMU).kicad_pcb, Battery Management Unit (BMU).kicad_sch, Cell Monitoring Unit (CMU).kicad_pcb, Cell Monitoring Unit (CMU).kicad_sch]
2026-06-02 Made a nicer symbol, cleaned up ERC, cleaned up DRC, fabricated
    [Shunt circuit.kicad_pcb, Shunt circuit.kicad_sch]
2026-06-02 Rounded corners, better board silk, stitching vias
    [Cell Monitoring Unit (CMU).kicad_pcb, Cell Monitoring Unit (CMU).kicad_sch, cmu-BQ79616.kicad_sch, cmu-cell-filtering.kicad_sch, cmu-isolation.kicad_sch]
2026-06-02 Polishing, BOM fixes, stitching
    [BMU-COM Bridge.kicad_sch, BMU-MCU.kicad_sch, BMU-POWER.kicad_sch, Battery Management Unit (BMU).kicad_pcb, Battery Management Unit (BMU).kicad_sch]
2026-06-05 Added CAN telemetry debug printing functionality
2026-06-06 Added CAN telemetry frame metadata to debug output
2026-06-06 Increased main thread stack size
